PaulMaxAvalosAguilar/NN54/ABISoftware/Encoder-SDT/AndroidR/android-build/build/intermediates/manifest_merge_blame_file/release/manifest-merger-blame-release-report.txt

1<?xml version="1.0" encoding="utf-8"?>
2<manifest xmlns:android="http://schemas.android.com/apk/res/android"
3    package="org.qtproject.example"
4    android:installLocation="auto"
5    android:versionCode="1"
6    android:versionName="1.0" >
7
8    <uses-sdk
8-->D:\pauld\Programming\NN54\ABISoftware\Encoder-SDT\AndroidR\android-build\AndroidManifest.xml:3:5-73
9        android:minSdkVersion="21"
9-->D:\pauld\Programming\NN54\ABISoftware\Encoder-SDT\AndroidR\android-build\AndroidManifest.xml:3:15-41
10        android:targetSdkVersion="28" />
10-->D:\pauld\Programming\NN54\ABISoftware\Encoder-SDT\AndroidR\android-build\AndroidManifest.xml:3:42-71
11
12    <!--
13         The following comment will be replaced upon deployment with default permissions based on the dependencies of the application.
14         Remove the comment if you do not require these default permissions.
15    -->
16    <uses-permission android:name="android.permission.INTERNET" />
16-->D:\pauld\Programming\NN54\ABISoftware\Encoder-SDT\AndroidR\android-build\AndroidManifest.xml:7:5-67
16-->D:\pauld\Programming\NN54\ABISoftware\Encoder-SDT\AndroidR\android-build\AndroidManifest.xml:7:22-64
17    <uses-permission android:name="android.permission.WRITE_EXTERNAL_STORAGE" />
17-->D:\pauld\Programming\NN54\ABISoftware\Encoder-SDT\AndroidR\android-build\AndroidManifest.xml:8:5-81
17-->D:\pauld\Programming\NN54\ABISoftware\Encoder-SDT\AndroidR\android-build\AndroidManifest.xml:8:22-78
18    <uses-permission android:name="android.permission.ACCESS_NETWORK_STATE" />
18-->D:\pauld\Programming\NN54\ABISoftware\Encoder-SDT\AndroidR\android-build\AndroidManifest.xml:9:5-79
18-->D:\pauld\Programming\NN54\ABISoftware\Encoder-SDT\AndroidR\android-build\AndroidManifest.xml:9:22-76
19    <uses-permission android:name="android.permission.BLUETOOTH" />
19-->D:\pauld\Programming\NN54\ABISoftware\Encoder-SDT\AndroidR\android-build\AndroidManifest.xml:10:5-68
19-->D:\pauld\Programming\NN54\ABISoftware\Encoder-SDT\AndroidR\android-build\AndroidManifest.xml:10:22-65
20    <uses-permission android:name="android.permission.BLUETOOTH_ADMIN" />
20-->D:\pauld\Programming\NN54\ABISoftware\Encoder-SDT\AndroidR\android-build\AndroidManifest.xml:11:5-74
20-->D:\pauld\Programming\NN54\ABISoftware\Encoder-SDT\AndroidR\android-build\AndroidManifest.xml:11:22-71
21    <uses-permission android:name="android.permission.ACCESS_COARSE_LOCATION" />
21-->D:\pauld\Programming\NN54\ABISoftware\Encoder-SDT\AndroidR\android-build\AndroidManifest.xml:12:5-81
21-->D:\pauld\Programming\NN54\ABISoftware\Encoder-SDT\AndroidR\android-build\AndroidManifest.xml:12:22-78
22    <uses-permission android:name="android.permission.CAMERA" />
22-->D:\pauld\Programming\NN54\ABISoftware\Encoder-SDT\AndroidR\android-build\AndroidManifest.xml:13:5-65
22-->D:\pauld\Programming\NN54\ABISoftware\Encoder-SDT\AndroidR\android-build\AndroidManifest.xml:13:22-62
23    <uses-permission android:name="android.permission.RECORD_AUDIO" />
23-->D:\pauld\Programming\NN54\ABISoftware\Encoder-SDT\AndroidR\android-build\AndroidManifest.xml:14:5-71
23-->D:\pauld\Programming\NN54\ABISoftware\Encoder-SDT\AndroidR\android-build\AndroidManifest.xml:14:22-68
24
25    <!--
26         The following comment will be replaced upon deployment with default features based on the dependencies of the application.
27         Remove the comment if you do not require these default features.
28    -->
29    <uses-feature
29-->D:\pauld\Programming\NN54\ABISoftware\Encoder-SDT\AndroidR\android-build\AndroidManifest.xml:18:5-85
30        android:name="android.hardware.camera"
30-->D:\pauld\Programming\NN54\ABISoftware\Encoder-SDT\AndroidR\android-build\AndroidManifest.xml:18:19-57
31        android:required="false" />
31-->D:\pauld\Programming\NN54\ABISoftware\Encoder-SDT\AndroidR\android-build\AndroidManifest.xml:18:58-82
32    <uses-feature
32-->D:\pauld\Programming\NN54\ABISoftware\Encoder-SDT\AndroidR\android-build\AndroidManifest.xml:19:5-95
33        android:name="android.hardware.camera.autofocus"
33-->D:\pauld\Programming\NN54\ABISoftware\Encoder-SDT\AndroidR\android-build\AndroidManifest.xml:19:19-67
34        android:required="false" />
34-->D:\pauld\Programming\NN54\ABISoftware\Encoder-SDT\AndroidR\android-build\AndroidManifest.xml:19:68-92
35    <uses-feature
35-->D:\pauld\Programming\NN54\ABISoftware\Encoder-SDT\AndroidR\android-build\AndroidManifest.xml:20:5-89
36        android:name="android.hardware.microphone"
36-->D:\pauld\Programming\NN54\ABISoftware\Encoder-SDT\AndroidR\android-build\AndroidManifest.xml:20:19-61
37        android:required="false" />
37-->D:\pauld\Programming\NN54\ABISoftware\Encoder-SDT\AndroidR\android-build\AndroidManifest.xml:20:62-86
38
39    <supports-screens
39-->D:\pauld\Programming\NN54\ABISoftware\Encoder-SDT\AndroidR\android-build\AndroidManifest.xml:22:5-135
40        android:anyDensity="true"
40-->D:\pauld\Programming\NN54\ABISoftware\Encoder-SDT\AndroidR\android-build\AndroidManifest.xml:22:80-105
41        android:largeScreens="true"
41-->D:\pauld\Programming\NN54\ABISoftware\Encoder-SDT\AndroidR\android-build\AndroidManifest.xml:22:23-50
42        android:normalScreens="true"
42-->D:\pauld\Programming\NN54\ABISoftware\Encoder-SDT\AndroidR\android-build\AndroidManifest.xml:22:51-79
43        android:smallScreens="true" />
43-->D:\pauld\Programming\NN54\ABISoftware\Encoder-SDT\AndroidR\android-build\AndroidManifest.xml:22:106-133
44
45    <application
45-->D:\pauld\Programming\NN54\ABISoftware\Encoder-SDT\AndroidR\android-build\AndroidManifest.xml:24:5-94:19
46        android:name="org.qtproject.qt5.android.bindings.QtApplication"
46-->D:\pauld\Programming\NN54\ABISoftware\Encoder-SDT\AndroidR\android-build\AndroidManifest.xml:24:53-116
47        android:extractNativeLibs="true"
47-->D:\pauld\Programming\NN54\ABISoftware\Encoder-SDT\AndroidR\android-build\AndroidManifest.xml:24:145-177
48        android:hardwareAccelerated="true"
48-->D:\pauld\Programming\NN54\ABISoftware\Encoder-SDT\AndroidR\android-build\AndroidManifest.xml:24:18-52
49        android:icon="@drawable/icon"
49-->D:\pauld\Programming\NN54\ABISoftware\Encoder-SDT\AndroidR\android-build\AndroidManifest.xml:24:178-207
50        android:label="Encoder-SDT" >
50-->D:\pauld\Programming\NN54\ABISoftware\Encoder-SDT\AndroidR\android-build\AndroidManifest.xml:24:117-144
51        <activity
51-->D:\pauld\Programming\NN54\ABISoftware\Encoder-SDT\AndroidR\android-build\AndroidManifest.xml:25:9-90:16
52            android:name="org.qtproject.qt5.android.bindings.QtActivity"
52-->D:\pauld\Programming\NN54\ABISoftware\Encoder-SDT\AndroidR\android-build\AndroidManifest.xml:25:189-249
53            android:configChanges="orientation|uiMode|screenLayout|screenSize|smallestScreenSize|layoutDirection|locale|fontScale|keyboard|keyboardHidden|navigation|mcc|mnc|density"
53-->D:\pauld\Programming\NN54\ABISoftware\Encoder-SDT\AndroidR\android-build\AndroidManifest.xml:25:19-188
54            android:label="Encoder-SDT"
54-->D:\pauld\Programming\NN54\ABISoftware\Encoder-SDT\AndroidR\android-build\AndroidManifest.xml:25:250-277
55            android:launchMode="singleTop"
55-->D:\pauld\Programming\NN54\ABISoftware\Encoder-SDT\AndroidR\android-build\AndroidManifest.xml:25:322-352
56            android:screenOrientation="sensorLandscape" >
56-->D:\pauld\Programming\NN54\ABISoftware\Encoder-SDT\AndroidR\android-build\AndroidManifest.xml:25:278-321
57            <intent-filter>
57-->D:\pauld\Programming\NN54\ABISoftware\Encoder-SDT\AndroidR\android-build\AndroidManifest.xml:26:13-29:29
58                <action android:name="android.intent.action.MAIN" />
58-->D:\pauld\Programming\NN54\ABISoftware\Encoder-SDT\AndroidR\android-build\AndroidManifest.xml:27:17-68
58-->D:\pauld\Programming\NN54\ABISoftware\Encoder-SDT\AndroidR\android-build\AndroidManifest.xml:27:25-66
59
60                <category android:name="android.intent.category.LAUNCHER" />
60-->D:\pauld\Programming\NN54\ABISoftware\Encoder-SDT\AndroidR\android-build\AndroidManifest.xml:28:17-76
60-->D:\pauld\Programming\NN54\ABISoftware\Encoder-SDT\AndroidR\android-build\AndroidManifest.xml:28:27-74
61            </intent-filter>
62
63            <!-- Application arguments -->
64            <!-- meta-data android:name="android.app.arguments" android:value="arg1 arg2 arg3"/ -->
65            <!-- Application arguments -->
66
67            <meta-data
67-->D:\pauld\Programming\NN54\ABISoftware\Encoder-SDT\AndroidR\android-build\AndroidManifest.xml:35:13-89
68                android:name="android.app.lib_name"
68-->D:\pauld\Programming\NN54\ABISoftware\Encoder-SDT\AndroidR\android-build\AndroidManifest.xml:35:24-59
69                android:value="Encoder-SDT" />
69-->D:\pauld\Programming\NN54\ABISoftware\Encoder-SDT\AndroidR\android-build\AndroidManifest.xml:35:60-87
70            <meta-data
70-->D:\pauld\Programming\NN54\ABISoftware\Encoder-SDT\AndroidR\android-build\AndroidManifest.xml:36:13-112
71                android:name="android.app.qt_sources_resource_id"
71-->D:\pauld\Programming\NN54\ABISoftware\Encoder-SDT\AndroidR\android-build\AndroidManifest.xml:36:24-73
72                android:resource="@array/qt_sources" />
72-->D:\pauld\Programming\NN54\ABISoftware\Encoder-SDT\AndroidR\android-build\AndroidManifest.xml:36:74-110
73            <meta-data
73-->D:\pauld\Programming\NN54\ABISoftware\Encoder-SDT\AndroidR\android-build\AndroidManifest.xml:37:13-87
74                android:name="android.app.repository"
74-->D:\pauld\Programming\NN54\ABISoftware\Encoder-SDT\AndroidR\android-build\AndroidManifest.xml:37:24-61
75                android:value="default" />
75-->D:\pauld\Programming\NN54\ABISoftware\Encoder-SDT\AndroidR\android-build\AndroidManifest.xml:37:62-85
76            <meta-data
76-->D:\pauld\Programming\NN54\ABISoftware\Encoder-SDT\AndroidR\android-build\AndroidManifest.xml:38:13-106
77                android:name="android.app.qt_libs_resource_id"
77-->D:\pauld\Programming\NN54\ABISoftware\Encoder-SDT\AndroidR\android-build\AndroidManifest.xml:38:24-70
78                android:resource="@array/qt_libs" />
78-->D:\pauld\Programming\NN54\ABISoftware\Encoder-SDT\AndroidR\android-build\AndroidManifest.xml:38:71-104
79            <meta-data
79-->D:\pauld\Programming\NN54\ABISoftware\Encoder-SDT\AndroidR\android-build\AndroidManifest.xml:39:13-116
80                android:name="android.app.bundled_libs_resource_id"
80-->D:\pauld\Programming\NN54\ABISoftware\Encoder-SDT\AndroidR\android-build\AndroidManifest.xml:39:24-75
81                android:resource="@array/bundled_libs" />
81-->D:\pauld\Programming\NN54\ABISoftware\Encoder-SDT\AndroidR\android-build\AndroidManifest.xml:39:76-114
82            <!-- Deploy Qt libs as part of package -->
83            <meta-data
83-->D:\pauld\Programming\NN54\ABISoftware\Encoder-SDT\AndroidR\android-build\AndroidManifest.xml:41:13-91
84                android:name="android.app.bundle_local_qt_libs"
84-->D:\pauld\Programming\NN54\ABISoftware\Encoder-SDT\AndroidR\android-build\AndroidManifest.xml:41:24-71
85                android:value="1" />
85-->D:\pauld\Programming\NN54\ABISoftware\Encoder-SDT\AndroidR\android-build\AndroidManifest.xml:41:72-89
86
87            <!-- Run with local libs -->
88            <meta-data
88-->D:\pauld\Programming\NN54\ABISoftware\Encoder-SDT\AndroidR\android-build\AndroidManifest.xml:44:13-88
89                android:name="android.app.use_local_qt_libs"
89-->D:\pauld\Programming\NN54\ABISoftware\Encoder-SDT\AndroidR\android-build\AndroidManifest.xml:44:24-68
90                android:value="1" />
90-->D:\pauld\Programming\NN54\ABISoftware\Encoder-SDT\AndroidR\android-build\AndroidManifest.xml:44:69-86
91            <meta-data
91-->D:\pauld\Programming\NN54\ABISoftware\Encoder-SDT\AndroidR\android-build\AndroidManifest.xml:45:13-100
92                android:name="android.app.libs_prefix"
92-->D:\pauld\Programming\NN54\ABISoftware\Encoder-SDT\AndroidR\android-build\AndroidManifest.xml:45:24-62
93                android:value="/data/local/tmp/qt/" />
93-->D:\pauld\Programming\NN54\ABISoftware\Encoder-SDT\AndroidR\android-build\AndroidManifest.xml:45:63-98
94            <meta-data
94-->D:\pauld\Programming\NN54\ABISoftware\Encoder-SDT\AndroidR\android-build\AndroidManifest.xml:46:13-122
95                android:name="android.app.load_local_libs_resource_id"
95-->D:\pauld\Programming\NN54\ABISoftware\Encoder-SDT\AndroidR\android-build\AndroidManifest.xml:46:24-78
96                android:resource="@array/load_local_libs" />
96-->D:\pauld\Programming\NN54\ABISoftware\Encoder-SDT\AndroidR\android-build\AndroidManifest.xml:46:79-120
97            <meta-data
97-->D:\pauld\Programming\NN54\ABISoftware\Encoder-SDT\AndroidR\android-build\AndroidManifest.xml:47:13-221
98                android:name="android.app.load_local_jars"
98-->D:\pauld\Programming\NN54\ABISoftware\Encoder-SDT\AndroidR\android-build\AndroidManifest.xml:47:24-66
99                android:value="jar/QtAndroid.jar:jar/QtAndroidExtras.jar:jar/QtAndroidBearer.jar:jar/QtAndroidBluetooth.jar:jar/QtMultimedia.jar:jar/QtTextToSpeech.jar" />
99-->D:\pauld\Programming\NN54\ABISoftware\Encoder-SDT\AndroidR\android-build\AndroidManifest.xml:47:67-219
100            <meta-data
100-->D:\pauld\Programming\NN54\ABISoftware\Encoder-SDT\AndroidR\android-build\AndroidManifest.xml:48:13-208
101                android:name="android.app.static_init_classes"
101-->D:\pauld\Programming\NN54\ABISoftware\Encoder-SDT\AndroidR\android-build\AndroidManifest.xml:48:24-70
102                android:value="org.qtproject.qt5.android.bluetooth.QtBluetoothBroadcastReceiver:org.qtproject.qt5.android.multimedia.QtMultimediaUtils" />
102-->D:\pauld\Programming\NN54\ABISoftware\Encoder-SDT\AndroidR\android-build\AndroidManifest.xml:48:71-206
103            <!-- Used to specify custom system library path to run with local system libs -->
104            <!-- <meta-data android:name="android.app.system_libs_prefix" android:value="/system/lib/"/> -->
105            <!-- Messages maps -->
106            <meta-data
106-->D:\pauld\Programming\NN54\ABISoftware\Encoder-SDT\AndroidR\android-build\AndroidManifest.xml:52:13-122
107                android:name="android.app.ministro_not_found_msg"
107-->D:\pauld\Programming\NN54\ABISoftware\Encoder-SDT\AndroidR\android-build\AndroidManifest.xml:52:71-120
108                android:value="@string/ministro_not_found_msg" />
108-->D:\pauld\Programming\NN54\ABISoftware\Encoder-SDT\AndroidR\android-build\AndroidManifest.xml:52:24-70
109            <meta-data
109-->D:\pauld\Programming\NN54\ABISoftware\Encoder-SDT\AndroidR\android-build\AndroidManifest.xml:53:13-116
110                android:name="android.app.ministro_needed_msg"
110-->D:\pauld\Programming\NN54\ABISoftware\Encoder-SDT\AndroidR\android-build\AndroidManifest.xml:53:68-114
111                android:value="@string/ministro_needed_msg" />
111-->D:\pauld\Programming\NN54\ABISoftware\Encoder-SDT\AndroidR\android-build\AndroidManifest.xml:53:24-67
112            <meta-data
112-->D:\pauld\Programming\NN54\ABISoftware\Encoder-SDT\AndroidR\android-build\AndroidManifest.xml:54:13-108
113                android:name="android.app.fatal_error_msg"
113-->D:\pauld\Programming\NN54\ABISoftware\Encoder-SDT\AndroidR\android-build\AndroidManifest.xml:54:64-106
114                android:value="@string/fatal_error_msg" />
114-->D:\pauld\Programming\NN54\ABISoftware\Encoder-SDT\AndroidR\android-build\AndroidManifest.xml:54:24-63
115            <meta-data
115-->D:\pauld\Programming\NN54\ABISoftware\Encoder-SDT\AndroidR\android-build\AndroidManifest.xml:55:13-132
116                android:name="android.app.unsupported_android_version"
116-->D:\pauld\Programming\NN54\ABISoftware\Encoder-SDT\AndroidR\android-build\AndroidManifest.xml:55:76-130
117                android:value="@string/unsupported_android_version" />
117-->D:\pauld\Programming\NN54\ABISoftware\Encoder-SDT\AndroidR\android-build\AndroidManifest.xml:55:24-75
118            <!-- Messages maps -->
119
120
121            <!-- Splash screen -->
122            <!--
123                 Orientation-specific (portrait/landscape) data is checked first. If not available for current orientation,
124                 then android.app.splash_screen_drawable. For best results, use together with splash_screen_sticky and
125                 use hideSplashScreen() with a fade-out animation from Qt Android Extras to hide the splash screen when you
126                 are done populating your window with content.
127            -->
128            <!-- meta-data android:name="android.app.splash_screen_drawable_portrait" android:resource="@drawable/logo_portrait" / -->
129            <!-- meta-data android:name="android.app.splash_screen_drawable_landscape" android:resource="@drawable/logo_landscape" / -->
130            <!-- meta-data android:name="android.app.splash_screen_drawable" android:resource="@drawable/logo"/ -->
131            <!-- meta-data android:name="android.app.splash_screen_sticky" android:value="true"/ -->
132            <!-- Splash screen -->
133
134
135            <!-- Background running -->
136            <!--
137                 Warning: changing this value to true may cause unexpected crashes if the
138                          application still try to draw after
139                          "applicationStateChanged(Qt::ApplicationSuspended)"
140                          signal is sent!
141            -->
142            <meta-data
142-->D:\pauld\Programming\NN54\ABISoftware\Encoder-SDT\AndroidR\android-build\AndroidManifest.xml:74:13-93
143                android:name="android.app.background_running"
143-->D:\pauld\Programming\NN54\ABISoftware\Encoder-SDT\AndroidR\android-build\AndroidManifest.xml:74:24-69
144                android:value="false" />
144-->D:\pauld\Programming\NN54\ABISoftware\Encoder-SDT\AndroidR\android-build\AndroidManifest.xml:74:70-91
145            <!-- Background running -->
146
147
148            <!-- auto screen scale factor -->
149            <meta-data
149-->D:\pauld\Programming\NN54\ABISoftware\Encoder-SDT\AndroidR\android-build\AndroidManifest.xml:78:13-99
150                android:name="android.app.auto_screen_scale_factor"
150-->D:\pauld\Programming\NN54\ABISoftware\Encoder-SDT\AndroidR\android-build\AndroidManifest.xml:78:24-75
151                android:value="false" />
151-->D:\pauld\Programming\NN54\ABISoftware\Encoder-SDT\AndroidR\android-build\AndroidManifest.xml:78:76-97
152            <!-- auto screen scale factor -->
153
154
155            <!-- extract android style -->
156            <!--
157                 available android:values :
158                * default - In most cases this will be the same as "full", but it can also be something else if needed, e.g., for compatibility reasons
159                * full - useful QWidget & Quick Controls 1 apps
160                * minimal - useful for Quick Controls 2 apps, it is much faster than "full"
161                * none - useful for apps that don't use any of the above Qt modules
162            -->
163            <meta-data
163-->D:\pauld\Programming\NN54\ABISoftware\Encoder-SDT\AndroidR\android-build\AndroidManifest.xml:88:13-98
164                android:name="android.app.extract_android_style"
164-->D:\pauld\Programming\NN54\ABISoftware\Encoder-SDT\AndroidR\android-build\AndroidManifest.xml:88:24-72
165                android:value="default" />
165-->D:\pauld\Programming\NN54\ABISoftware\Encoder-SDT\AndroidR\android-build\AndroidManifest.xml:88:73-96
166            <!-- extract android style -->
167        </activity>
168
169        <!-- For adding service(s) please check: https://wiki.qt.io/AndroidServices -->
170
171    </application>
172
173</manifest>
