PaulMaxAvalosAguilar/NN54/Mechatronics/Hardware/Electrical/LoadSharingCalculations.ods

DiodeMaxLeakageCurrent | 5E-05
PMOSMaxVgths | 1
BattMax Voltage | 4.5
BattMin Voltage | 2.4
Resistor | 10000
DiodeResistance | 90000
R2 | 0.45
MaxAllowedVoltage | 1.4
