PaulMaxAvalosAguilar/NN54/Logo.pdf

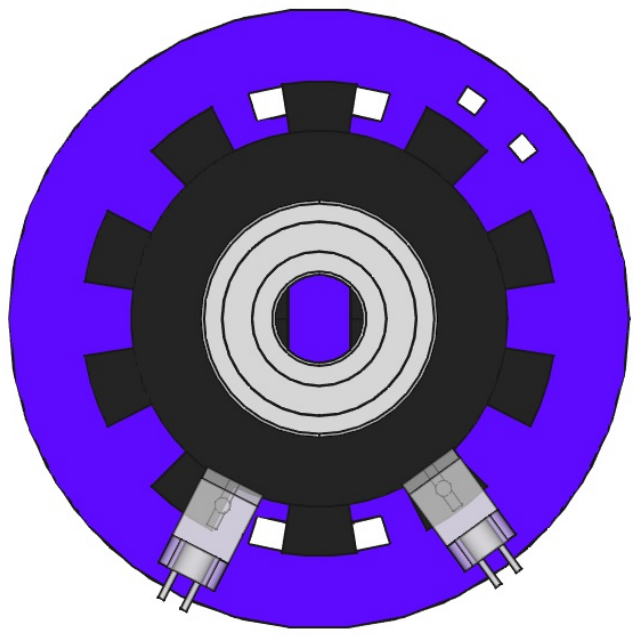
[picture p3: page 1]
