PaulMaxAvalosAguilar/NN54/Corporative/Accelera.png

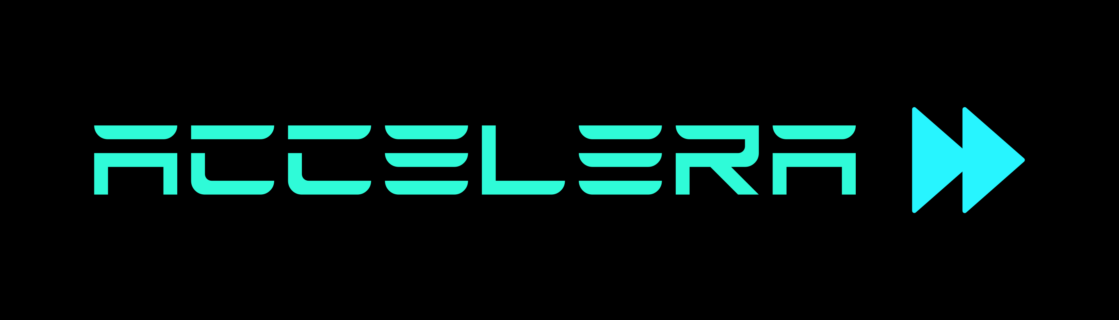
Corporative/Accelera.png
