PaulMaxAvalosAguilar/NN54/Corporative/BoxLabels.png

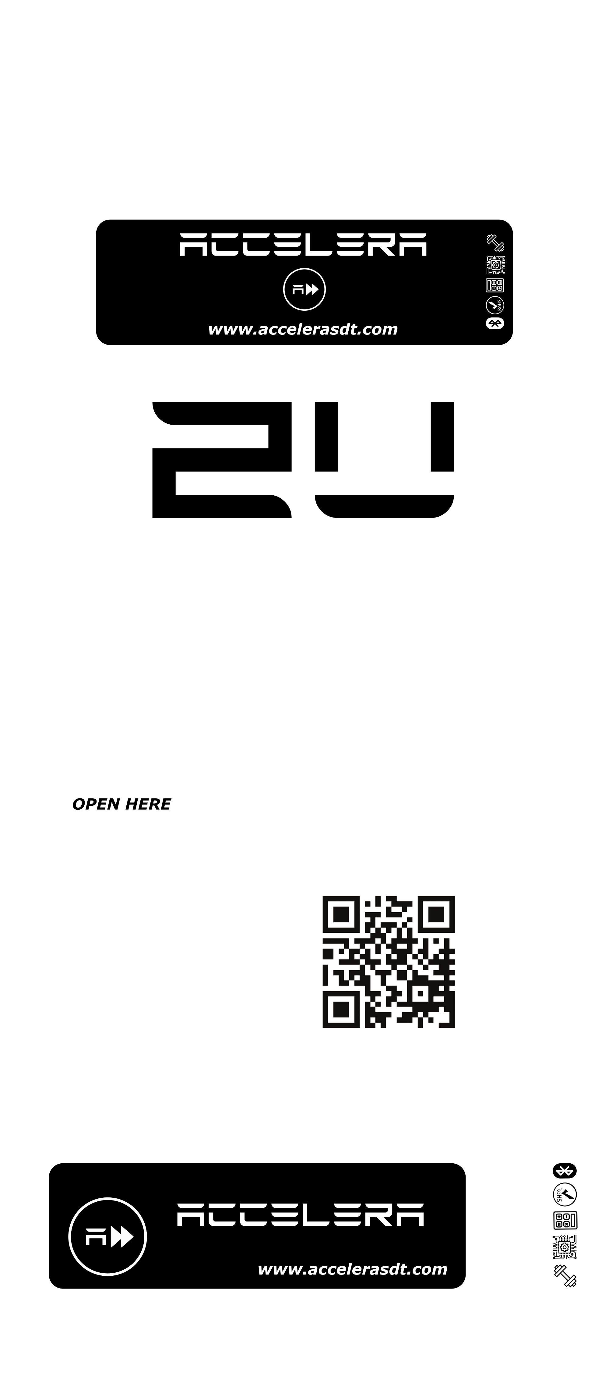
Corporative/BoxLabels.png
