PaulMaxAvalosAguilar/NN54/Corporative/NPULTRA.png

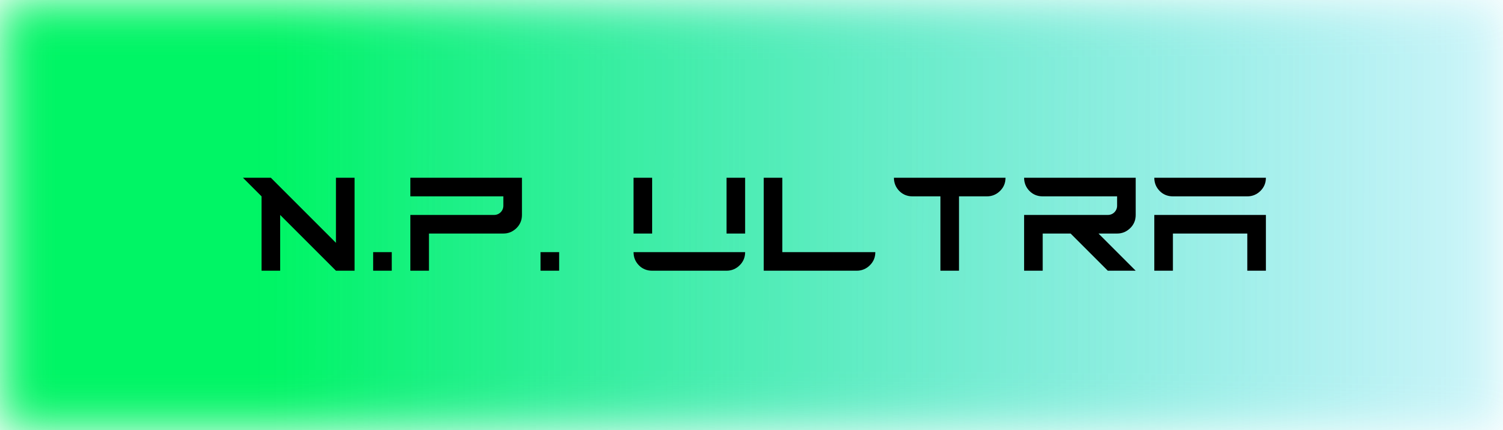
Corporative/NPULTRA.png
