PaulMaxAvalosAguilar/NN54/Mechatronics/Hardware/Electrical/CBOM/EncoderBoard2.xlsx

Item | Qty | Reference(s) | Value | Footprint
1 | 2 | C1, C2 | 12pF | Encoder:C_0603_1608Metric_Pad1.05x0.95mm_HandSolder
2 | 2 | C3, C17 | 4.7uF | Encoder:C_0603_1608Metric_Pad1.05x0.95mm_HandSolder
3 | 7 | C4, C5, C8, C9, C15, C27, C27 | 100nF | Encoder:C_0603_1608Metric_Pad1.05x0.95mm_HandSolder
4 | 6 | C6, C10, C12, C13, C16, C18 | 1uF | Encoder:C_0603_1608Metric_Pad1.05x0.95mm_HandSolder
5 | 1 | C7 | 10nF | Encoder:C_0603_1608Metric_Pad1.05x0.95mm_HandSolder
6 | 2 | C11, C14 | 10uF | Encoder:C_0603_1608Metric_Pad1.05x0.95mm_HandSolder
7 | 8 | C19, C20, C21, C22, C23, C24, C25, C26 | 3.2uF | Encoder:C_0603_1608Metric_Pad1.05x0.95mm_HandSolder
8 | 1 | J3 | Barrel_Jack_Switch | Encoder:BarrelJack_Horizontal
9 | 1 | J1 | Conn_01x08_Male | Encoder:PinHeader_1x08_P2.54mm_Vertical
10 | 1 | J2 | Conn_01x07_Male | Encoder:PinHeader_1x07_P2.54mm_Vertical
11 | 1 | J4 | GNDPWR | Encoder:PinHeader_1x01_P2.54mm_Vertical
12 | 1 | J5 | Conn_01x02_Male | Encoder:PinHeader_1x02_P2.54mm_Vertical
13 | 1 | J6 | Conn_01x04_Male | Encoder:PinHeader_2x02_P2.54mm_Vertical
14 | 2 | U2,U3 | ITR8102_Conn | Encoder:PinHeader_2x02_P2.54mm_Vertical
15 | 1 | S1 | EG1218_Conn | Encoder:PinHeader_1x04_P2.54mm_Vertical
16 | 2 | R1, R2 | 560 | Encoder:R_0603_1608Metric_Pad1.05x0.95mm_HandSolder
17 | 2 | R3, R4 | 1.2K | Encoder:R_0603_1608Metric_Pad1.05x0.95mm_HandSolder
18 | 1 | R6 | 1.5K | Encoder:R_0603_1608Metric_Pad1.05x0.95mm_HandSolder | 1/16 5%
19 | 5 | R5, R9, R10, R19, R20 | 10K | Encoder:R_0603_1608Metric_Pad1.05x0.95mm_HandSolder
20 | 1 | R7 | 1K | Encoder:R_0603_1608Metric_Pad1.05x0.95mm_HandSolder
21 | 9 | R8, R11, R12, R13, R14, R15, R16, R17, R18 | 100 | Encoder:R_0603_1608Metric_Pad1.05x0.95mm_HandSolder | ¼
22 | 1 | Y1 | 8Mhz | Encoder:Crystal_HC49-U_Vertical
23 | 1 | IC1 | TP4056 | Encoder:Sop(8)
24 | 1 | IC2 | DW01+G | Encoder:Sot-23(6)
25 | 1 | Q1 | Dmosfet (FS8205) | Encoder:Sot-23(6)
26 | 1 | D1 | D (1N4007G ) | Encoder:D_SMA
27 | 2 | Q2, Q3 | Q_PMOS_GSD ( DMP1045U-7) | Encoder:SOT-23
28 | 1 | U1 | STM32G431CBT6 | Encoder:LQFP-48_7x7mm_P0.5mm
29 | 1 | U4 | RN4871 | Encoder:Bluetooth_Module_RN4871
30 | 1 | U5 | 82402305 | Encoder:Sot-23(6)
31 | 1 | U6 | LTC3240 | Encoder:DFN-6_DC
32 | 1 | S1 | EG1218
33 | 2 | U7, U7 | TLE5009 | Encoder:SO-8_3.9x4.9mm_P1.27mm
34 | 1 |  | SSD1306
35 | 2 | U8,U8 | ITR8102
