PaulMaxAvalosAguilar/NN54/Mechatronics/Hardware/Electrical/CBOM/EncoderBoard3.xlsx

Item | Qty | Board1 | Board2 | Board3 | Board4 | External | Reference(s) | Value | Footprint | Quantity
1 | 2 | 2 |  |  |  |  | C1, C3 | 12pF | 0603_1608Metric | 94
2 | 9 | 7 |  |  | 2 |  | C2, C4, C5, C9, C10, C11, C16, C22, C23 | 100nF | 0603_1608Metric | 77
3 | 3 | 3 |  |  |  |  | C6, C12, C13 | 4.7uF | 0603_1608Metric | 14
4 | 1 | 1 |  |  |  |  | C7 | 10nF | 0603_1608Metric | 49
5 | 4 | 3 |  | 1 |  |  | C8, C14, C15,C21 | 1uF | 0603_1608Metric | 30
6 | 2 | 1 |  | 1 |  |  | C17, C20 | 10uF | 0603_1608Metric | 42
7 | 2 |  |  | 2 |  |  | C18, C19 |  | 0403_1005Metric
8 | 2 | 2 |  |  |  |  | R1, R3 | 1.2K | 0603_1608Metric | 96
9 | 2 | 2 |  |  |  |  | R2, R4 | 560 | 0603_1608Metric | 97
10 | 6 | 6 |  |  |  |  | R5, R7, R8, R9, R12, R16 | 10K | 0603_1608Metric | 80
11 | 2 | 2 |  |  |  |  | R6, R14 | 1K | 0603_1608Metric | 96
12 | 2 | 2 |  |  |  |  | R10, R11 | 5.1k | 0603_1608Metric
13 | 1 | 1 |  |  |  |  | R13 | 100 | 0603_1608Metric | 37
14 | 1 | 1 |  |  |  |  | R15 | 1.5K | 0603_1608Metric | 97
15 | 1 |  |  | 1 |  |  | R17 | 0 | 0403_1005Metric
16 | 1 | 1 |  |  |  |  | J8 | 1x02_Male | JST_EH_B2B-EH-A_1x02_P2.50mm_Vertical
17 | 1 | 1 |  |  |  |  | J7 | 1x03_Male | JST_EH_B2B-EH-A_1x02_P2.50mm_Vertical
18 | 2 | 2 |  |  |  |  | J3, J4 | 01x04_Male | JST_EH_B4B-EH-A_1x04_P2.50mm_Vertical
19 | 1 | 1 |  |  |  |  | J6 | 01x06_Male | JST_EH_B6B-EH-A_1x06_P2.50mm_Vertical
20 | 1 | 1 |  |  |  |  | J1 | 01x08_Male | JST_EH_B8B-EH-A_1x08_P2.50mm_Vertical
21 | 2 | 2 |  |  |  |  | J2, J5 | 01x03_Male | PinHeader_1x03_P2.54mm_Vertical | 91
22 | 23 | 23 |  |  |  |  | SEH-001T-P0.6 | SHE-001T-P0.6 | JST_EH
23 | 1 | 1 |  |  |  |  | D1 | 1N4007G | SMA | 50
24 | 2 | 2 |  |  |  |  | Q1, Q2 | DMP1045U-7 | SOT-23_PMOS_GSD | 4
25 | 2 |  | 2 |  |  |  | Q3,Q4 | ITR8102 | Sloted switch | 8
26 | 2 | 2 |  |  |  |  | U1, U2 | STM32G431KBT6 | LQFP-32_7x7mm_P0.8mm | 4
27 | 1 | 1 |  |  |  |  | U3 | LTC3240 | DFN-6_DC | 2
28 | 1 | 1 |  |  |  |  | U4 | 82402305 | Sot-23(6) | 2
29 | 1 | 1 |  |  |  |  | U5 | DW01 | Sot-23(6) | 19+46(+G)
30 | 1 | 1 |  |  |  |  | U6 | FS8205 | Sot-23(6) | 11
31 | 1 | 1 |  |  |  |  | U7 | TP4056 | Sop(8) | 49
32 | 1 |  |  | 1 |  |  | U8 | RN4871u | RN4871u
33 | 1 |  |  |  | 1 |  | U9 | LSM6DSRXTR | LSM6DSRXTR | 2
34 | 1 | 1 |  |  |  |  | Y1 | 8Mhz | Crystal_HC49-U_Vertical | 7
35 | 1 | 1 |  |  |  |  | P1 | TYPE-C-31-M-12 | HRO_TYPE-C-31-M-12
36 | 1 |  |  |  |  | 1 | S1 | EG1218 | SPDT | 8
37 | 1 |  |  |  |  | 1 | DS1 | SSD1306 | SSD1306 | 1
 |  |  |  |  |  | 3 | 3 | Spacers | 20mm
 | 89 | 76 | 2 | 6 | 3 | 5
31 | 1 | Y1 | 8Mhz | Device:Crystal | Encoder:Crystal_HC49-U_Vertical
8 | 1 | J1 | Conn_01x08_Male | Connector:Conn_01x08_Male | Encoder:JST_EH_B8B-EH-A_1x08_P2.50mm_Vertical
9 | 2 | J2, J5 | Conn_01x03_Male | Connector:Conn_01x03_Male | Encoder:PinHeader_1x03_P2.54mm_Vertical
10 | 2 | J3, J4 | Conn_01x04_Male | Connector:Conn_01x04_Male | Encoder:JST_EH_B4B-EH-A_1x04_P2.50mm_Vertical
11 | 1 | J6 | Conn_01x06_Male | Connector:Conn_01x06_Male | Encoder:JST_EH_B6B-EH-A_1x06_P2.50mm_Vertical
12 | 1 | J7 | Conn_01x03_Male | Encoder:Conn_01x03_Male | Connector_JST:JST_EH_B3B-EH-A_1x03_P2.50mm_Vertical
13 | 1 | J8 | Conn_01x02_Male | Connector:Conn_01x02_Male | Encoder:JST_EH_B2B-EH-A_1x02_P2.50mm_Vertical
14 | 1 | P1 | TYPE-C-31-M-12 | EncoderBoard3-rescue:TYPE-C-31-M-12-Encoder | Encoder:HRO_TYPE-C-31-M-12
 | 88
