PaulMaxAvalosAguilar/NN54/Mechatronics/Hardware/Electrical/BEncoderBoard/EncoderBoard_v1.0.xlsm

Component | Part | References | Value | Footprint | Quantity Per PCB
1 | C | C1 C2 C3 C5 C9 C10 C16 | 100nF | C_0603_1608Metric_Pad1.05x0.95mm_HandSolder | 7
2 | C | C6 C13 | 10uF | C_0603_1608Metric_Pad1.05x0.95mm_HandSolder | 2
3 | C | C7 C8 | 12pF | C_0603_1608Metric_Pad1.05x0.95mm_HandSolder | 2
4 | C | C4 C11 C14 C17 C18 | 1uF | C_0603_1608Metric_Pad1.05x0.95mm_HandSolder | 5
5 | C | C12 C15 | 4.7uF | C_0603_1608Metric_Pad1.05x0.95mm_HandSolder | 2
6 | D | D1 | D | D_SMA | 1
7 | DW01+G | IC3 | DW01+G | Sot-23(6) | 1
9 | TP4056 | IC2 | TP4056 | Sop(8) | 1
10 | FS8205 | Q1 | FS8205 | Sot-23(6) | 1
11 | Barrel_Jack_Switch | J4 | Barrel_Jack_Switch | BarrelJack_Horizontal | 1
12 | Conn_01x07_Male | J1 | Conn_01x07_Male | PinSocket_1x07_P2.54mm_Vertical | 1
13 | SSD1306OLED | U5 | SSD1306OLED | PinSocket_1x04_P2.54mm_Vertical | 1
8 | RN4020-V_RM120 | IC1 | RN4020-V_RM120 | Bluetooth_Module_RN4020 | 1
14 | Q_PMOS_GSD | Q2 Q3 | Q_PMOS_GSD | SOT-23 | 2
15 | R | R3 R4 R8 | 1.2K | R_0603_1608Metric_Pad1.05x0.95mm_HandSolder | 3
16 | R | R11 | 100 | R_0603_1608Metric_Pad1.05x0.95mm_HandSolder | 1 | ¼
17 | R | R5 R6 R7 R13 R14 | 10K | R_0603_1608Metric_Pad1.05x0.95mm_HandSolder | 5
18 | R | R9 | 1K | R_0603_1608Metric_Pad1.05x0.95mm_HandSolder | 1
19 | R | R1 R2 | 220 | R_0603_1608Metric_Pad1.05x0.95mm_HandSolder | 2
20 | EG1218 | S1 | EG1218 | Switch_Slide_11.6x4mm_EG1218 | 1
21 | 82402305 | U4 | 82402305 | Sot-23(6) | 1
22 | ITR1802 | U2 | ITR1802 | OptointerrupterConnector | 2
23 | LTC2430 | U6 | LTC3240 | DFN-6_DC | 1
24 | STM32F103C8T6 | U1 | STM32F103C8T6 | QFP50P900X900X160-48N | 1
25 | Crystal | Y1 | 8Mhz | Crystal_HC49-U_Vertical | 1
