PaulMaxAvalosAguilar/NN54/Mechatronics/MaterialDocumentation/BatteryPart/DC BarrelJack/XKB-DC-005B-2-5A-2-0_C319132.pdf

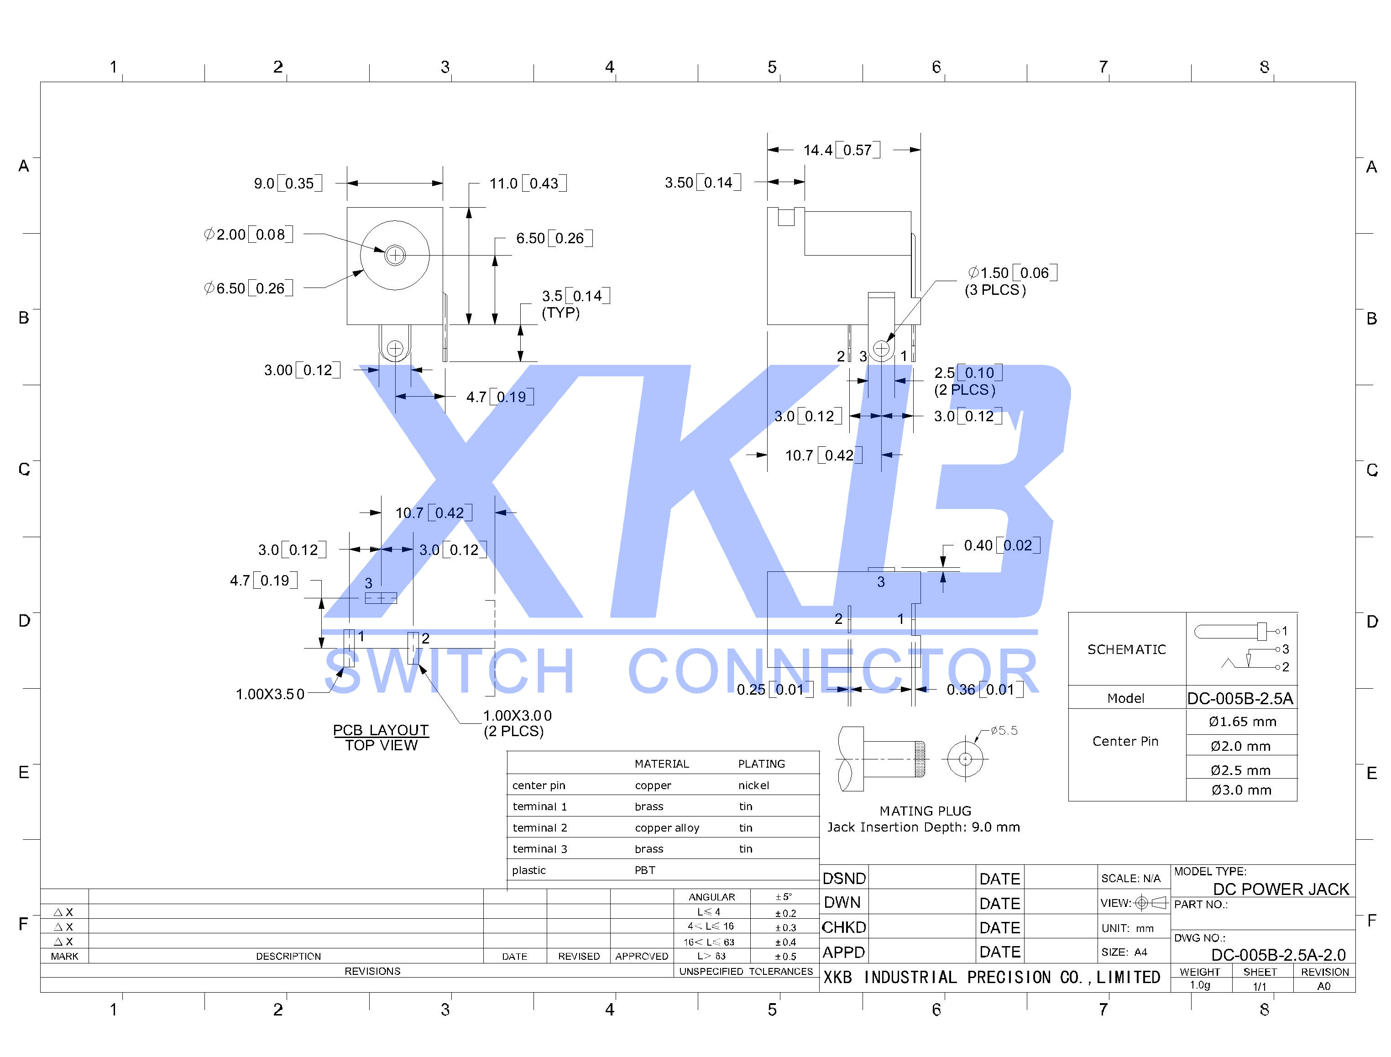
[picture p11: page 1]
