PaulMaxAvalosAguilar/NN54/Mechatronics/MaterialDocumentation/EncoderPart/OLEDScreen/29192059675_a23f346f87_o.jpg

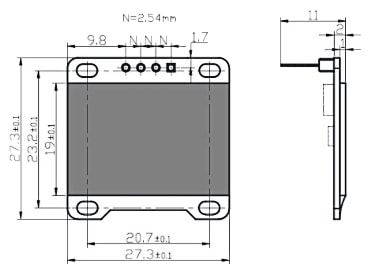
Mechatronics/MaterialDocumentation/EncoderPart/OLEDScreen/29192059675_a23f346f87_o.jpg
