PaulMaxAvalosAguilar/NN54/Mechatronics/MaterialDocumentation/EncoderPart/OLEDScreen/índice.png

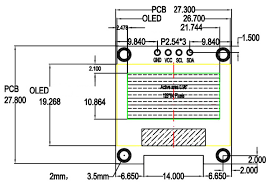
Mechatronics/MaterialDocumentation/EncoderPart/OLEDScreen/índice.png
