PaulMaxAvalosAguilar/NN54/Mechatronics/Hardware/Electrical/BEncoderBoard3(2)/BEncoderBoard3(2)(A).step

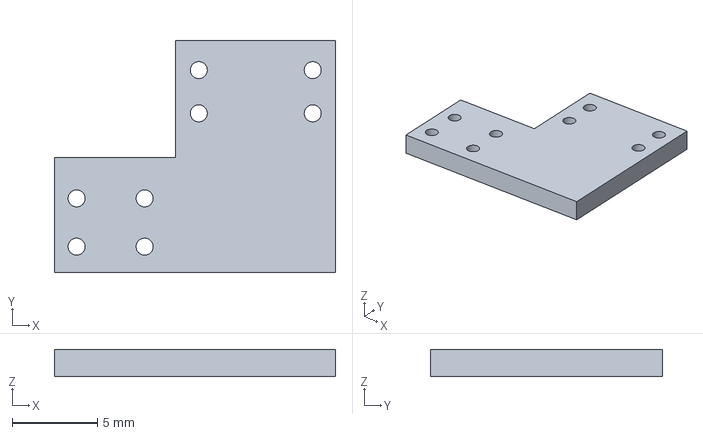
[picture p14: CAD file, 2022-12-06]
Mechatronics/Hardware/Electrical/BEncoderBoard3(2)/BEncoderBoard3(2)(A).step
16.5 x 13.7 x 1.60 mm
