PaulMaxAvalosAguilar/NN54/Mechatronics/Hardware/Electrical/BEncoderBoard3(4)/BEncoderBoard3(4).step

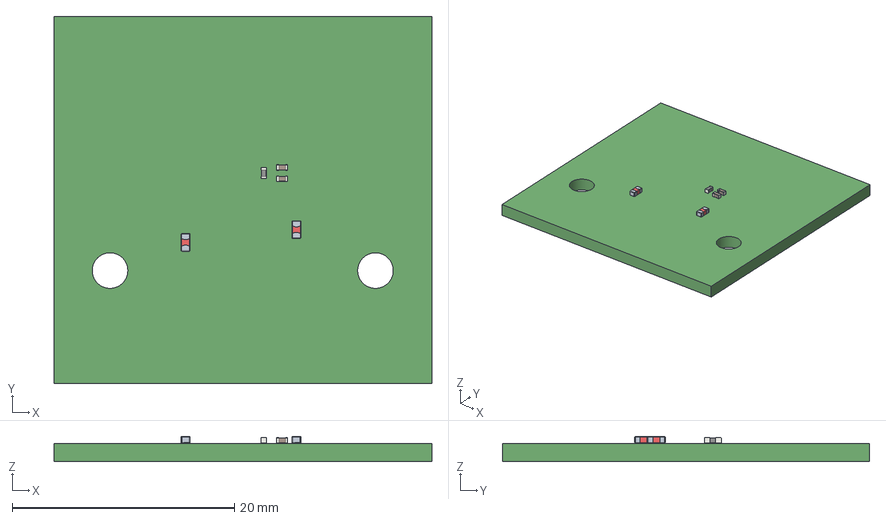
[picture p15: CAD file, 2022-12-06]
Mechatronics/Hardware/Electrical/BEncoderBoard3(4)/BEncoderBoard3(4).step
34.0 x 33.0 x 2.25 mm
