PaulMaxAvalosAguilar/NN54/Mechatronics/Hardware/Electrical/BEncoderBoard3(4.2)/BEncoderBoard3(4.2).step

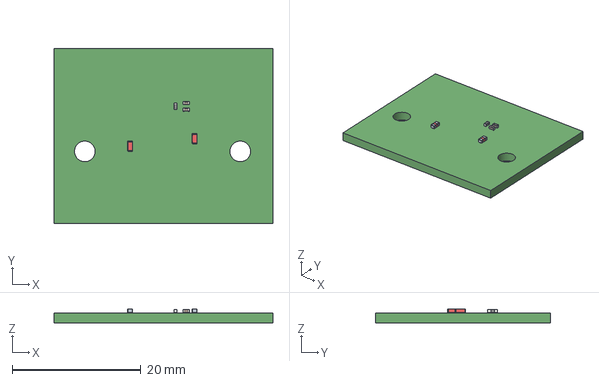
[picture p16: CAD file, 2021-05-05]
Mechatronics/Hardware/Electrical/BEncoderBoard3(4.2)/BEncoderBoard3(4.2).step
34.0 x 27.2 x 2.25 mm
