PaulMaxAvalosAguilar/NN54/Mechatronics/Hardware/Electrical/BMagSensBoard/BMagSensBoard.stl

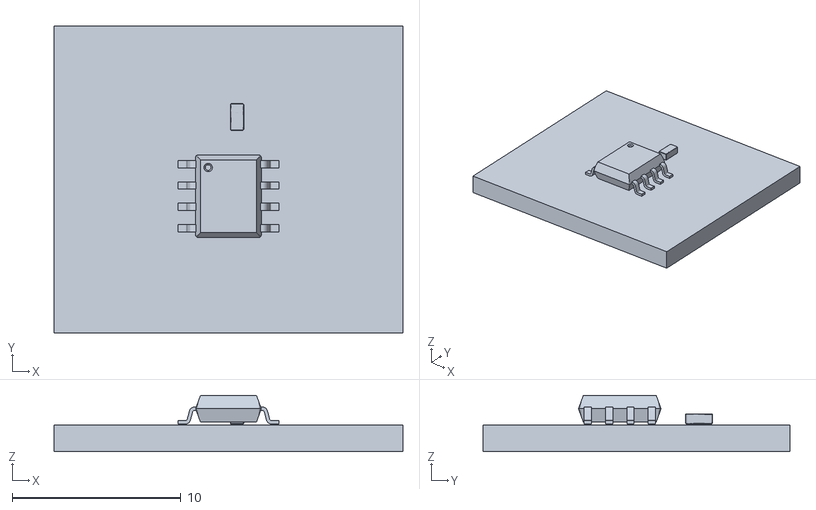
[picture p17: CAD file, 2020-08-12]
Mechatronics/Hardware/Electrical/BMagSensBoard/BMagSensBoard.stl
20.7 x 18.2 x 3.35
