PaulMaxAvalosAguilar/NN54/Mechatronics/Hardware/Electrical/FootPrints/3DModels/BarrelJack/DC Power Jack 5.5mm x 2.1mm.STEP

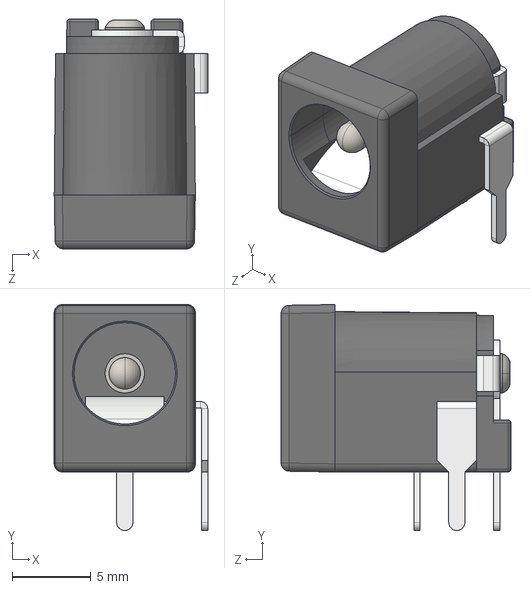
[picture p18: CAD file, 2019-08-10]
Mechatronics/Hardware/Electrical/FootPrints/3DModels/BarrelJack/DC Power Jack 5.5mm x 2.1mm.STEP
9.77 x 14.4 x 14.6 mm
