PaulMaxAvalosAguilar/NN54/Mechatronics/Hardware/Electrical/FootPrints/3DModels/Bluetooth/RN4871.step

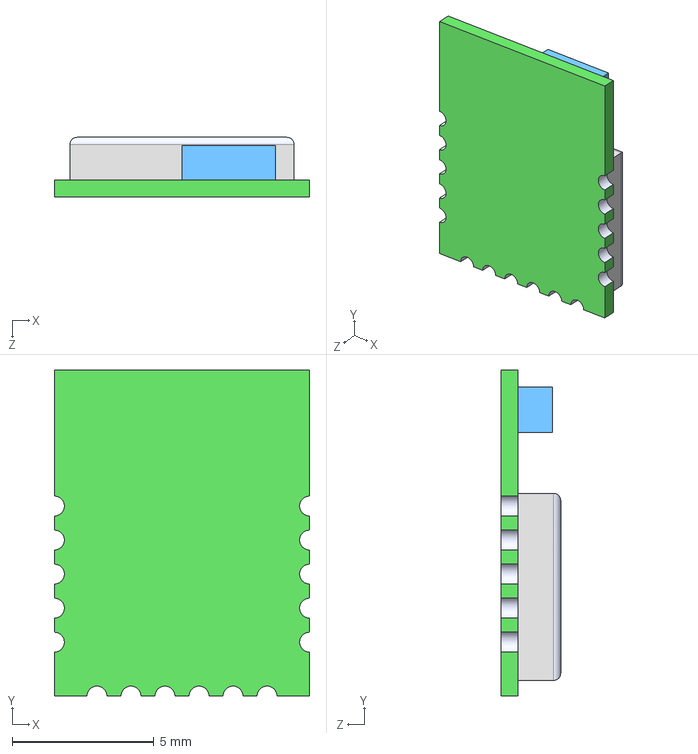
[picture p19: CAD file, 2020-05-24]
Mechatronics/Hardware/Electrical/FootPrints/3DModels/Bluetooth/RN4871.step
9.00 x 11.5 x 2.10 mm
