PaulMaxAvalosAguilar/NN54/Mechatronics/Hardware/Electrical/FootPrints/3DModels/CapacitorsSMD/C_0402_1005Metric.step

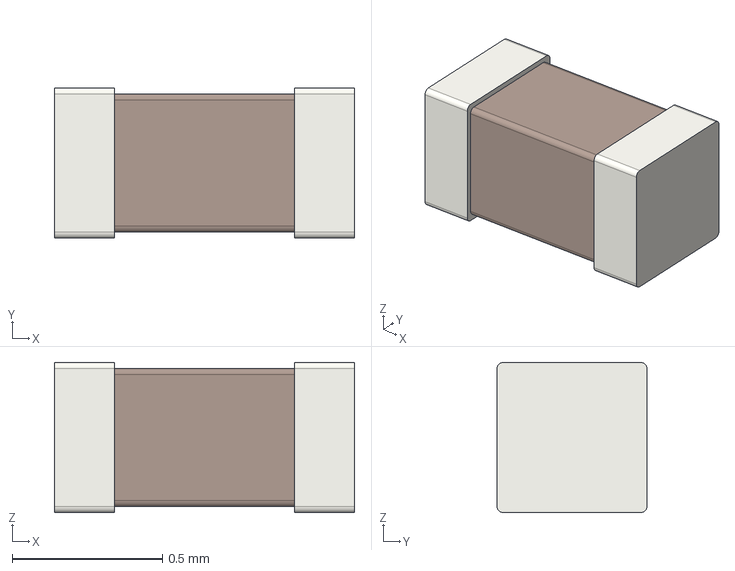
[picture p20: CAD file, 2021-05-05]
Mechatronics/Hardware/Electrical/FootPrints/3DModels/CapacitorsSMD/C_0402_1005Metric.step
1.00 x 0.5 x 0.5 mm
