PaulMaxAvalosAguilar/NN54/Mechatronics/Hardware/Electrical/FootPrints/3DModels/DO201AD/User Library-DO-201AD.STEP

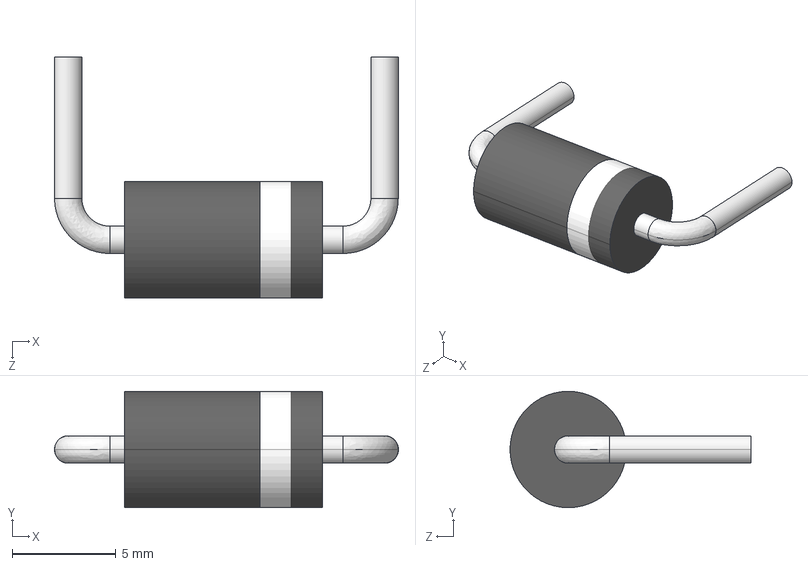
[picture p21: CAD file, 2019-04-19]
Mechatronics/Hardware/Electrical/FootPrints/3DModels/DO201AD/User Library-DO-201AD.STEP
16.6 x 5.60 x 11.6 mm
User Library-DO-201AD_Cylinder
User Library-DO-201AD_Cylinder001
User Library-DO-201AD_Cylinder002
User Library-DO-201AD_Cylinder003
User Library-DO-201AD_Torus
User Library-DO-201AD_Cylinder004
User Library-DO-201AD_Torus001
User Library-DO-201AD_Cylinder005
User Library-DO-201AD_Cylinder006
