PaulMaxAvalosAguilar/NN54/Mechatronics/Hardware/Electrical/FootPrints/3DModels/HC49-S Crystal/User Library-HC49S.STEP

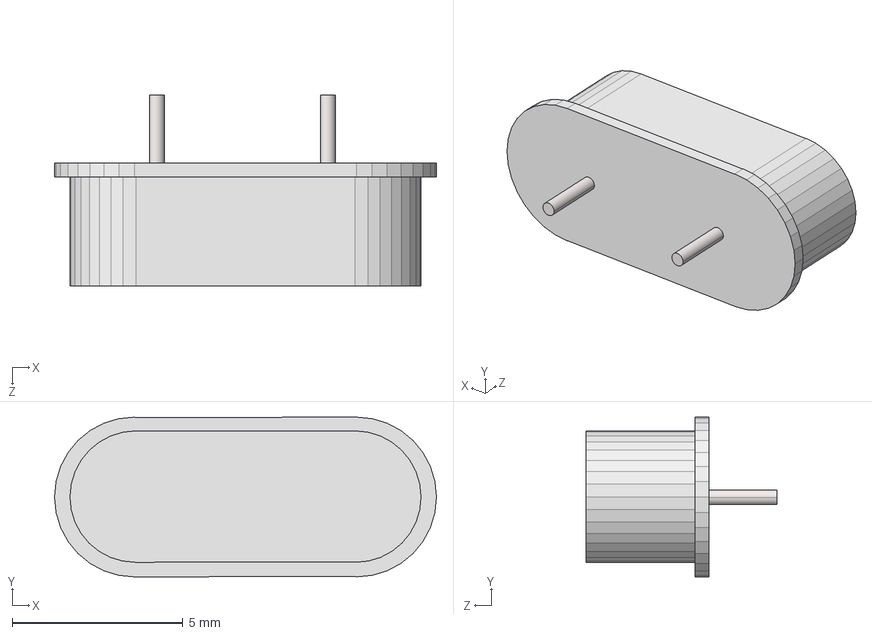
[picture p22: CAD file, 2019-04-19]
Mechatronics/Hardware/Electrical/FootPrints/3DModels/HC49-S Crystal/User Library-HC49S.STEP
11.2 x 4.67 x 5.60 mm
User Library-HC49S_Extruded3
User Library-HC49S_Cylinder1 x 2
User Library-HC49S_Extruded2
