PaulMaxAvalosAguilar/NN54/Mechatronics/Hardware/Electrical/FootPrints/3DModels/JST/JST_EH_B6B-EH-A_1x06_P2.50mm_Vertical.step

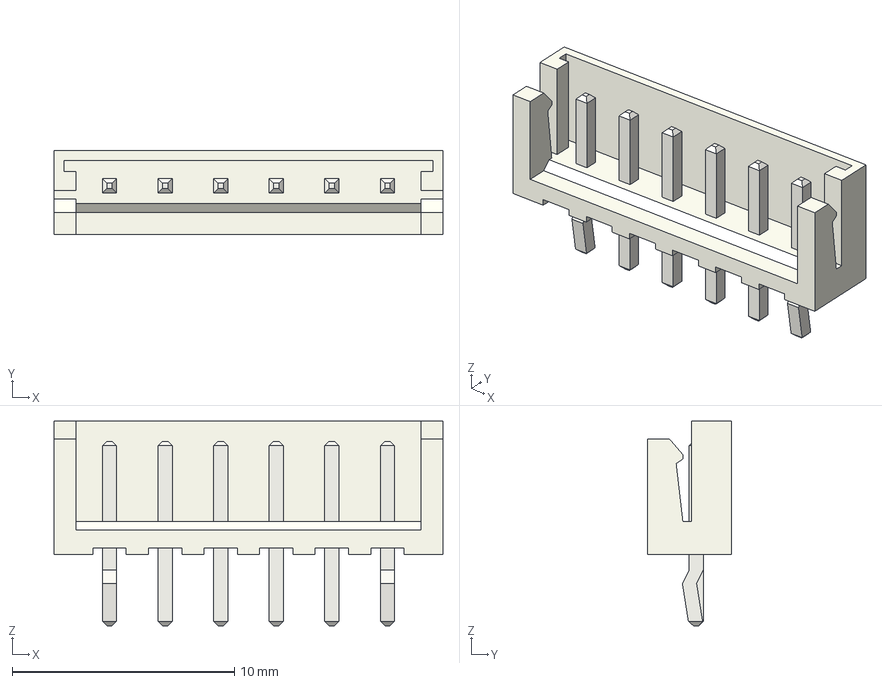
[picture p23: CAD file, 2021-05-05]
Mechatronics/Hardware/Electrical/FootPrints/3DModels/JST/JST_EH_B6B-EH-A_1x06_P2.50mm_Vertical.step
17.5 x 3.80 x 9.20 mm
