PaulMaxAvalosAguilar/NN54/Mechatronics/Hardware/Electrical/FootPrints/3DModels/LGA/LSM6DSRX.step

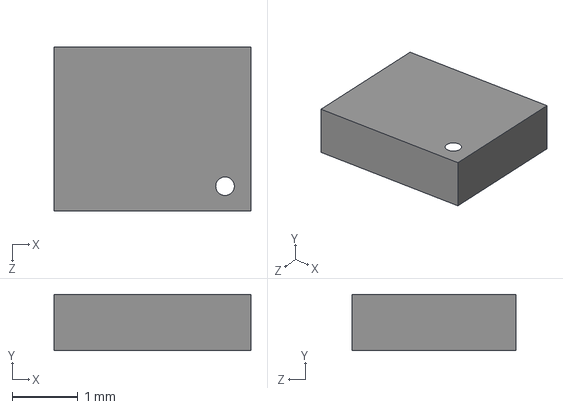
[picture p24: CAD file, 2021-01-27]
Mechatronics/Hardware/Electrical/FootPrints/3DModels/LGA/LSM6DSRX.step
3.00 x 0.86 x 2.50 mm
