PaulMaxAvalosAguilar/NN54/Mechatronics/Hardware/Electrical/FootPrints/3DModels/LiPo Battery/PANASONIC_NCR-18650B.STEP

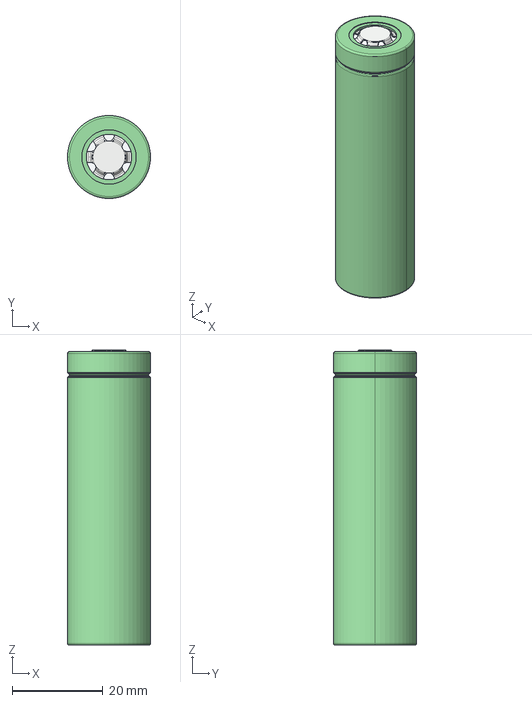
[picture p25: CAD file, 2019-04-19]
Mechatronics/Hardware/Electrical/FootPrints/3DModels/LiPo Battery/PANASONIC_NCR-18650B.STEP
18.3 x 18.3 x 65.0 mm
