PaulMaxAvalosAguilar/NN54/Mechatronics/Hardware/Electrical/FootPrints/3DModels/LiPo BatteryHolder/KEYELCO_1042.STEP

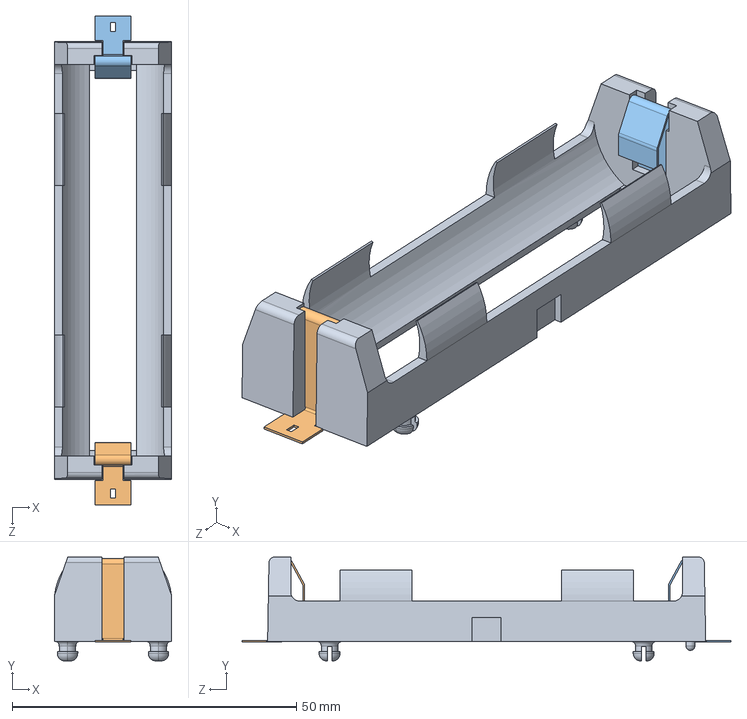
[picture p26: CAD file, 2019-04-19]
Mechatronics/Hardware/Electrical/FootPrints/3DModels/LiPo BatteryHolder/KEYELCO_1042.STEP
20.7 x 18.3 x 86.0 mm
