PaulMaxAvalosAguilar/NN54/Mechatronics/Hardware/Electrical/FootPrints/3DModels/LTC3240/User Library-DFN-6-1.STEP

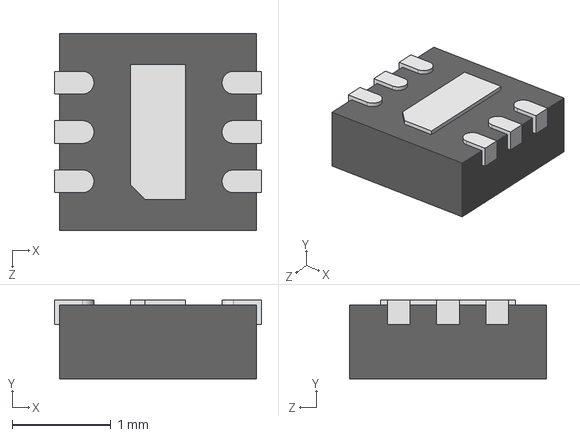
[picture p27: CAD file, 2019-08-10]
Mechatronics/Hardware/Electrical/FootPrints/3DModels/LTC3240/User Library-DFN-6-1.STEP
2.10 x 0.8 x 2.00 mm
