PaulMaxAvalosAguilar/NN54/Mechatronics/Hardware/Electrical/FootPrints/3DModels/OptoInterrupters/opbh21a10.stp

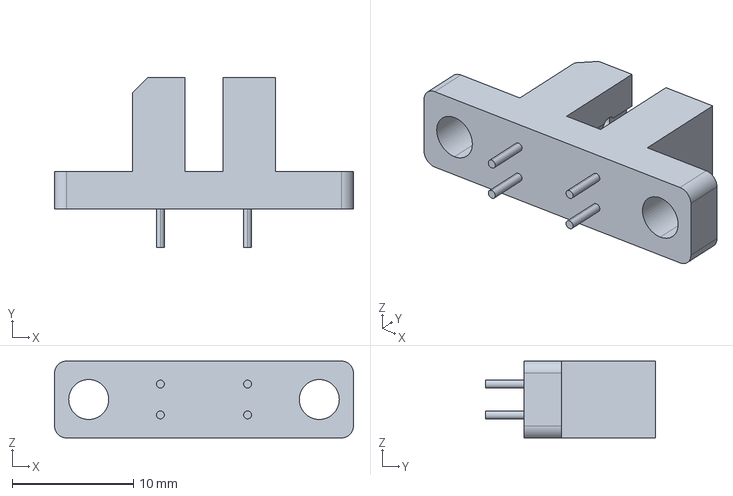
[picture p28: CAD file, 2019-04-19]
Mechatronics/Hardware/Electrical/FootPrints/3DModels/OptoInterrupters/opbh21a10.stp
24.7 x 14.0 x 6.35 mm
