PaulMaxAvalosAguilar/NN54/Mechatronics/Hardware/Electrical/FootPrints/3DModels/PinHeaders/PinHeader_1x03_P2.54mm_Vertical.step

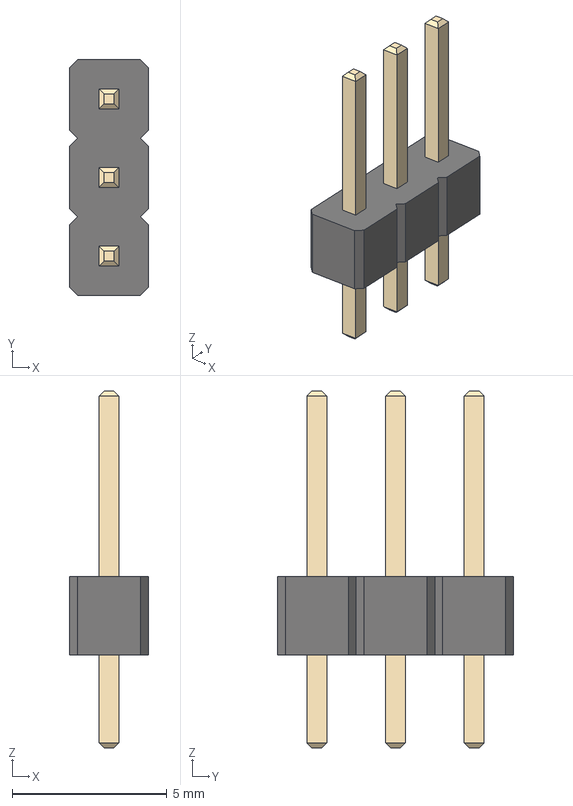
[picture p29: CAD file, 2020-07-22]
Mechatronics/Hardware/Electrical/FootPrints/3DModels/PinHeaders/PinHeader_1x03_P2.54mm_Vertical.step
2.54 x 7.62 x 11.5 mm
