PaulMaxAvalosAguilar/NN54/Mechatronics/Hardware/Electrical/FootPrints/3DModels/ResistanceSMD/User Library-D0603.step

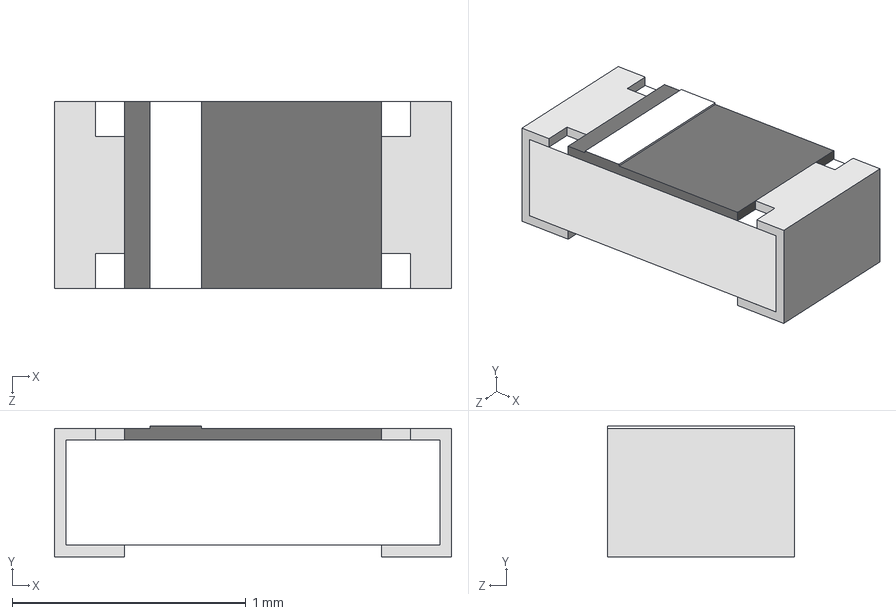
[picture p30: CAD file, 2019-08-10]
Mechatronics/Hardware/Electrical/FootPrints/3DModels/ResistanceSMD/User Library-D0603.step
1.70 x 0.56 x 0.8 mm
