PaulMaxAvalosAguilar/NN54/Mechatronics/Hardware/Electrical/FootPrints/3DModels/SlideSwitch/User Library-EG1218.STEP

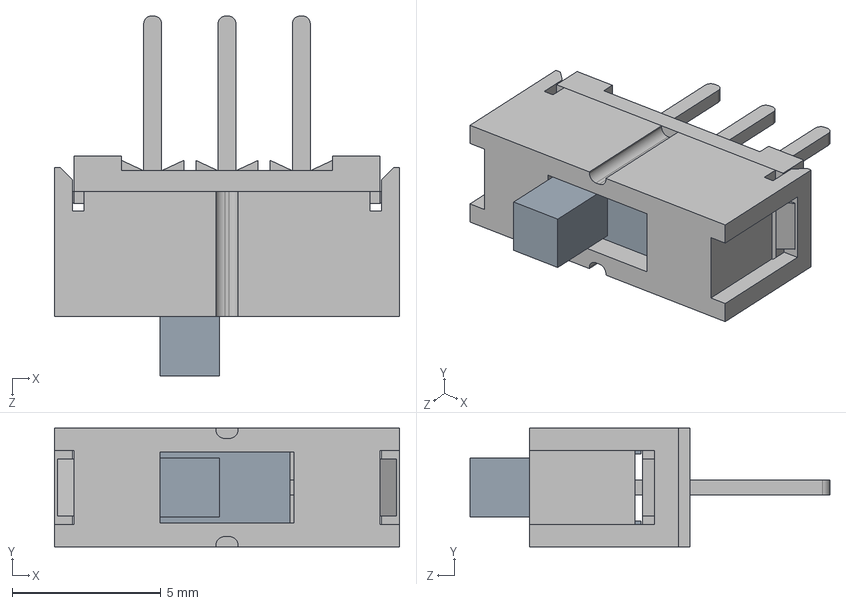
[picture p31: CAD file, 2019-04-19]
Mechatronics/Hardware/Electrical/FootPrints/3DModels/SlideSwitch/User Library-EG1218.STEP
11.6 x 4.00 x 12.1 mm
User Library-EG1218_EG1218 Housing
User Library-EG1218_EG1218 Actuator
User Library-EG1218_EG1218A Terminals
