PaulMaxAvalosAguilar/NN54/Mechatronics/Hardware/Electrical/FootPrints/3DModels/SMA/Diode SMA.stp

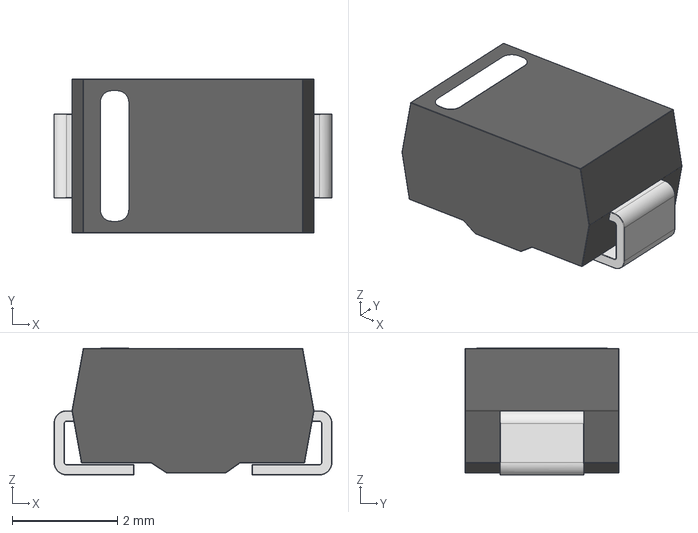
[picture p32: CAD file, 2019-08-10]
Mechatronics/Hardware/Electrical/FootPrints/3DModels/SMA/Diode SMA.stp
5.28 x 2.92 x 2.41 mm
