PaulMaxAvalosAguilar/NN54/Mechatronics/Hardware/Electrical/FootPrints/3DModels/So8/User Library-so8-3.step

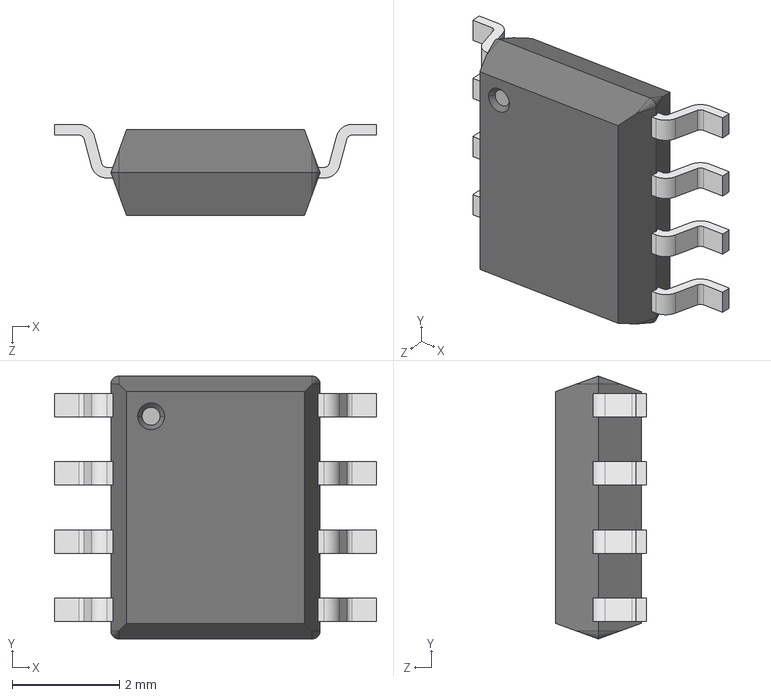
[picture p33: CAD file, 2020-07-14]
Mechatronics/Hardware/Electrical/FootPrints/3DModels/So8/User Library-so8-3.step
6.00 x 4.90 x 1.70 mm
