PaulMaxAvalosAguilar/NN54/Mechatronics/Hardware/Electrical/FootPrints/3DModels/SOD323/SOD-323.STEP

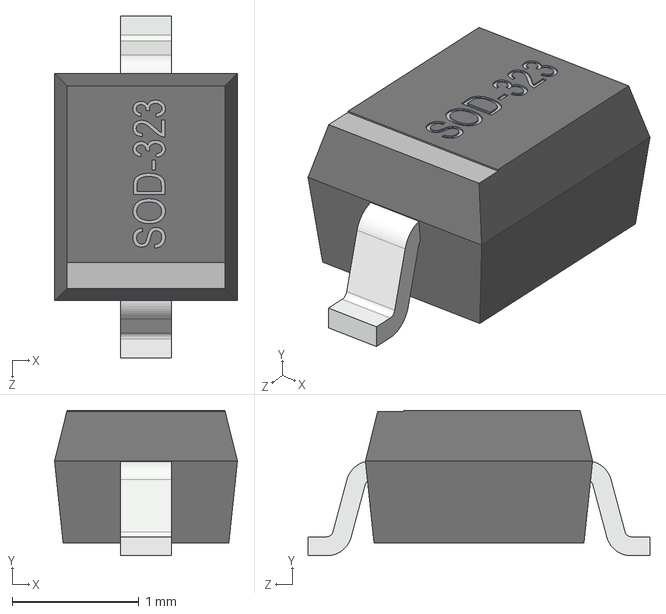
[picture p34: CAD file, 2019-08-23]
Mechatronics/Hardware/Electrical/FootPrints/3DModels/SOD323/SOD-323.STEP
1.45 x 1.15 x 2.70 mm
