PaulMaxAvalosAguilar/NN54/Mechatronics/Hardware/Electrical/FootPrints/3DModels/Sop8/SOP-8.STEP

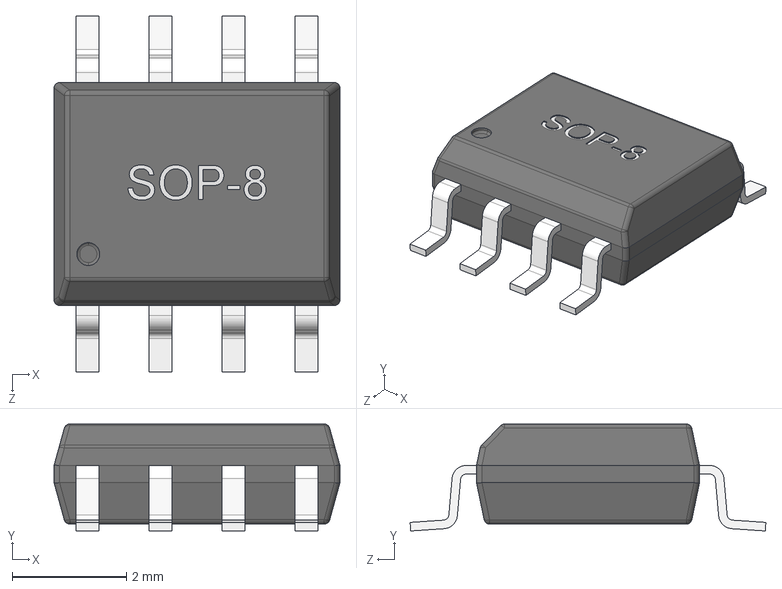
[picture p35: CAD file, 2019-08-10]
Mechatronics/Hardware/Electrical/FootPrints/3DModels/Sop8/SOP-8.STEP
5.00 x 1.87 x 6.22 mm
