PaulMaxAvalosAguilar/NN54/Mechatronics/Hardware/Electrical/FootPrints/3DModels/Sot23(6)/SOT23-6.stp

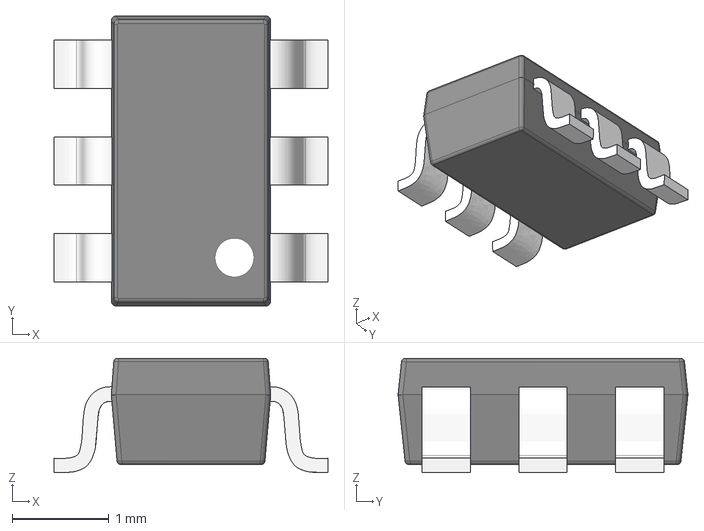
[picture p37: CAD file, 2019-08-10]
Mechatronics/Hardware/Electrical/FootPrints/3DModels/Sot23(6)/SOT23-6.stp
2.84 x 3.00 x 1.18 mm
