PaulMaxAvalosAguilar/NN54/Mechatronics/Hardware/Electrical/FootPrints/3DModels/SSD1306Screen/128x64Oled.step

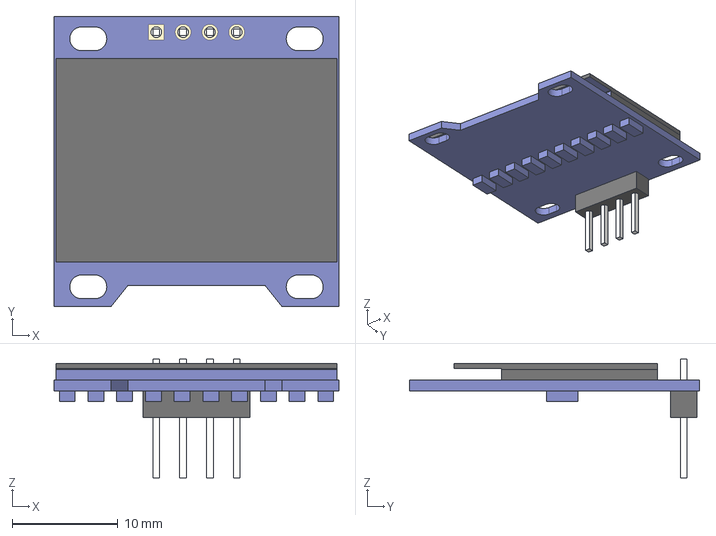
[picture p38: CAD file, 2019-04-19]
Mechatronics/Hardware/Electrical/FootPrints/3DModels/SSD1306Screen/128x64Oled.step
27.0 x 27.5 x 11.2 mm
Screen
