PaulMaxAvalosAguilar/NN54/Mechatronics/Hardware/Electrical/FootPrints/3DModels/STM32/LQFP-48_7x7mm_P0.5mm.step

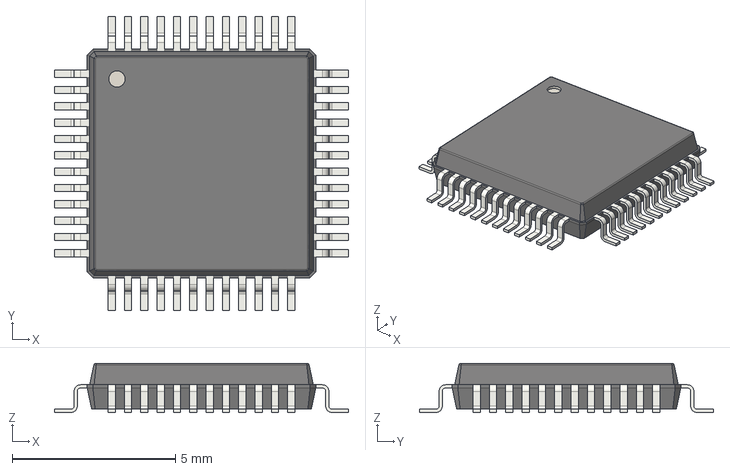
[picture p39: CAD file, 2020-07-02]
Mechatronics/Hardware/Electrical/FootPrints/3DModels/STM32/LQFP-48_7x7mm_P0.5mm.step
9.00 x 9.00 x 1.50 mm
