PaulMaxAvalosAguilar/NN54/Mechatronics/Hardware/Electrical/FootPrints/3DModels/USB/TYPE-C-31-M-12.step

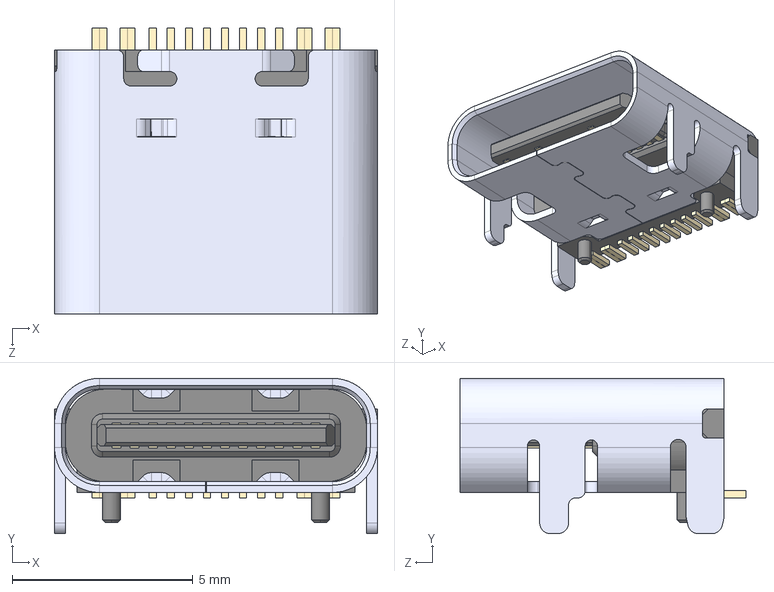
[picture p40: CAD file, 2021-01-27]
Mechatronics/Hardware/Electrical/FootPrints/3DModels/USB/TYPE-C-31-M-12.step
8.94 x 4.30 x 7.90 mm
