PaulMaxAvalosAguilar/NN54/Mechatronics/Hardware/Mechanical/FreeCadFiles/EncoderNew.FCStd

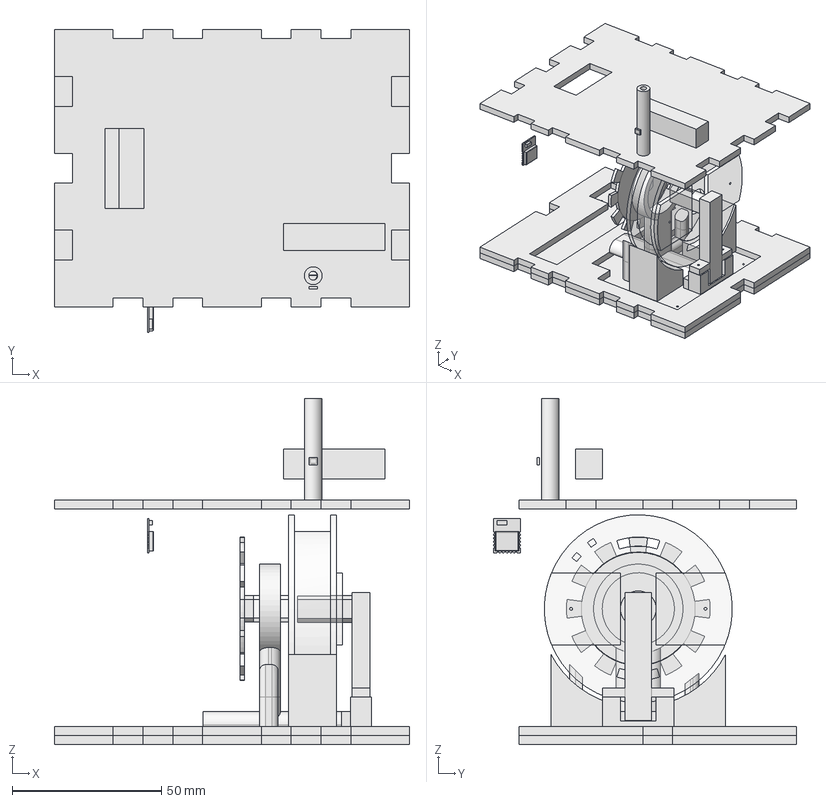
[picture p41: CAD file, 2021-01-27]
Mechatronics/Hardware/Mechanical/FreeCadFiles/EncoderNew.FCStd
119.0 x 101.5 x 116.0 mm
Dientesextr
BaseCentral
SoporteAncla
SoporteBaleroB
FlechaCajaResorte
Tapa
Centro
Shaped Base
BareBase
Header
LSM6DS3TR
User Library-Module_Microchip_RN4871
