PaulMaxAvalosAguilar/NN54/Mechatronics/Hardware/Mechanical/FreeCadFiles/EncoderNewSTLS/2D Sensor XBearing.stl

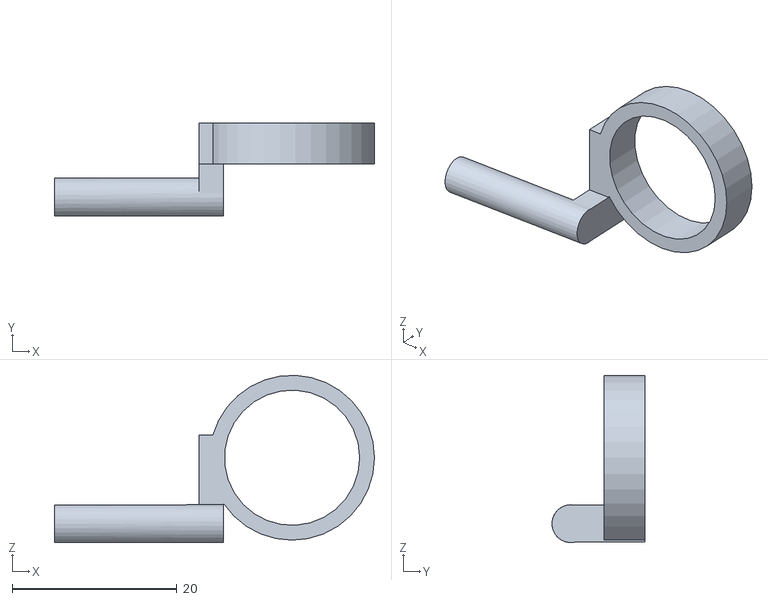
[picture p42: CAD file, 2020-04-15]
Mechatronics/Hardware/Mechanical/FreeCadFiles/EncoderNewSTLS/2D Sensor XBearing.stl
38.8 x 11.3 x 20.3
