PaulMaxAvalosAguilar/NN54/Mechatronics/Hardware/Mechanical/FreeCadFiles/EncoderStls/Tapamovilextr.stl

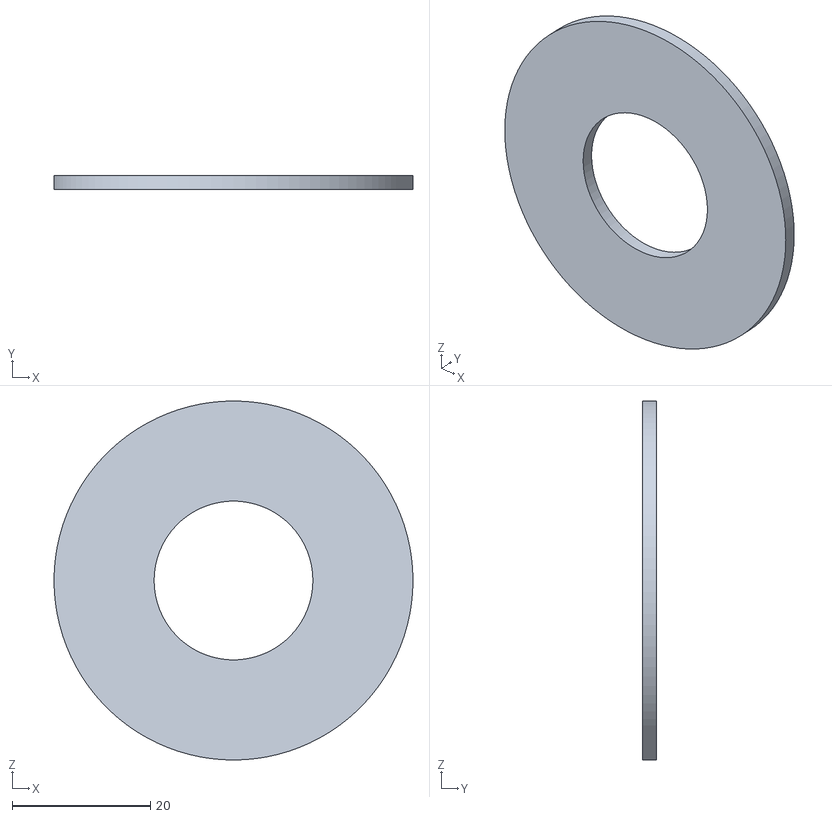
[picture p43: CAD file, 2019-05-31]
Mechatronics/Hardware/Mechanical/FreeCadFiles/EncoderStls/Tapamovilextr.stl
52.0 x 2.00 x 52.0
