PaulMaxAvalosAguilar/NN54/Mechatronics/Hardware/Mechanical/FreeCadFiles/Imported Stls/Hex Spacer FF M3 L20mm.stp

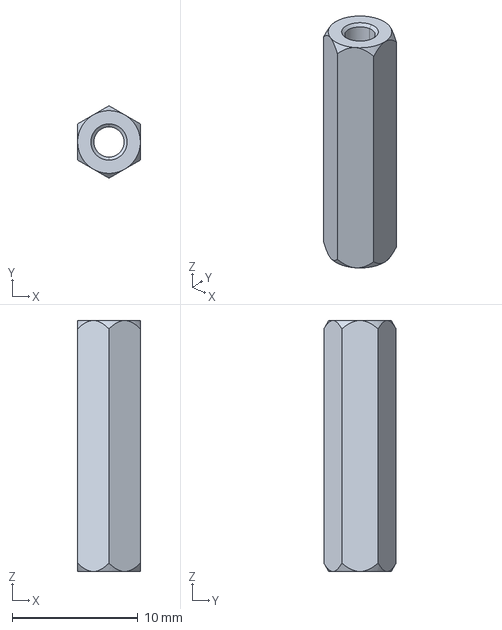
[picture p44: CAD file, 2022-01-18]
Mechatronics/Hardware/Mechanical/FreeCadFiles/Imported Stls/Hex Spacer FF M3 L20mm.stp
5.00 x 5.77 x 20.0 mm
