PaulMaxAvalosAguilar/NN54/Mechatronics/Hardware/Electrical/FootPrints/3DModels/Bluetooth/RN4020.step

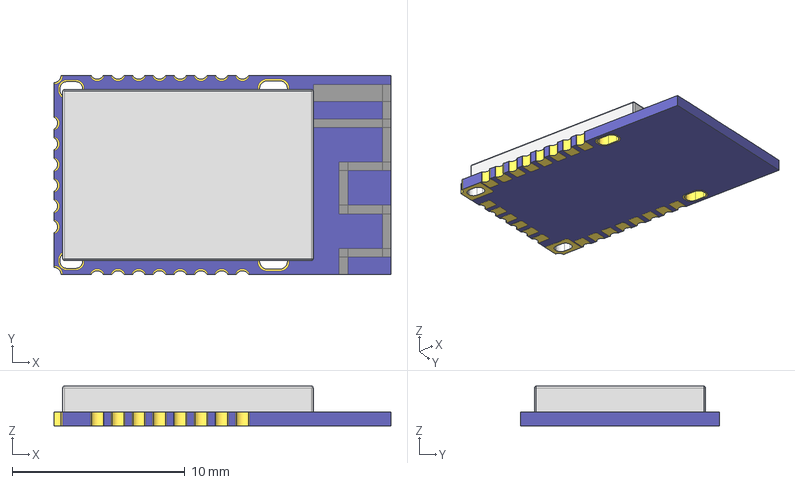
[picture p45: CAD file, 2019-04-19]
Mechatronics/Hardware/Electrical/FootPrints/3DModels/Bluetooth/RN4020.step
19.5 x 11.5 x 2.31 mm
