PaulMaxAvalosAguilar/NN54/Mechatronics/Hardware/Electrical/FootPrints/3DModels/CapacitorsSMD/Ceramic CAP0603.stp

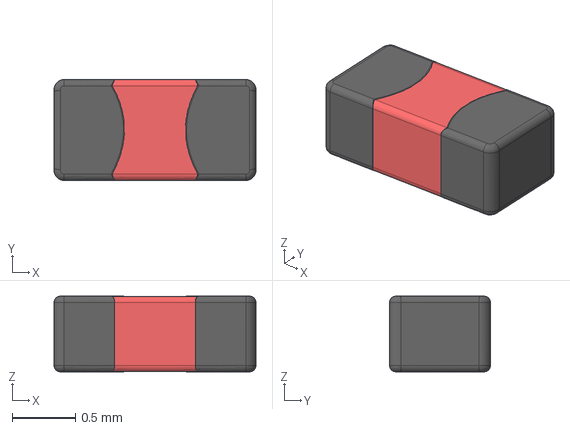
[picture p46: CAD file, 2019-08-10]
Mechatronics/Hardware/Electrical/FootPrints/3DModels/CapacitorsSMD/Ceramic CAP0603.stp
1.60 x 0.8 x 0.6 mm
