PaulMaxAvalosAguilar/NN54/Mechatronics/Hardware/Electrical/FootPrints/3DModels/JST/JST_EH_B4B-EH-A_1x04_P2.50mm_Vertical.step

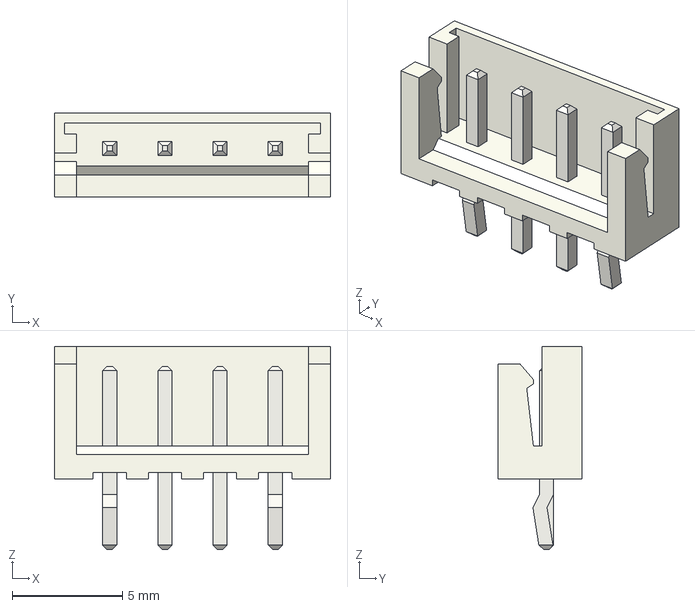
[picture p47: CAD file, 2021-05-05]
Mechatronics/Hardware/Electrical/FootPrints/3DModels/JST/JST_EH_B4B-EH-A_1x04_P2.50mm_Vertical.step
12.5 x 3.80 x 9.20 mm
