PaulMaxAvalosAguilar/NN54/Mechatronics/Hardware/Electrical/FootPrints/3DModels/PinHeaders/PinHeader_1x07_P2.54mm_Vertical.step

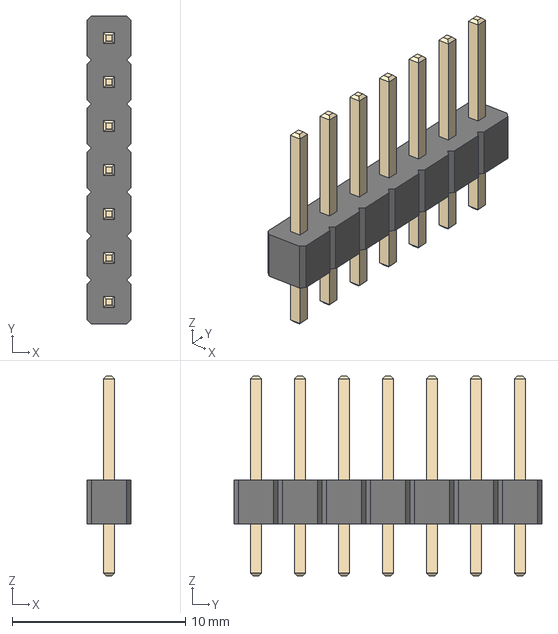
[picture p48: CAD file, 2020-07-11]
Mechatronics/Hardware/Electrical/FootPrints/3DModels/PinHeaders/PinHeader_1x07_P2.54mm_Vertical.step
2.54 x 17.8 x 11.5 mm
