PaulMaxAvalosAguilar/NN54/Mechatronics/Hardware/Mechanical/FreeCadFiles/EncoderNewSTLS/Theter.stl

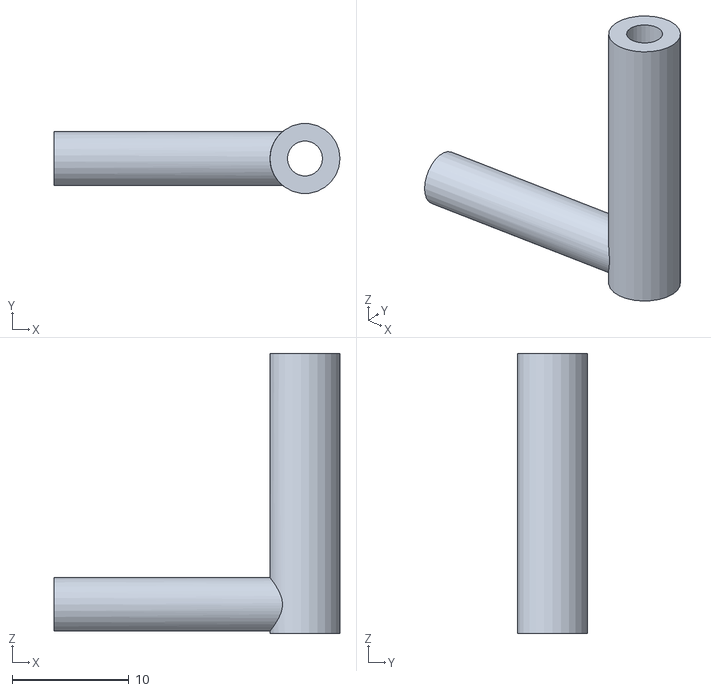
[picture p49: CAD file, 2020-04-07]
Mechatronics/Hardware/Mechanical/FreeCadFiles/EncoderNewSTLS/Theter.stl
24.5 x 5.96 x 24.0
