PaulMaxAvalosAguilar/NN54/Mechatronics/Hardware/Mechanical/FreeCadFiles/EncoderStls/BaseSopbalHuecosoptracc.stl

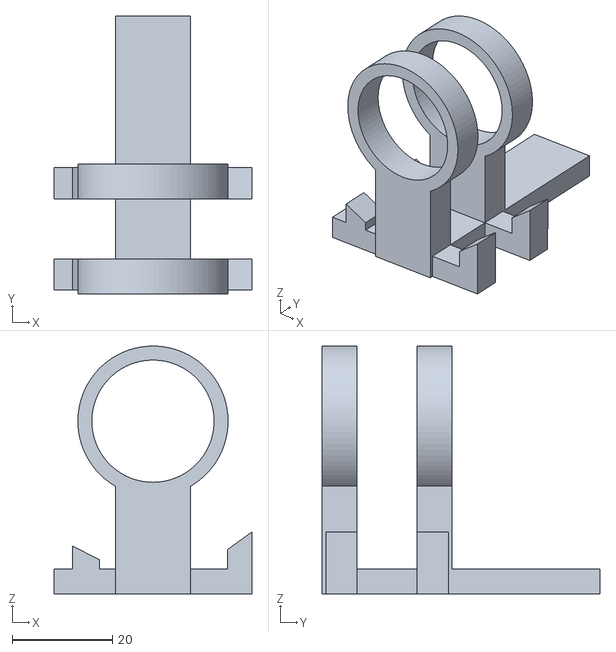
[picture p50: CAD file, 2019-05-31]
Mechatronics/Hardware/Mechanical/FreeCadFiles/EncoderStls/BaseSopbalHuecosoptracc.stl
39.5 x 55.5 x 49.5
