PaulMaxAvalosAguilar/NN54/Mechatronics/Hardware/Mechanical/FreeCadFiles/Imported Stls/SKF 625.STEP

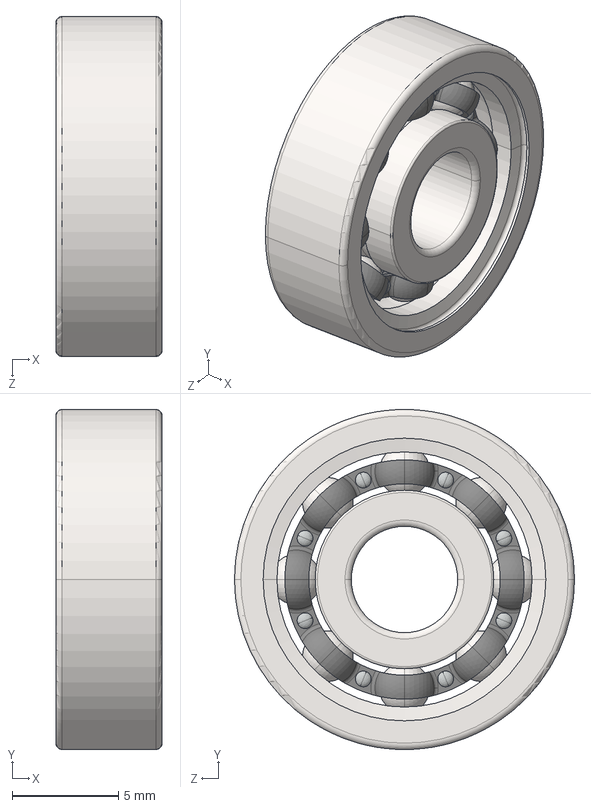
[picture p51: CAD file, 2020-04-15]
Mechatronics/Hardware/Mechanical/FreeCadFiles/Imported Stls/SKF 625.STEP
5.00 x 16.0 x 16.0 mm
SKF 625 Inner Race^SKF 625
SKF 625 Outer Race^SKF 625
SKF 625 Ball^SKF 625 x 8
SKF 625 Cage^SKF 625
