PaulMaxAvalosAguilar/NN54/Mechatronics/Hardware/Electrical/BEncoderBoard3(2)/BEncoderBoard3(2).step

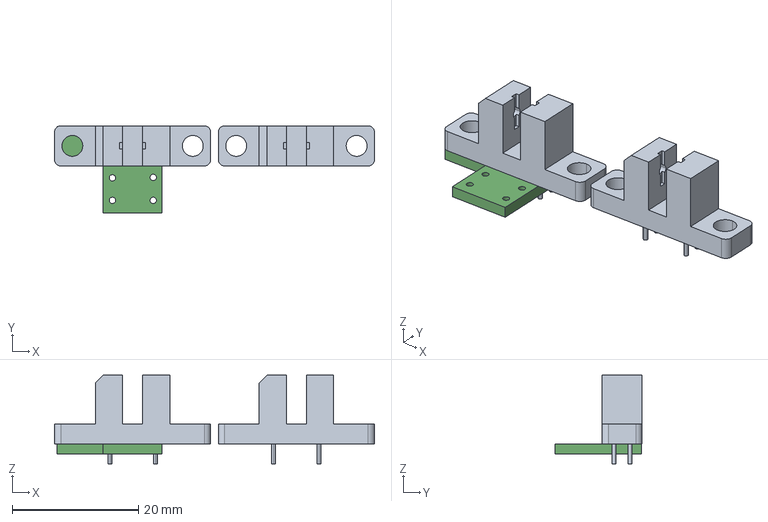
[picture p52: CAD file, 2019-04-19]
Mechatronics/Hardware/Electrical/BEncoderBoard3(2)/BEncoderBoard3(2).step
50.6 x 13.8 x 14.0 mm
