PaulMaxAvalosAguilar/NN54/Mechatronics/Hardware/Electrical/FootPrints/3DModels/JST/JST_EH_B2B-EH-A_1x02_P2.50mm_Vertical.step

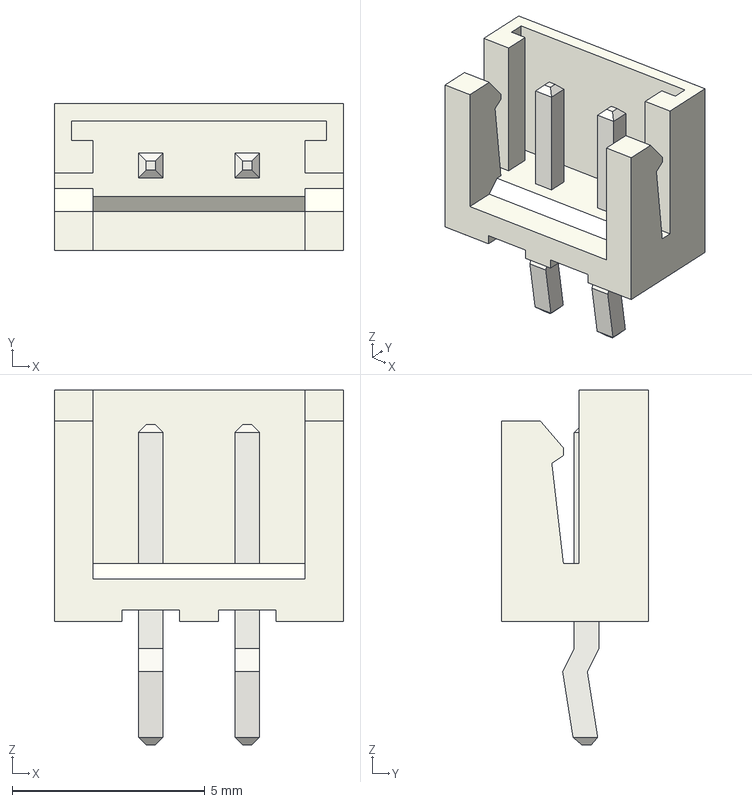
[picture p53: CAD file, 2021-05-05]
Mechatronics/Hardware/Electrical/FootPrints/3DModels/JST/JST_EH_B2B-EH-A_1x02_P2.50mm_Vertical.step
7.50 x 3.80 x 9.20 mm
