PaulMaxAvalosAguilar/NN54/Mechatronics/Hardware/Mechanical/FreeCadFiles/EncoderNewSTLS/2D Sensor YBearing.stl

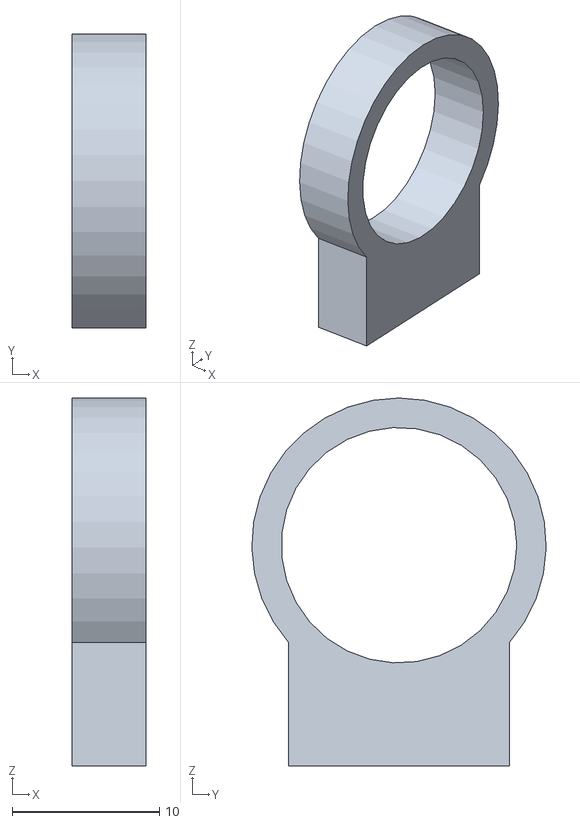
[picture p55: CAD file, 2020-04-07]
Mechatronics/Hardware/Mechanical/FreeCadFiles/EncoderNewSTLS/2D Sensor YBearing.stl
5.00 x 20.0 x 25.0
