PaulMaxAvalosAguilar/NN54/Mechatronics/Hardware/Mechanical/FreeCadFiles/EncoderStls/PiezaFlechaCuerpoResorteHueco.stl

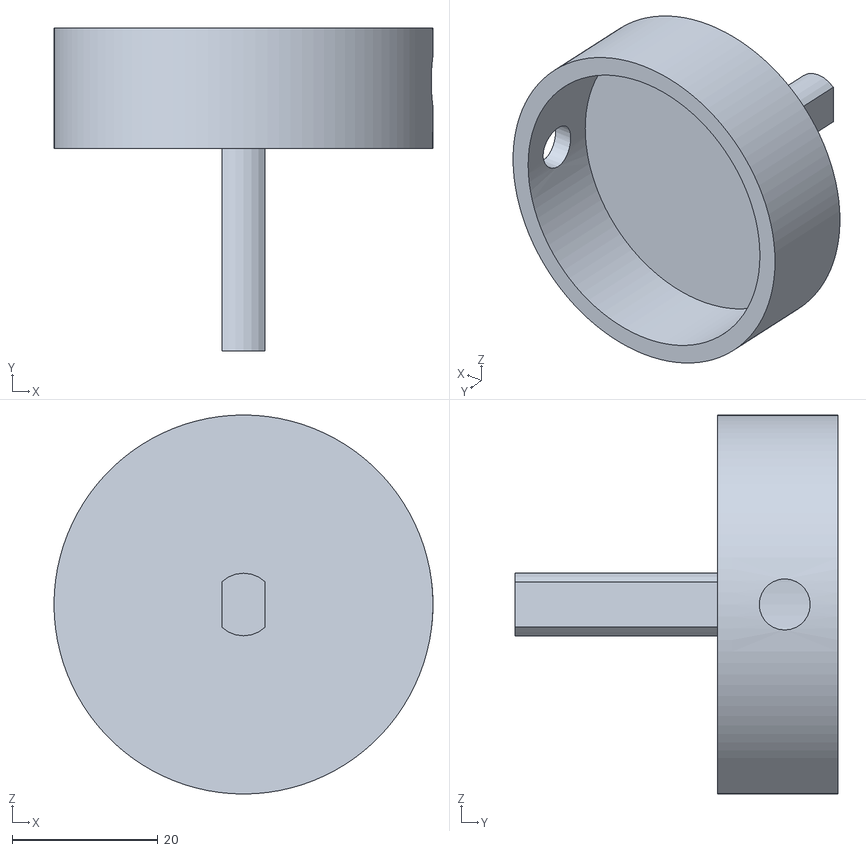
[picture p56: CAD file, 2019-05-31]
Mechatronics/Hardware/Mechanical/FreeCadFiles/EncoderStls/PiezaFlechaCuerpoResorteHueco.stl
52.0 x 44.3 x 52.0
