PaulMaxAvalosAguilar/NN54/Mechatronics/Hardware/Electrical/FootPrints/3DModels/JST/JST_EH_B8B-EH-A_1x08_P2.50mm_Vertical.step

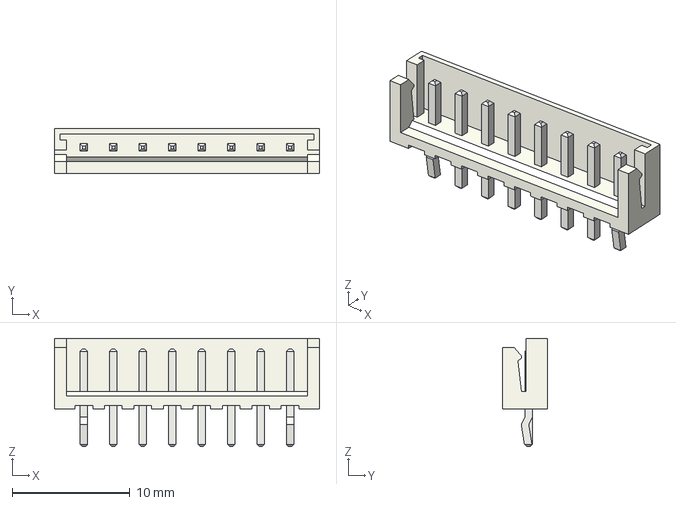
[picture p57: CAD file, 2021-05-05]
Mechatronics/Hardware/Electrical/FootPrints/3DModels/JST/JST_EH_B8B-EH-A_1x08_P2.50mm_Vertical.step
22.5 x 3.80 x 9.20 mm
