PaulMaxAvalosAguilar/NN54/Mechatronics/Hardware/Electrical/FootPrints/3DModels/PinHeaders/PinHeader_1x06_P2.54mm_Vertical.step

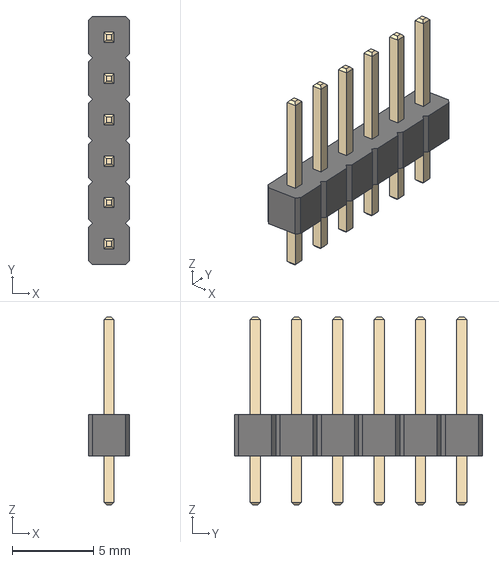
[picture p58: CAD file, 2020-07-02]
Mechatronics/Hardware/Electrical/FootPrints/3DModels/PinHeaders/PinHeader_1x06_P2.54mm_Vertical.step
2.54 x 15.2 x 11.5 mm
