PaulMaxAvalosAguilar/NN54/Mechatronics/Hardware/Mechanical/FreeCadFiles/EncoderNewSTLS/2D Sensor Theter.stl

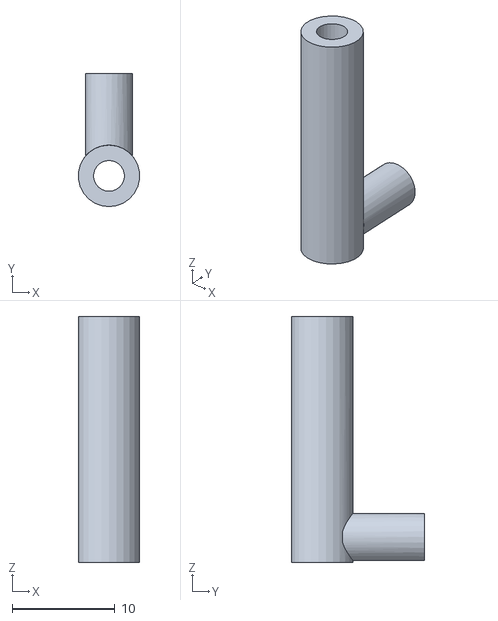
[picture p59: CAD file, 2020-04-07]
Mechatronics/Hardware/Mechanical/FreeCadFiles/EncoderNewSTLS/2D Sensor Theter.stl
5.96 x 13.0 x 24.0
