PaulMaxAvalosAguilar/NN54/Mechatronics/Hardware/Mechanical/FreeCadFiles/EncoderStls/SoporteTraccionHuecoAncla .stl

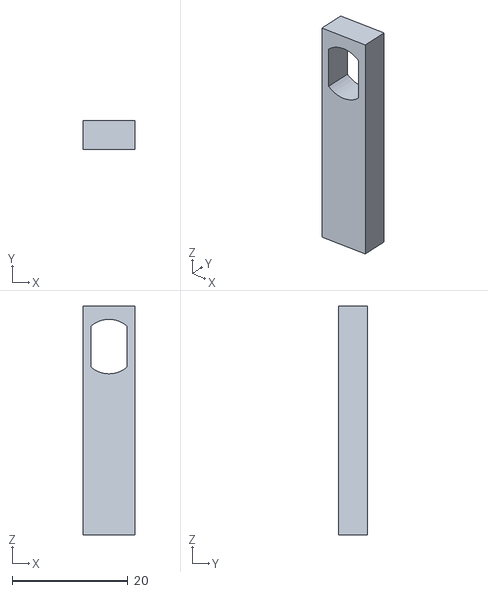
[picture p60: CAD file, 2019-05-31]
Mechatronics/Hardware/Mechanical/FreeCadFiles/EncoderStls/SoporteTraccionHuecoAncla .stl
9.00 x 5.00 x 39.5
