PaulMaxAvalosAguilar/NN54/Mechatronics/Hardware/Mechanical/FreeCadFiles/Imported Stls/609-ZZ-TheTimkenCompany-05-24-2018.stp

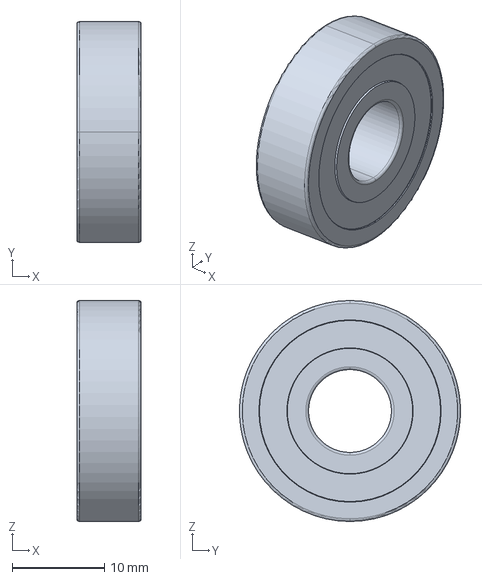
[picture p61: CAD file, 2019-04-19]
Mechatronics/Hardware/Mechanical/FreeCadFiles/Imported Stls/609-ZZ-TheTimkenCompany-05-24-2018.stp
7.00 x 24.0 x 24.0 mm
