PaulMaxAvalosAguilar/NN54/Mechatronics/Hardware/Electrical/FootPrints/3DModels/PinHeaders/PinHeader_1x02_P2.54mm_Vertical.step

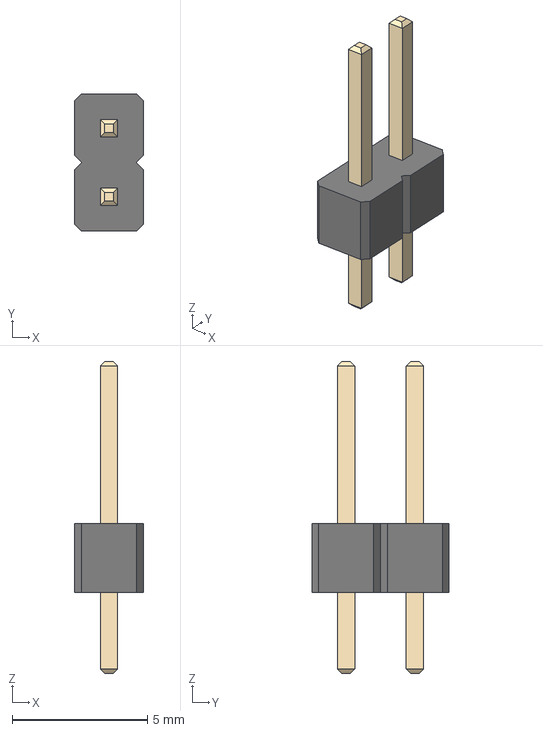
[picture p62: CAD file, 2020-07-02]
Mechatronics/Hardware/Electrical/FootPrints/3DModels/PinHeaders/PinHeader_1x02_P2.54mm_Vertical.step
2.54 x 5.08 x 11.5 mm
