PaulMaxAvalosAguilar/NN54/Mechatronics/Hardware/Mechanical/FreeCadFiles/EncoderStls/DiscoComplSujFleExtr.stl

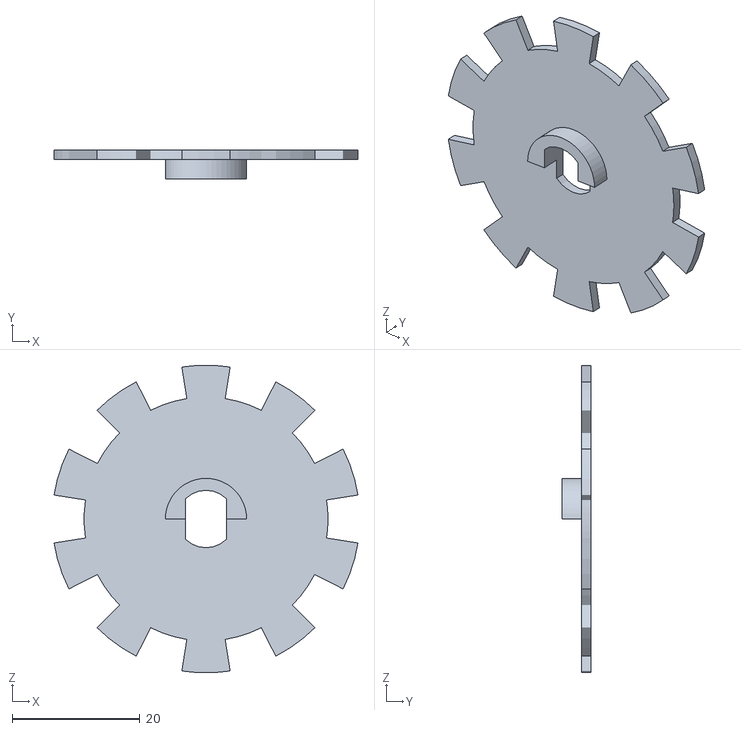
[picture p63: CAD file, 2019-05-31]
Mechatronics/Hardware/Mechanical/FreeCadFiles/EncoderStls/DiscoComplSujFleExtr.stl
47.6 x 4.50 x 48.1
