PaulMaxAvalosAguilar/NN54/Mechatronics/Hardware/Electrical/FootPrints/3DModels/PinHeaders/PinHeader_1x08_P2.54mm_Vertical.step

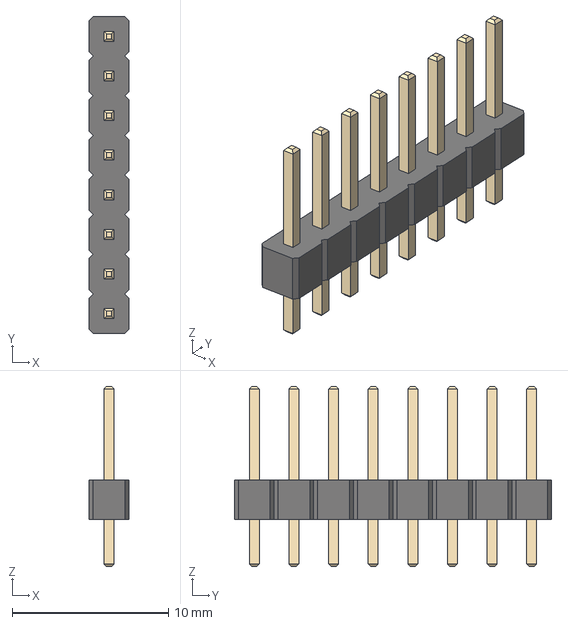
[picture p64: CAD file, 2020-07-02]
Mechatronics/Hardware/Electrical/FootPrints/3DModels/PinHeaders/PinHeader_1x08_P2.54mm_Vertical.step
2.54 x 20.3 x 11.5 mm
