PaulMaxAvalosAguilar/NN54/Mechatronics/Hardware/Mechanical/FreeCadFiles/EncoderNewSTLS/BolaSujección.stl

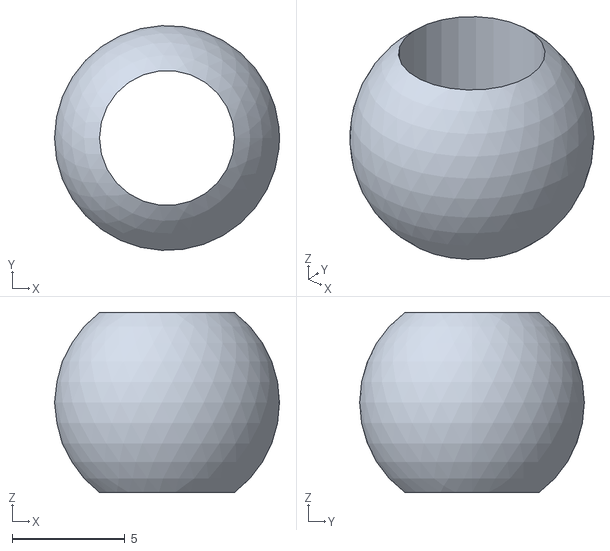
[picture p65: CAD file, 2020-03-02]
Mechatronics/Hardware/Mechanical/FreeCadFiles/EncoderNewSTLS/BolaSujección.stl
10.0 x 9.99 x 8.00
