PaulMaxAvalosAguilar/NN54/Mechatronics/Hardware/Mechanical/FreeCadFiles/EncoderStls/AnclaParteABTopeextr.stl

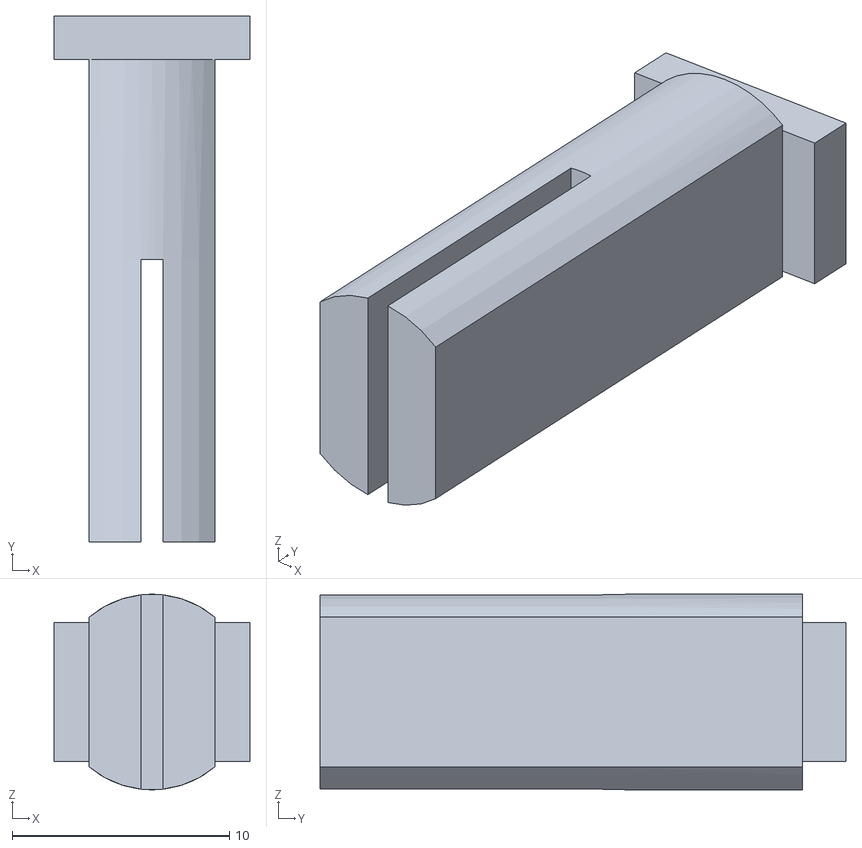
[picture p66: CAD file, 2019-05-31]
Mechatronics/Hardware/Mechanical/FreeCadFiles/EncoderStls/AnclaParteABTopeextr.stl
9.00 x 24.2 x 9.00
