PaulMaxAvalosAguilar/NN54/Mechatronics/Hardware/Electrical/FootPrints/3DModels/PinHeaders/Pin Header 1x4 TH Pitch 2.54mm.stp

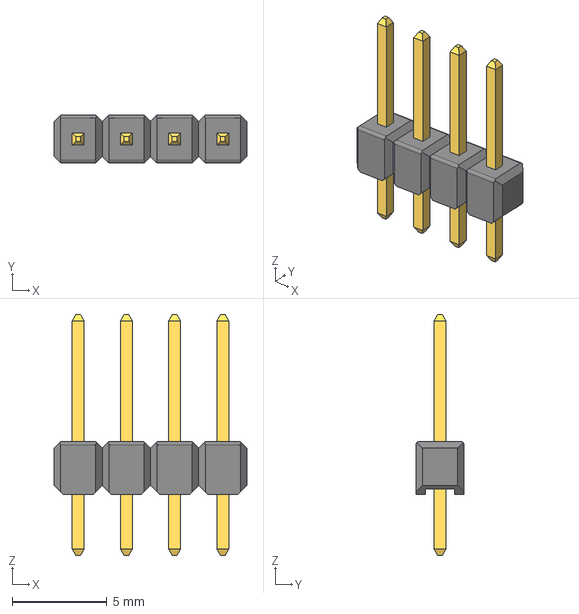
[picture p67: CAD file, 2019-08-10]
Mechatronics/Hardware/Electrical/FootPrints/3DModels/PinHeaders/Pin Header 1x4 TH Pitch 2.54mm.stp
10.2 x 2.54 x 12.7 mm
