PaulMaxAvalosAguilar/NN54/Mechatronics/Hardware/Mechanical/FreeCadFiles/EncoderNewSTLS/Base.stl

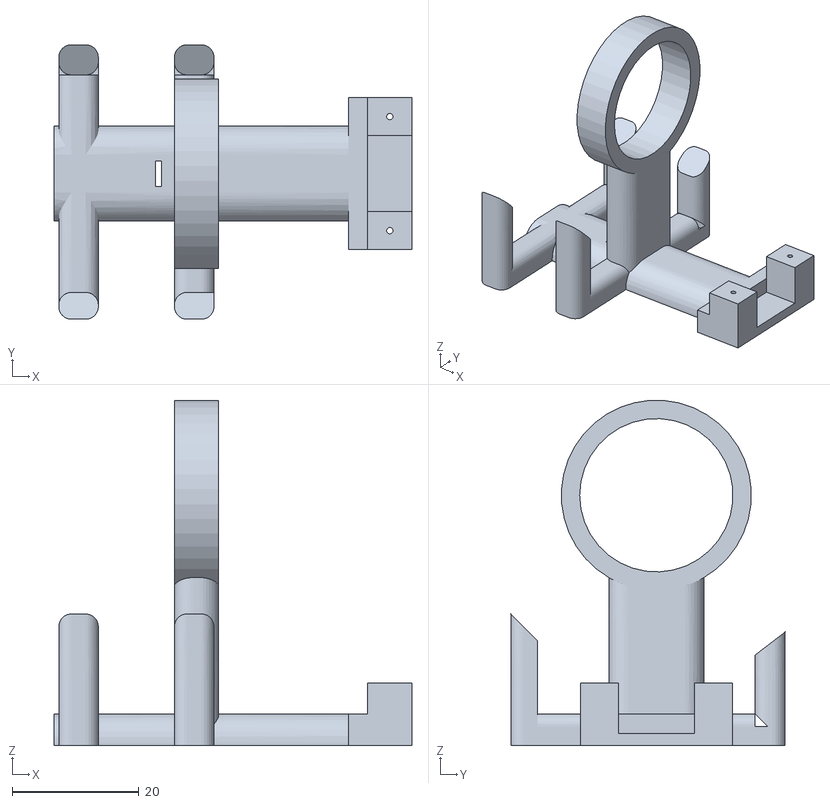
[picture p68: CAD file, 2020-03-02]
Mechatronics/Hardware/Mechanical/FreeCadFiles/EncoderNewSTLS/Base.stl
56.5 x 43.3 x 54.5
