PaulMaxAvalosAguilar/NN54/Mechatronics/Hardware/Mechanical/FreeCadFiles/EncoderNewSTLS/DiscoDentado.stl

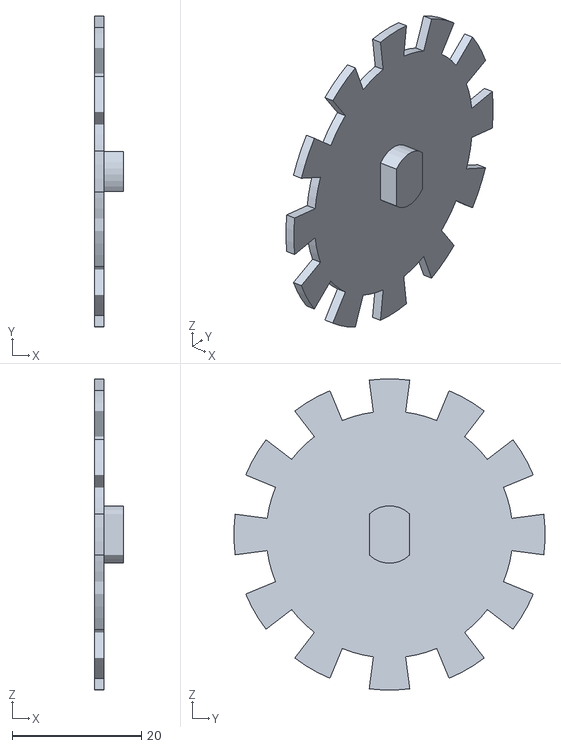
[picture p69: CAD file, 2020-03-02]
Mechatronics/Hardware/Mechanical/FreeCadFiles/EncoderNewSTLS/DiscoDentado.stl
4.50 x 48.1 x 48.1
