PaulMaxAvalosAguilar/NN54/Mechatronics/Hardware/Mechanical/FreeCadFiles/EncoderNewSTLS/FlechaCajaResorte.stl

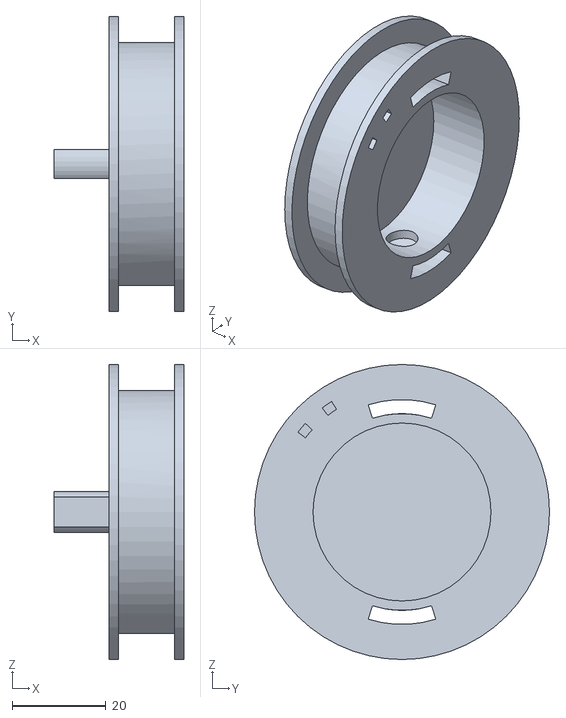
[picture p70: CAD file, 2020-01-13]
Mechatronics/Hardware/Mechanical/FreeCadFiles/EncoderNewSTLS/FlechaCajaResorte.stl
27.8 x 63.0 x 63.0
