PaulMaxAvalosAguilar/NN54/Mechatronics/Hardware/Mechanical/FreeCadFiles/EncoderNewSTLS/SistemaSeguridad.stl

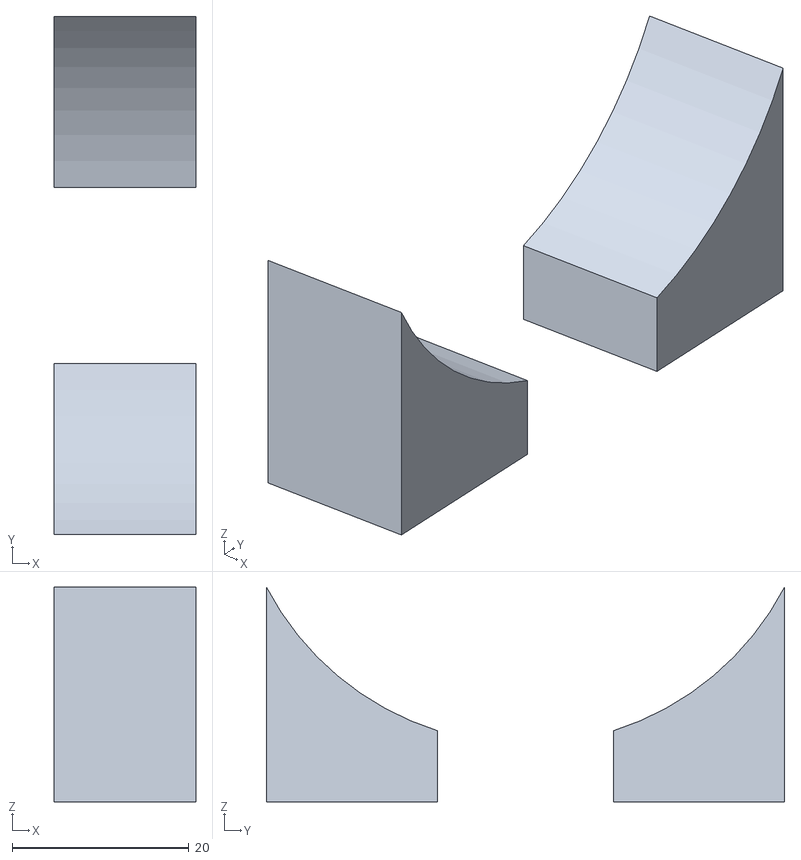
[picture p71: CAD file, 2020-01-13]
Mechatronics/Hardware/Mechanical/FreeCadFiles/EncoderNewSTLS/SistemaSeguridad.stl
16.0 x 58.5 x 24.3
