PaulMaxAvalosAguilar/NN54/Mechatronics/Hardware/Mechanical/FreeCadFiles/EncoderNewSTLS/Ancla.stl

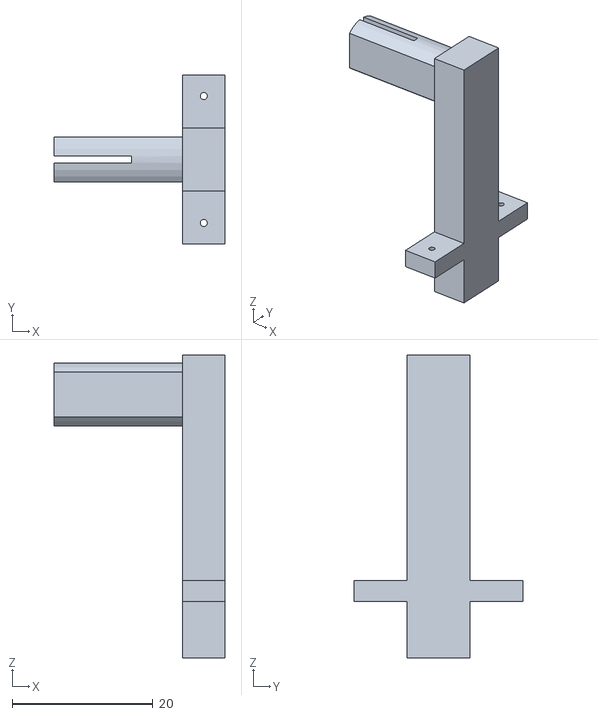
[picture p72: CAD file, 2020-01-13]
Mechatronics/Hardware/Mechanical/FreeCadFiles/EncoderNewSTLS/Ancla.stl
24.2 x 24.0 x 43.0
