PaulMaxAvalosAguilar/NN54/Mechatronics/Hardware/Mechanical/FreeCadFiles/EncoderNewSTLS/Tapa.stl

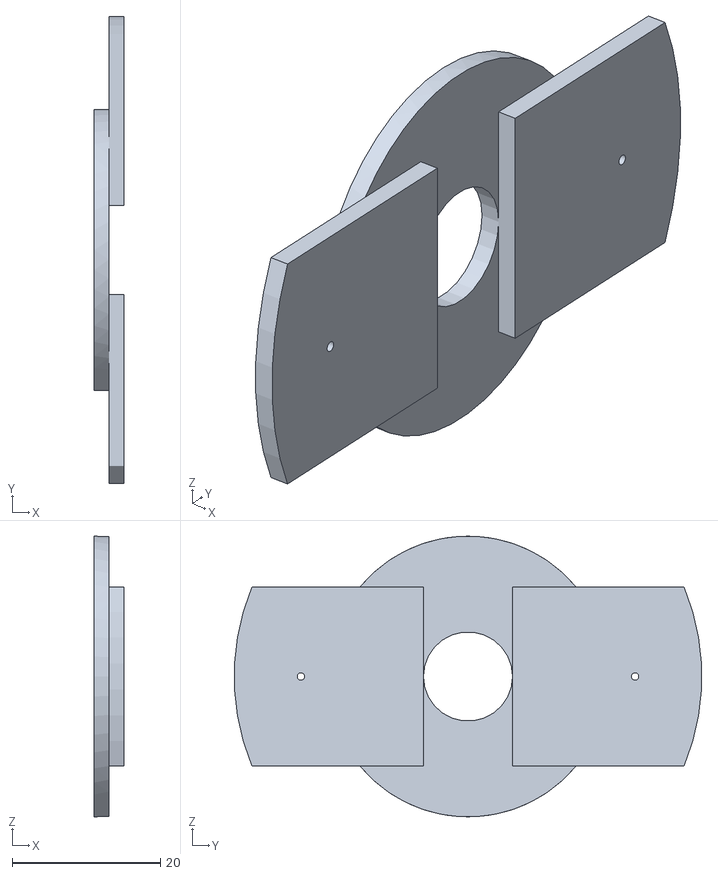
[picture p73: CAD file, 2020-01-13]
Mechatronics/Hardware/Mechanical/FreeCadFiles/EncoderNewSTLS/Tapa.stl
4.00 x 62.9 x 37.8
