PaulMaxAvalosAguilar/NN54/(list of files, cad)

Other CAD files:
Mechatronics/Hardware/Electrical/FootPrints/3DModels/Inductor/L_0402_1005Metric.step
Mechatronics/Hardware/Mechanical/FreeCadFiles/CaseSquaredDWG/SoporteBateria.dwg
Mechatronics/Hardware/Electrical/BEncoderBoard3(2)/BEncoderBoard3(2)(B).step
Mechatronics/Hardware/Mechanical/FreeCadFiles/CaseSquaredDWG/LateralWall(2).dwg
Mechatronics/Hardware/Mechanical/FreeCadFiles/CaseSquaredDWG/LateralWall(4).dwg
Mechatronics/Hardware/Mechanical/FreeCadFiles/CaseSquaredDWG/BareBase.dwg
Mechatronics/Hardware/Mechanical/FreeCadFiles/CaseSquaredDWG/EncoderSupport.dwg
Mechatronics/Hardware/Mechanical/FreeCadFiles/EncoderNewSTLS/YBearing.stl
Mechatronics/Hardware/Mechanical/FreeCadFiles/CaseSquaredDWG/BoardBase(Middle).dwg
Mechatronics/Hardware/Mechanical/FreeCadFiles/CaseSquaredDWG/BoardBase(Top).dwg
Mechatronics/Hardware/Mechanical/FreeCadFiles/CaseSquaredDWG/LateralWall(3).dwg
Mechatronics/Hardware/Mechanical/FreeCadFiles/CaseSquaredDWG/BoardBase(Bottom).dwg
Mechatronics/Hardware/Mechanical/FreeCadFiles/CaseSquaredDWG/RearWall.dwg
Mechatronics/Hardware/Mechanical/FreeCadFiles/CaseSquaredDWG/Soporte Oled B.dwg
Mechatronics/Hardware/Mechanical/FreeCadFiles/CaseSquaredDWG/FrontWall.dwg
Mechatronics/Hardware/Mechanical/FreeCadFiles/CaseSquaredDWG/ShapedBase.dwg
Mechatronics/Hardware/Mechanical/FreeCadFiles/CaseSquaredDWG/Soporte Oled A.dwg
Mechatronics/Hardware/Mechanical/FreeCadFiles/CaseSquaredDWG/LateralWall(1).dwg
Mechatronics/Hardware/Mechanical/FreeCadFiles/CaseSquaredDWG/Header.dwg
