PaulMaxAvalosAguilar/NN54/Encoder Characteristics.xlsx

Sheet: Encoder Error
 | Number of measurments | 1 |  | Clock | Presc | Pulses/sec | Time/Pulse
 |  |  |  | 50000000 | 5 | 10000000 | 1e-07
 | PulseDistane | 0.0034
Real Velocity | Time/pulse | Time | Estimated Vel | Error
6 | 0.0005666666667 | 0.0005666 | 6.000705965 | 0.01176609013
5.99 | 0.0005676126878 | 0.0005676 | 5.990133897 | 0.002235344084
5.98 | 0.0005685618729 | 0.0005685 | 5.980650836 | 0.01088353733
5.97 | 0.0005695142379 | 0.0005695 | 5.970149254 | 0.002500062502
5.96 | 0.0005704697987 | 0.0005704 | 5.960729313 | 0.01223679133
5.95 | 0.0005714285714 | 0.0005714 | 5.950297515 | 0.005000250012
5.94 | 0.0005723905724 | 0.0005723 | 5.940940066 | 0.01582603365
5.93 | 0.0005733558179 | 0.0005733 | 5.930577359 | 0.009736241969
5.92 | 0.0005743243243 | 0.0005743 | 5.92025074 | 0.004235473502
5.91 | 0.0005752961083 | 0.0005752 | 5.910987483 | 0.01670867368
5.9 | 0.0005762711864 | 0.0005762 | 5.900728914 | 0.01235446732
5.89 | 0.0005772495756 | 0.0005772 | 5.890505891 | 0.008588972935
5.88 | 0.0005782312925 | 0.0005782 | 5.880318229 | 0.005412057594
5.87 | 0.0005792163543 | 0.0005792 | 5.870165746 | 0.002823609137
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
