PaulMaxAvalosAguilar/NN54/Mechatronics/Hardware/Electrical/BEncoderBoard3(4)/BEncoderBoard3(4).kicad_pcb

## KiCad design Mechatronics/Hardware/Electrical/BEncoderBoard3(4)/BEncoderBoard3(4).kicad_pcb (2021-05-05)

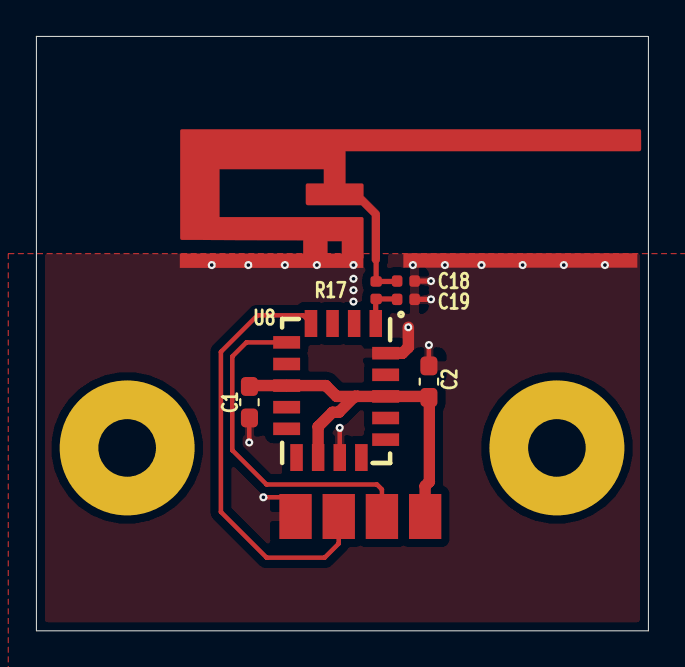
[picture p102: board BEncoderBoard3(4).kicad_pcb from above]

Board: 4 copper layers, 34.0 x 33.0 mm, 9 parts (0 on the bottom side), 6 nets.

Parts:
AE1: LOGO; Antenna
C1: 1uF; C_0603_1608Metric_Pad1.05x0.95mm_HandSolder
C2: 10uF; C_0603_1608Metric_Pad1.05x0.95mm_HandSolder
C18, C19: C_Rf; C_0402_1005Metric
J1: Conn_01x04_Male; SolderWirePad_1x04_SMD_5x10mm_copy
R17: L_Rf; L_0402_1005Metric
U8: RN4871U
e: MountingHole_3.2mm_M3_Pad

Connections:
+3V3: C1.1, C2.1, J1.4, U8.7, U8.11, U8.16
GND: AE1.2, C1.2, C2.2, C18.2, C19.2, J1.1, U8.12, U8.18
unnamed: C18.1, R17.2
unnamed: C19.1, R17.1, U8.1
unnamed: J1.2, U8.4
unnamed: J1.3, U8.5
