PaulMaxAvalosAguilar/NN54/Mechatronics/Hardware/Electrical/BEncoderBoard3(3)/BEncoderBoard3(3).kicad_pcb

## KiCad design Mechatronics/Hardware/Electrical/BEncoderBoard3(3)/BEncoderBoard3(3).kicad_pcb (2022-12-06)

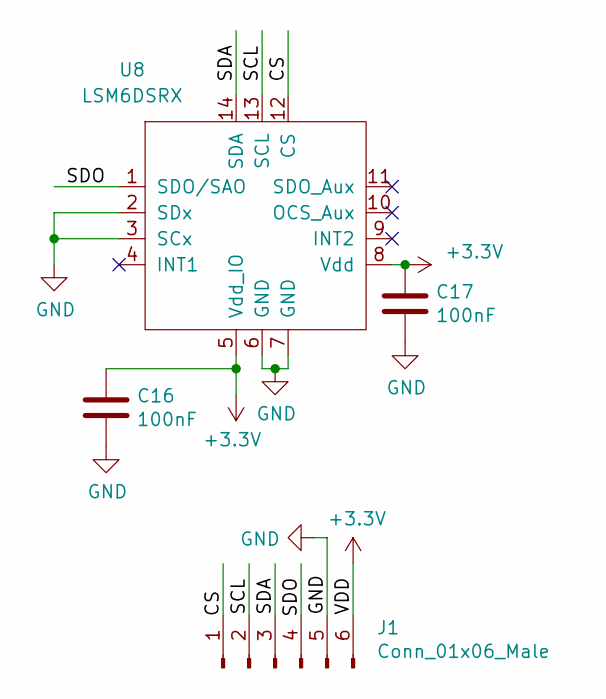
[picture p103: schematic BEncoderBoard3(3).sch, Encoder MCU]

Parts:
C16, C17: 100nF; C_0603_1608Metric_Pad1.05x0.95mm_HandSolder
J1: Conn_01x06_Male; SolderWirePad_1x06_SMD_5x10mm
U8: LSM6DSRX

Connections:
+3V3: C16.2, C17.2, J1.6, U8.5 (Vdd_IO), U8.8 (Vdd)
/CS: J1.1, U8.12 (CS)
/SCL: J1.2, U8.13 (SCL)
/SDA: J1.3, U8.14 (SDA)
/SDO: J1.4, U8.1 (SDO/SAO)
GND: C16.1, C17.1, J1.5, U8.2 (SDx), U8.3 (SCx), U8.6 (GND), U8.7 (GND)

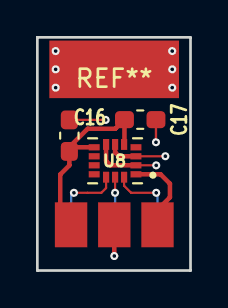
[picture p104: board BEncoderBoard3(3).kicad_pcb from above]

Board: 2 copper layers, 8.5 x 13.0 mm, 4 parts (0 on the bottom side), 6 nets.
