PaulMaxAvalosAguilar/NN54/Mechatronics/Hardware/Electrical/BEncoderBoard3(1.2)/EncoderBoard3(1.2).kicad_pcb

## KiCad design Mechatronics/Hardware/Electrical/BEncoderBoard3(1.2)/EncoderBoard3(1.2).kicad_pcb (2022-12-06)

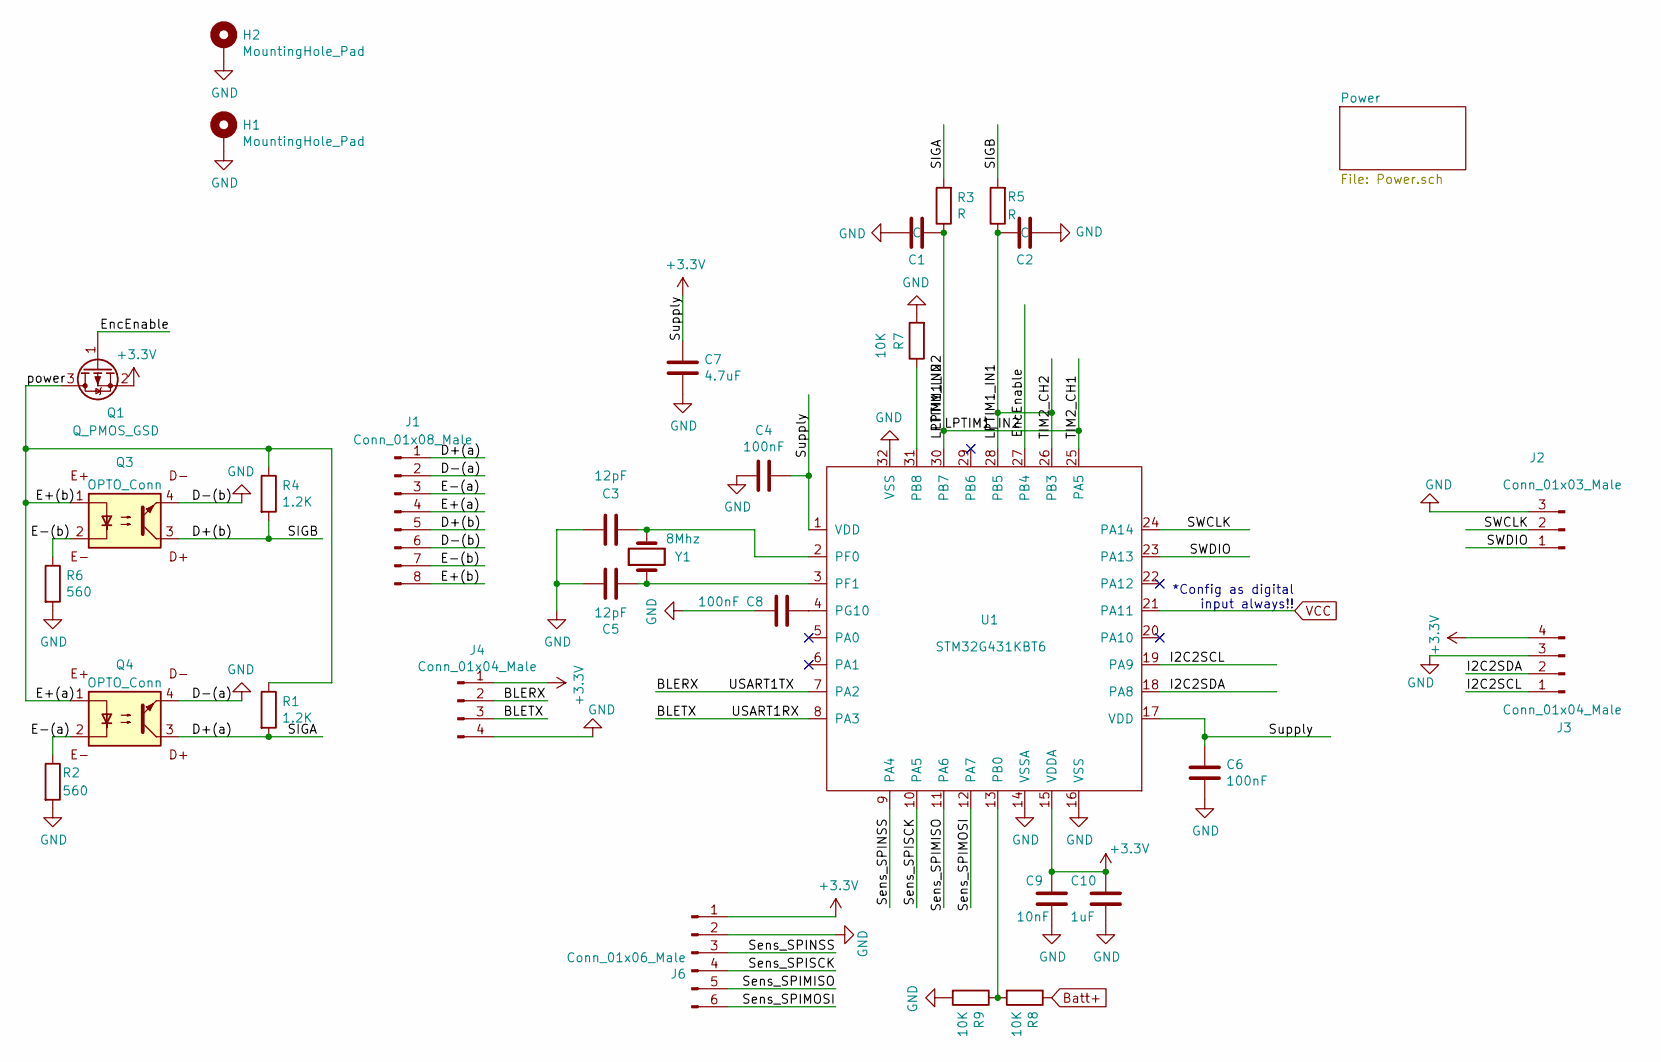
[picture p105: schematic EncoderBoard3(1.2).sch, Encoder MCU]

Parts:
C1, C2: C; C_0603_1608Metric_Pad1.05x0.95mm_HandSolder
C3, C5: 12pF; C_0603_1608Metric_Pad1.05x0.95mm_HandSolder
C4, C6, C8: 100nF; C_0603_1608Metric_Pad1.05x0.95mm_HandSolder
C7: 4.7uF; C_0603_1608Metric_Pad1.05x0.95mm_HandSolder
C9: 10nF; C_0603_1608Metric_Pad1.05x0.95mm_HandSolder
C10: 1uF; C_0603_1608Metric_Pad1.05x0.95mm_HandSolder
H1, H2: MountingHole_Pad; MountingHole_3.2mm_M3_Pad
J1: Conn_01x08_Male; JST_EH_B8B-EH-A_1x08_P2.50mm_Vertical
J2: Conn_01x03_Male; PinHeader_1x03_P2.54mm_Vertical
J3, J4: Conn_01x04_Male; JST_EH_B4B-EH-A_1x04_P2.50mm_Vertical
J6: Conn_01x06_Male; JST_EH_B6B-EH-A_1x06_P2.50mm_Vertical
Q1: Q_PMOS_GSD; SOT-23
Q3, Q4: OPTO_Conn
R1, R4: 1.2K; R_0603_1608Metric_Pad1.05x0.95mm_HandSolder
R2, R6: 560; R_0603_1608Metric_Pad1.05x0.95mm_HandSolder
R3, R5: R; R_0603_1608Metric_Pad1.05x0.95mm_HandSolder
R7, R8, R9: 10K; R_0603_1608Metric_Pad1.05x0.95mm_HandSolder
U1: STM32G431KBT6; LQFP-32_7x7mm_P0.8mm
Y1: 8Mhz; Crystal_HC49-U_Vertical

Connections:
+3V3: C4.1, C6.1, C7.1, C9.1, C10.1, J3.4, J4.1, J6.1, Q1.2 (S), U1.1 (VDD), U1.15 (VDDA), U1.17 (VDD); also elsewhere on the board
/BLERX: J4.2, U1.7 (PA2)
/BLETX: J4.3, U1.8 (PA3)
/D+(a): J1.1, Q4.3, R1.2, R3.2
/D+(b): J1.5, Q3.3, R4.2, R5.2
/E+(a): J1.4, J1.8, Q1.3 (D), Q3.1, Q4.1, R1.1, R4.1
/E-(a): J1.3, Q4.2, R2.1
/E-(b): J1.7, Q3.2, R6.1
/EncEnable: Q1.1 (G), U1.27 (PB4)
/I2C2SCL: J3.1, U1.19 (PA9)
/I2C2SDA: J3.2, U1.18 (PA8)
/LPTIM1_IN1: C2.2, R5.1, U1.26 (PB3), U1.28 (PB5)
/LPTIM1_IN2: C1.1, R3.1, U1.25 (PA5), U1.30 (PB7)
/SWCLK: J2.2, U1.24 (PA14)
/SWDIO: J2.1, U1.23 (PA13)
/Sens_SPIMISO: J6.5, U1.11 (PA6)
/Sens_SPIMOSI: J6.6, U1.12 (PA7)
/Sens_SPINSS: J6.3, U1.9 (PA4)
/Sens_SPISCK: J6.4, U1.10 (PA5)
Batt+: R8.1; also elsewhere on the board
GND: C1.2, C2.1, C3.1, C4.2, C5.1, C6.2, C7.2, C8.2, C9.2, C10.2, H1.1, H2.1, J1.2, J1.6, J2.3, J3.3, J4.4, J6.2, Q3.4, Q4.4, R2.2, R6.2, R7.2, R9.2, U1.14 (VSSA), U1.16 (VSS), U1.32 (VSS); also elsewhere on the board
unnamed: C3.2, U1.2 (PF0), Y1.2
unnamed: C5.2, U1.3 (PF1), Y1.1
unnamed: C8.1, U1.4 (PG10)
unnamed: R7.1, U1.31 (PB8)
unnamed: R8.2, R9.1, U1.13 (PB0)
VCC: U1.21 (PA11); also elsewhere on the board

Notes on the sheet:
*Config as digital input always!!

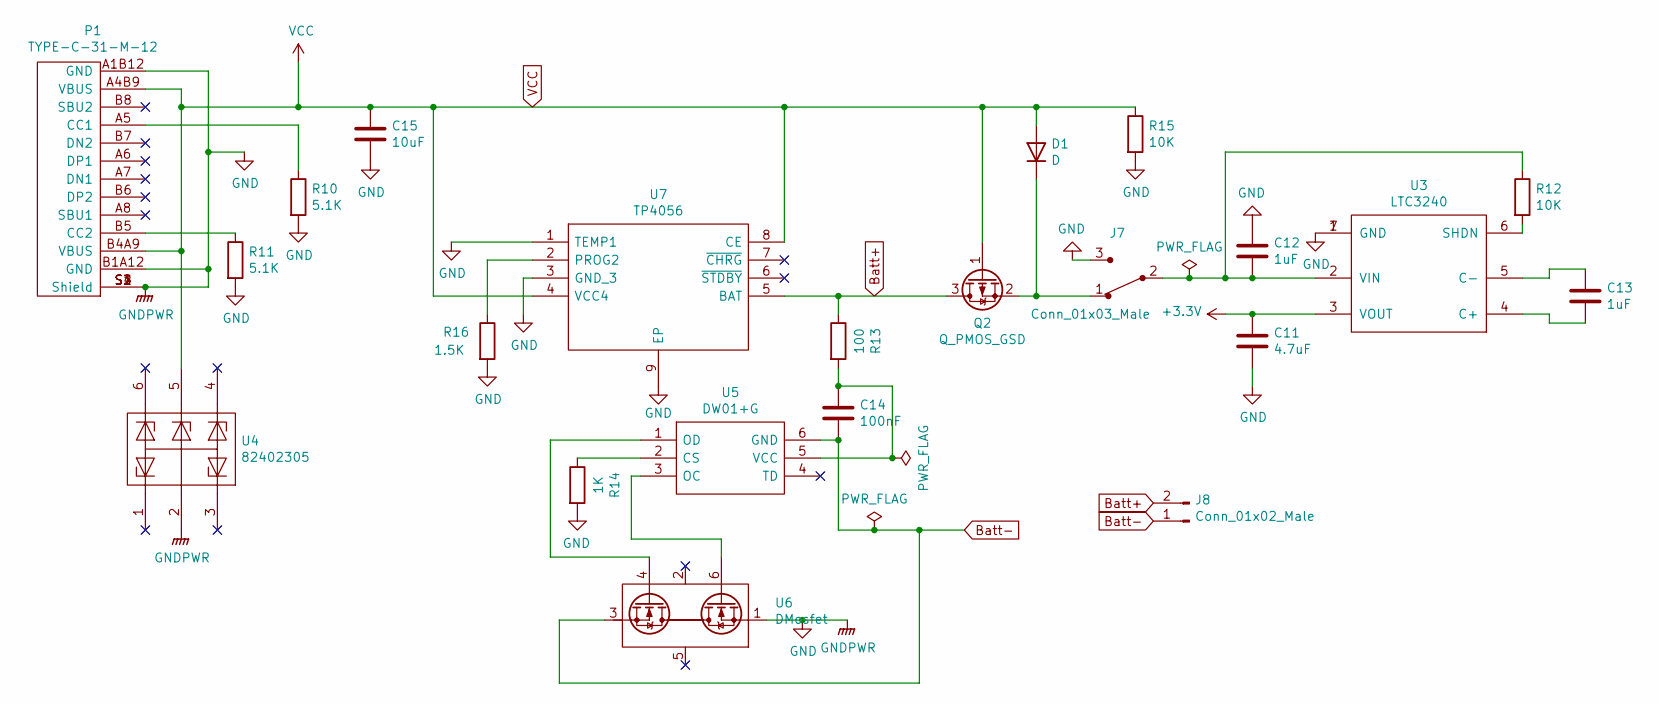
[picture p106: schematic Power.sch, Encoder Power System]

Parts:
C11: 4.7uF; C_0603_1608Metric_Pad1.05x0.95mm_HandSolder
C12, C13: 1uF; C_0603_1608Metric_Pad1.05x0.95mm_HandSolder
C14: 100nF; C_0603_1608Metric_Pad1.05x0.95mm_HandSolder
C15: 10uF; C_0603_1608Metric_Pad1.05x0.95mm_HandSolder
D1: D; D_SMA
J7: Conn_01x03_Male; JST_EH_B3B-EH-A_1x03_P2.50mm_Vertical; MPN EG1218; Digi-Key_PN EG1903-ND
J8: Conn_01x02_Male; JST_EH_B2B-EH-A_1x02_P2.50mm_Vertical
P1: TYPE-C-31-M-12; HRO_TYPE-C-31-M-12
Q2: Q_PMOS_GSD; SOT-23
R10, R11: 5.1K; R_0603_1608Metric_Pad1.05x0.95mm_HandSolder
R12, R15: 10K; R_0603_1608Metric_Pad1.05x0.95mm_HandSolder
R13: 100; R_0603_1608Metric_Pad1.05x0.95mm_HandSolder
R14: 1K; R_0603_1608Metric_Pad1.05x0.95mm_HandSolder
R16: 1.5K; R_0603_1608Metric_Pad1.05x0.95mm_HandSolder
U3: LTC3240; DFN-6_DC
U4: 82402305; Sot-23(6)
U5: DW01+G; Sot-23(6); Manufacturer_Part_Number DW01+G
U6: DMosfet; Sot-23(6)
U7: TP4056; Sop(8); Manufacturer_Part_Number TP4056

Connections:
+3V3: C11.1, U3.3 (VOUT); also elsewhere on the board
Batt+: J8.2, Q2.3 (D), R13.1, U7.5 (BAT); also elsewhere on the board
Batt-: C14.2, J8.1, U5.6 (GND), U6.3 (S)
GND: C11.2, C12.1, C15.2, J7.3, P1.A1B12 (GND), P1.B1A12 (GND), P1.S1 (Shield), P1.S2 (Shield), P1.S3 (Shield), P1.S4 (Shield), R10.2, R11.2, R14.2, R15.2, R16.2, U3.1 (GND), U3.7 (GND), U4.2, U6.1 (S), U7.1 (TEMP1), U7.3 (GND_3), U7.9 (EP); also elsewhere on the board
unnamed: C12.2, J7.2, R12.1, U3.2 (VIN)
unnamed: C13.1, U3.5 (C-)
unnamed: C13.2, U3.4 (C+)
unnamed: C14.1, R13.2, U5.5 (VCC)
unnamed: D1.1 (K), J7.1, Q2.2 (S)
unnamed: P1.A5 (CC1), R10.1
unnamed: P1.B5 (CC2), R11.1
unnamed: R12.2, U3.6 (SHDN)
unnamed: R14.1, U5.2 (CS)
unnamed: R16.1, U7.2 (PROG2)
unnamed: U5.1 (OD), U6.4 (G)
unnamed: U5.3 (OC), U6.6 (G)
VCC: C15.1, D1.2 (A), P1.A4B9 (VBUS), P1.B4A9 (VBUS), Q2.1 (G), R15.1, U4.5, U7.4 (VCC4), U7.8 (CE); also elsewhere on the board

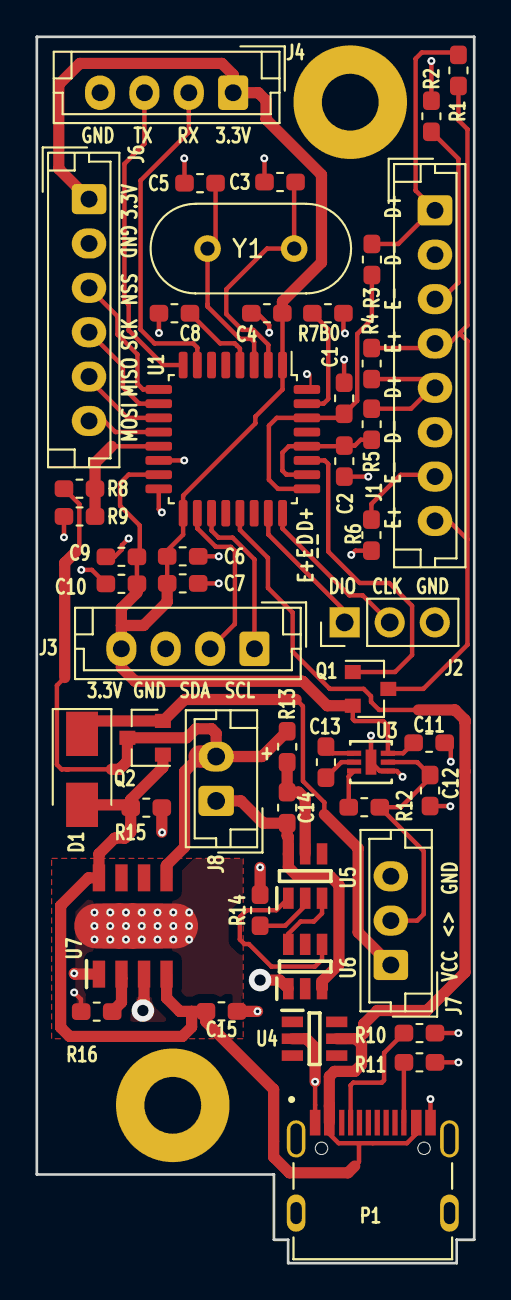
[picture p107: board EncoderBoard3(1.2).kicad_pcb from above]

Board: 2 copper layers, 24.6 x 69.1 mm, 51 parts (0 on the bottom side), 40 nets.
