PaulMaxAvalosAguilar/NN54/Mechatronics/Hardware/Electrical/BEncoderBoard3(RN4871)/BEncoderBoard3(RN4871).kicad_pcb

## KiCad design Mechatronics/Hardware/Electrical/BEncoderBoard3(RN4871)/BEncoderBoard3(RN4871).kicad_pcb (2021-05-05)

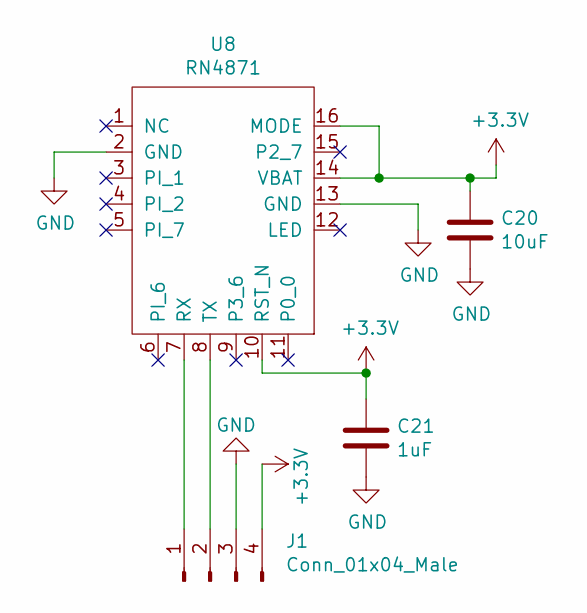
[picture p108: schematic BEncoderBoard3(RN4871).sch]

Parts:
C20: 10uF; C_0603_1608Metric_Pad1.05x0.95mm_HandSolder
C21: 1uF; C_0603_1608Metric_Pad1.05x0.95mm_HandSolder
J1: Conn_01x04_Male; SolderWirePad_1x04_SMD_5x10mm_copy
U8: RN4871; Bluetooth_Module_RN4871

Connections:
+3V3: C20.1, C21.1, J1.4, U8.10 (RST_N), U8.14 (VBAT), U8.16 (MODE)
GND: C20.2, C21.2, J1.3, U8.2 (GND), U8.13 (GND)
unnamed: J1.1, U8.7 (RX)
unnamed: J1.2, U8.8 (TX)

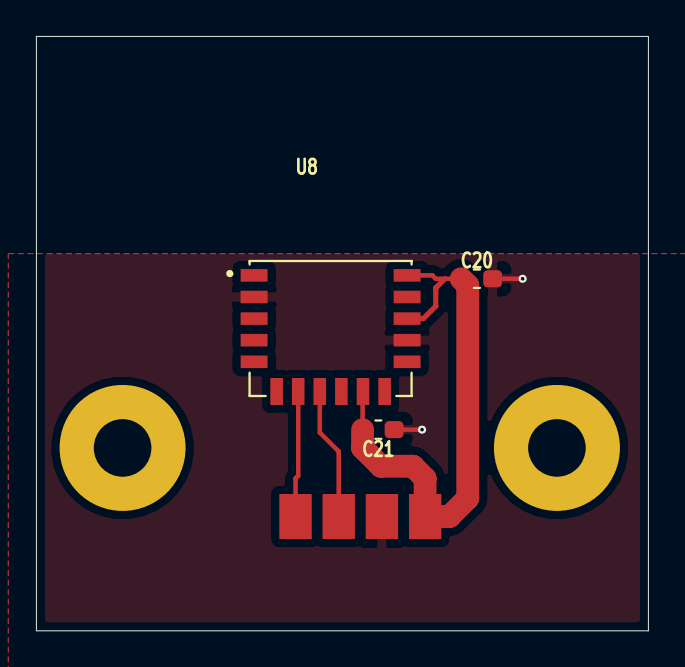
[picture p109: board BEncoderBoard3(RN4871).kicad_pcb from above]

Board: 4 copper layers, 34.0 x 33.0 mm, 4 parts (0 on the bottom side), 4 nets.
