PaulMaxAvalosAguilar/NN54/Mechatronics/Hardware/Electrical/BRN4871Board/RN4871Board.kicad_pcb

## KiCad design Mechatronics/Hardware/Electrical/BRN4871Board/RN4871Board.kicad_pcb (2020-05-24)

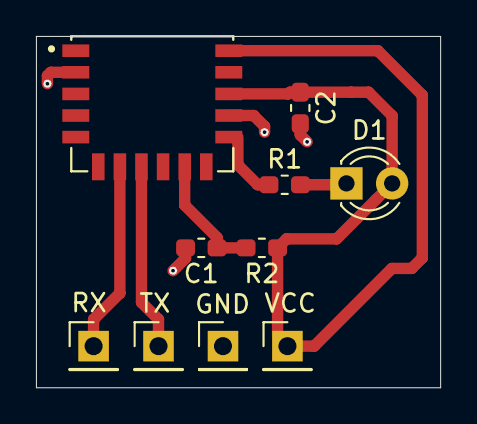
[picture p110: board RN4871Board.kicad_pcb from above]

Board: 2 copper layers, 22.5 x 19.5 mm, 10 parts (0 on the bottom side), 7 nets.

Parts:
C1: 1uF; C_0603_1608Metric_Pad1.05x0.95mm_HandSolder
C2: 10uF; C_0603_1608Metric_Pad1.05x0.95mm_HandSolder
D1: LED; LED_D3.0mm
J1, J2, J3, J4: Conn_01x01_Male; PinHeader_1x01_P2.54mm_Vertical
R1: 330; R_0603_1608Metric_Pad1.05x0.95mm_HandSolder
R2: 10K; R_0603_1608Metric_Pad1.05x0.95mm_HandSolder
U1: RN4871; Bluetooth_Module_RN4871

Connections:
+3V3: C2.1, D1.2, J4.1, R2.1, U1.14, U1.16
GND: C1.2, C2.2, J1.1, U1.2, U1.13
unnamed: C1.1, R2.2, U1.10
unnamed: D1.1, R1.2
unnamed: J2.1, U1.7
unnamed: J3.1, U1.8
unnamed: R1.1, U1.12
