PaulMaxAvalosAguilar/NN54/Mechatronics/Hardware/Electrical/BEncoderBoard3(1)/EncoderBoard3(1).kicad_pcb

## KiCad design Mechatronics/Hardware/Electrical/BEncoderBoard3(1)/EncoderBoard3(1).kicad_pcb (2021-05-05)

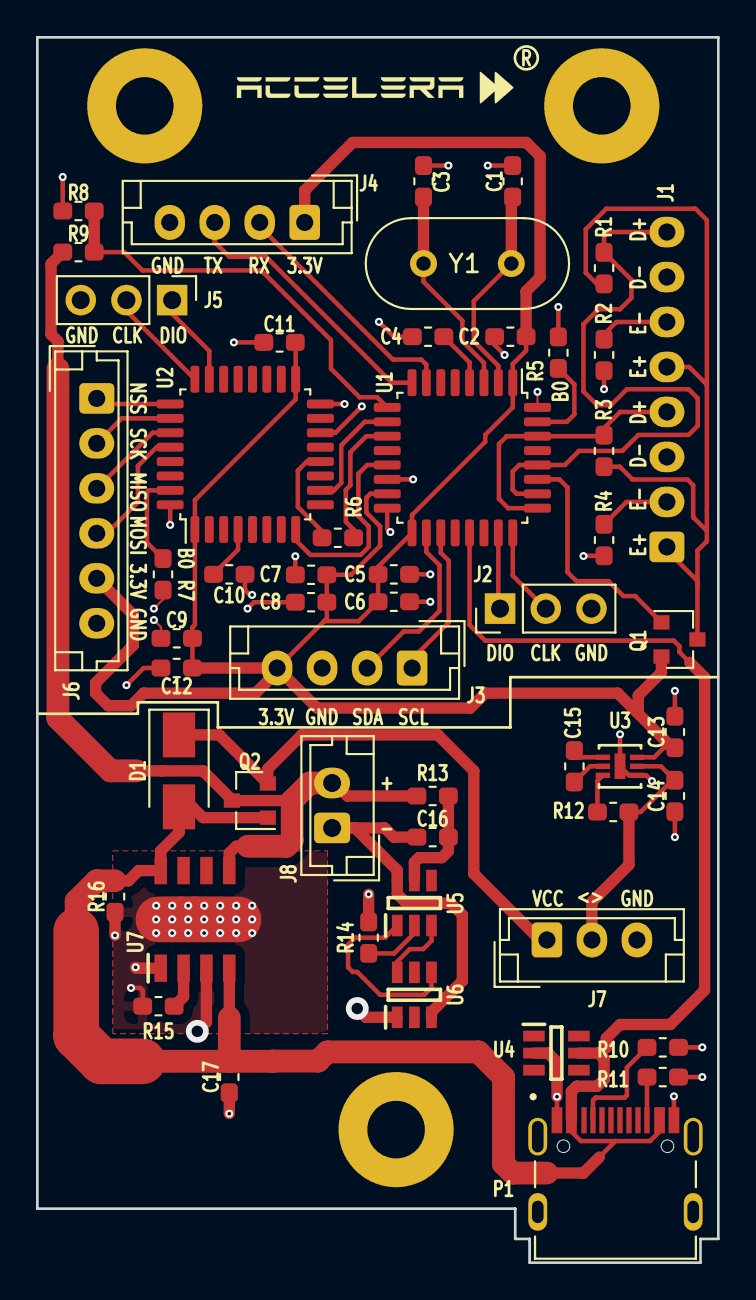
[picture p111: board EncoderBoard3(1).kicad_pcb from above]

Board: 2 copper layers, 37.8 x 68.1 mm, 53 parts (1 on the bottom side), 46 nets.

Parts:
C1, C3: 12pF; C_0603_1608Metric_Pad1.05x0.95mm_HandSolder
C2, C4, C5, C9, C10, C11, C16: 100nF; C_0603_1608Metric_Pad1.05x0.95mm_HandSolder
C6, C12, C13: 4.7uF; C_0603_1608Metric_Pad1.05x0.95mm_HandSolder
C7: 10nF; C_0603_1608Metric_Pad1.05x0.95mm_HandSolder
C8, C14, C15: 1uF; C_0603_1608Metric_Pad1.05x0.95mm_HandSolder
C17: 10uF; C_0603_1608Metric_Pad1.05x0.95mm_HandSolder
D1: D; D_SMA
J1: Conn_01x08_Male; JST_EH_B8B-EH-A_1x08_P2.50mm_Vertical
J2, J5: Conn_01x03_Male; PinHeader_1x03_P2.54mm_Vertical
J3, J4: Conn_01x04_Male; JST_EH_B4B-EH-A_1x04_P2.50mm_Vertical
J6: Conn_01x06_Male; JST_EH_B6B-EH-A_1x06_P2.50mm_Vertical
J7: Conn_01x03_Male; JST_EH_B3B-EH-A_1x03_P2.50mm_Vertical
J8: Conn_01x02_Male; JST_EH_B2B-EH-A_1x02_P2.50mm_Vertical
P1: TYPE-C-31-M-12; HRO_TYPE-C-31-M-12
Q1, Q2: Q_PMOS_GSD; SOT-23
R1, R3: 1.2K; R_0603_1608Metric_Pad1.05x0.95mm_HandSolder
R2, R4: 560; R_0603_1608Metric_Pad1.05x0.95mm_HandSolder
R5, R7, R8, R9, R12, R16: 10K; R_0603_1608Metric_Pad1.05x0.95mm_HandSolder
R6, R14: 1K; R_0603_1608Metric_Pad1.05x0.95mm_HandSolder
R10: 5.1k; R_0603_1608Metric_Pad1.05x0.95mm_HandSolder
R11: 5.1K; R_0603_1608Metric_Pad1.05x0.95mm_HandSolder
R13: 100; R_0603_1608Metric_Pad1.05x0.95mm_HandSolder
R15: 1.5K; R_0603_1608Metric_Pad1.05x0.95mm_HandSolder
U1, U2: STM32G431KBT6; LQFP-32_7x7mm_P0.8mm
U3: LTC3240; DFN-6_DC
U4: 82402305; Sot-23(6)
U5: DW01+G; Sot-23(6)
U6: DMosfet; Sot-23(6)
U7: TP4056; Sop(8)
Y1: 8Mhz; Crystal_HC49-U_Vertical

Connections:
+3V3: C2.1, C5.1, C6.1, C7.1, C8.1, C9.1, C11.1, C12.1, C13.1, J3.4, J4.1, J6.5, Q1.2, U1.1, U1.15, U1.17, U2.1, U2.17, U3.3
/BLERX: J4.2, U1.7
/BLETX: J4.3, U1.8
/D+(a): J1.8, R1.2, U1.26, U1.28
/D+(b): J1.4, R3.2, U1.25, U1.30
/Data: U1.13, U2.8
/E+(a): J1.1, J1.5, Q1.3, R1.1, R3.1
/E-(a): J1.6, R2.1
/E-(b): J1.2, R4.1
/EncEnable: Q1.1, U1.27
/I2C2SCL: J3.1, U1.19
/I2C2SDA: J3.2, U1.18
/SPI1MISO: R6.2, U1.11
/SPI1SCK: U1.10, U2.10
/SWCLK: J2.2, U1.24
/SWDIO: J2.1, U1.23
/Sens_SPI1MOSI: R6.1, U2.12
/Sens_SPI3MISO: J6.3, U2.27
/Sens_SPI3MOSI: J6.4, U2.28
/Sens_SPI3NSS: J6.1, U2.25
/Sens_SPI3SCK: J6.2, U2.26
/Sens_SWCLK: J5.2, U2.24
/Sens_SWDIO: J5.1, U2.23
Batt+: J8.2, Q2.3, R9.1, R13.1, U7.5
Batt-: C16.2, J8.1, U5.6, U6.3
GND: C1.1, C2.2, C3.1, C4.2, C5.2, C6.2, C7.2, C8.2, C9.2, C10.2, C11.2, C12.2, C13.2, C14.1, C17.2, J1.3, J1.7, J2.3, J3.3, J4.4, J5.3, J6.6, J7.3, P1.A1B12, P1.B1A12, P1.S1, P1.S2, P1.S3, P1.S4, R2.2, R4.2, R5.2, R7.2, R8.2, R10.2, R11.2, R14.2, R15.2, R16.2, U1.14, U1.16, U1.32, U2.14, U2.16, U2.32, U3.1, U3.7, U4.2, U6.1, U7.1, U7.3, U7.9
unnamed: C1.2, U1.2, Y1.2
unnamed: C3.2, U1.3, Y1.1
unnamed: C4.1, U1.4
unnamed: C10.1, U2.4
unnamed: C14.2, J7.2, R12.1, U3.2
unnamed: C15.1, U3.5
unnamed: C15.2, U3.4
unnamed: C16.1, R13.2, U5.5
unnamed: D1.1, J7.1, Q2.2
unnamed: P1.A5, R10.1
unnamed: P1.B5, R11.1
unnamed: R5.1, U1.31
unnamed: R7.1, U2.31
unnamed: R8.1, R9.2, U1.9
unnamed: R12.2, U3.6
unnamed: R14.1, U5.2
unnamed: R15.1, U7.2
unnamed: U5.1, U6.4
unnamed: U5.3, U6.6
VCC: C17.1, D1.2, P1.A4B9, P1.B4A9, Q2.1, R16.1, U1.21, U4.5, U7.4, U7.8
