PaulMaxAvalosAguilar/NN54/Mechatronics/Hardware/Electrical/BEncoderBoard3(2)/BEncoderBoard3(2).kicad_pcb

## KiCad design Mechatronics/Hardware/Electrical/BEncoderBoard3(2)/BEncoderBoard3(2).kicad_pcb (2021-05-05)

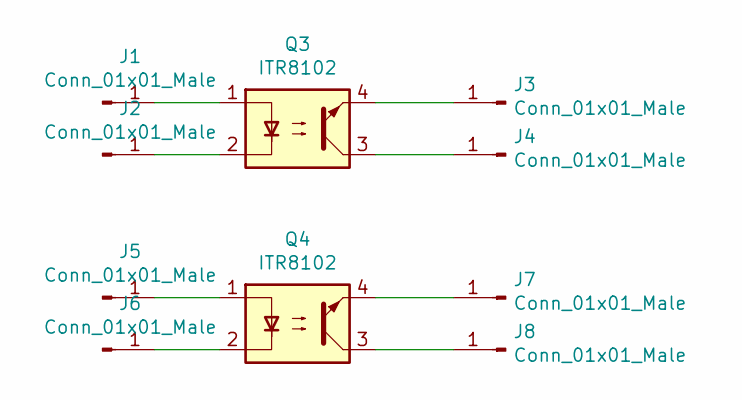
[picture p112: schematic BEncoderBoard3(2).sch]

Parts:
J1, J2, J3, J4, J5, J6, J7, J8: Conn_01x01_Male; PinHeader_1x01_P2.54mm_Vertical_NO3D
Q3, Q4: ITR8102; itr8102

Connections:
unnamed: J1.1, Q3.1
unnamed: J2.1, Q3.2
unnamed: J3.1, Q3.4
unnamed: J4.1, Q3.3
unnamed: J5.1, Q4.1
unnamed: J6.1, Q4.2
unnamed: J7.1, Q4.4
unnamed: J8.1, Q4.3

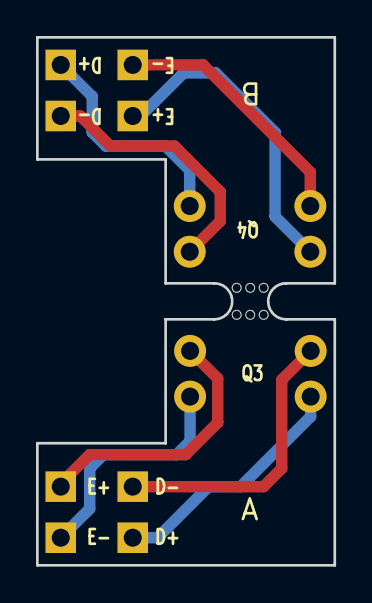
[picture p113: board BEncoderBoard3(2).kicad_pcb from above]

Board: 2 copper layers, 16.5 x 29.3 mm, 11 parts (0 on the bottom side), 8 nets.

Other parts of the board:
mouse-bite-2mm-slot: VAL**; mouse-bite-2mm-slot
