PaulMaxAvalosAguilar/NN54/Mechatronics/Hardware/Electrical/BEncoderBoard2/EncoderBoard2.kicad_pcb

## KiCad design Mechatronics/Hardware/Electrical/BEncoderBoard2/EncoderBoard2.kicad_pcb (2021-01-27)

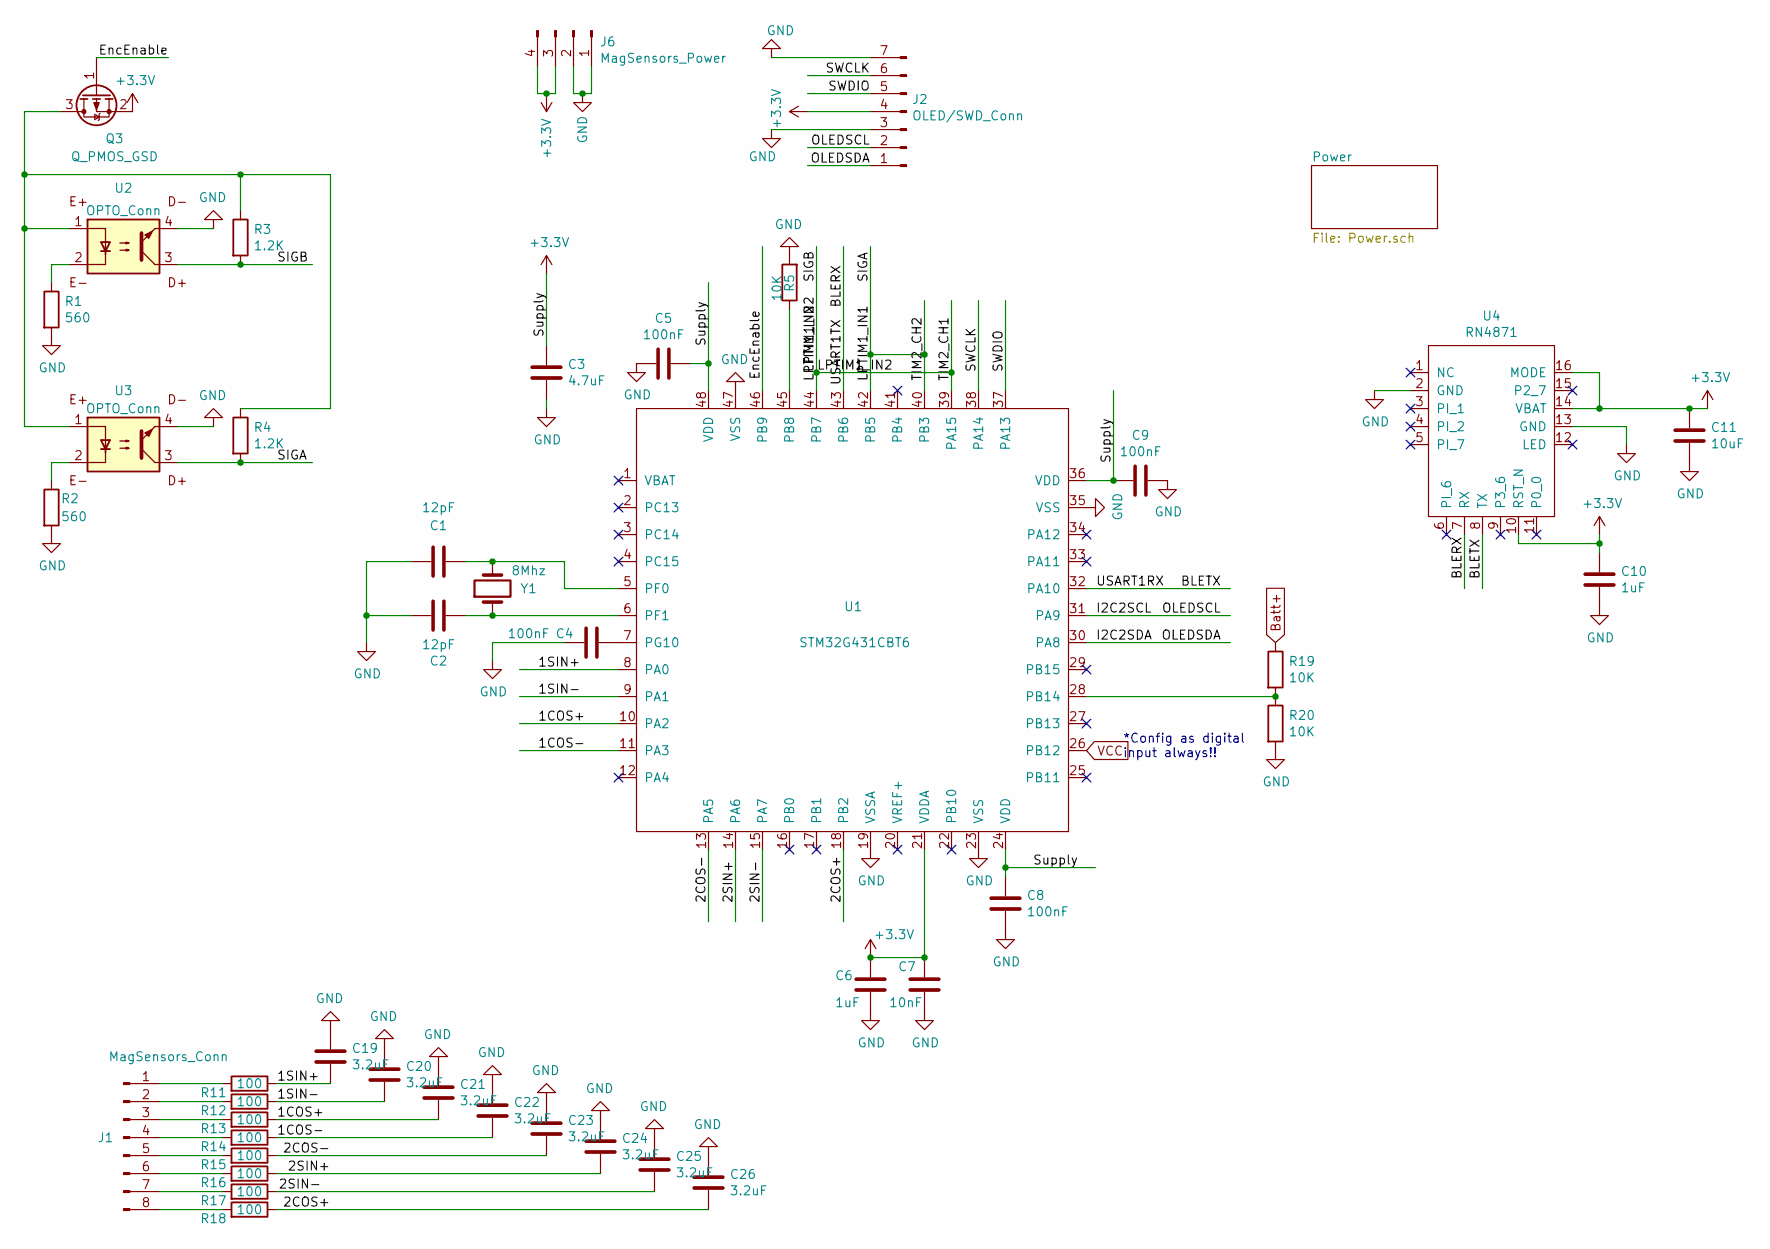
[picture p114: schematic EncoderBoard2.sch, Encoder MCU]

Parts:
C1, C2: 12pF; C_0603_1608Metric_Pad1.05x0.95mm_HandSolder
C3: 4.7uF; C_0603_1608Metric_Pad1.05x0.95mm_HandSolder
C4, C5, C8, C9: 100nF; C_0603_1608Metric_Pad1.05x0.95mm_HandSolder
C6, C10: 1uF; C_0603_1608Metric_Pad1.05x0.95mm_HandSolder
C7: 10nF; C_0603_1608Metric_Pad1.05x0.95mm_HandSolder
C11: 10uF; C_0603_1608Metric_Pad1.05x0.95mm_HandSolder
C19, C20, C21, C22, C23, C24, C25, C26: 3.2uF; C_0603_1608Metric_Pad1.05x0.95mm_HandSolder
J1: MagSensors_Conn; PinHeader_1x08_P2.54mm_Vertical
J2: OLED/SWD_Conn; PinHeader_1x07_P2.54mm_Vertical
J6: MagSensors_Power; PinHeader_2x02_P2.54mm_Vertical
Q3: Q_PMOS_GSD; SOT-23
R1, R2: 560; R_0603_1608Metric_Pad1.05x0.95mm_HandSolder
R3, R4: 1.2K; R_0603_1608Metric_Pad1.05x0.95mm_HandSolder
R5, R19, R20: 10K; R_0603_1608Metric_Pad1.05x0.95mm_HandSolder
R11, R12, R13, R14, R15, R16, R17, R18: 100; R_0603_1608Metric_Pad1.05x0.95mm_HandSolder
U1: STM32G431CBT6; LQFP-48_7x7mm_P0.5mm
U2, U3: OPTO_Conn; PinHeader_2x02_P2.54mm_Vertical
U4: RN4871; Bluetooth_Module_RN4871
Y1: 8Mhz; Crystal_HC49-U_Vertical

Connections:
+3V3: C3.1, C5.1, C6.1, C7.1, C8.1, C9.2, C10.1, C11.1, J2.4, J6.3, J6.4, Q3.2 (S), U1.21 (VDDA), U1.24 (VDD), U1.36 (VDD), U1.48 (VDD), U4.10 (RST_N), U4.14 (VBAT), U4.16 (MODE); also elsewhere on the board
/1COS+: C21.2, R13.1, U1.10 (PA2)
/1COS-: C22.2, R14.1, U1.11 (PA3)
/1SIN+: C19.2, R11.1, U1.8 (PA0)
/1SIN-: C20.2, R12.1, U1.9 (PA1)
/2COS+: C26.2, R18.1, U1.18 (PB2)
/2COS-: C23.2, R15.1, U1.13 (PA5)
/2SIN+: C24.2, R16.1, U1.14 (PA6)
/2SIN-: C25.2, R17.1, U1.15 (PA7)
/BLERX: U1.43 (PB6), U4.7 (RX)
/BLETX: U1.32 (PA10), U4.8 (TX)
/EncEnable: Q3.1 (G), U1.46 (PB9)
/I2C2SCL: J2.2, U1.31 (PA9)
/I2C2SDA: J2.1, U1.30 (PA8)
/LPTIM1_IN1: R4.2, U1.40 (PB3), U1.42 (PB5), U3.3
/LPTIM1_IN2: R3.2, U1.39 (PA15), U1.44 (PB7), U2.3
/SWCLK: J2.6, U1.38 (PA14)
/SWDIO: J2.5, U1.37 (PA13)
Batt+: R19.1; also elsewhere on the board
GND: C1.1, C2.1, C3.2, C4.2, C5.2, C6.2, C7.2, C8.2, C9.1, C10.2, C11.2, C19.1, C20.1, C21.1, C22.1, C23.1, C24.1, C25.1, C26.1, J2.3, J2.7, J6.1, J6.2, R1.2, R2.2, R5.2, R20.2, U1.19 (VSSA), U1.23 (VSS), U1.35 (VSS), U1.47 (VSS), U2.4, U3.4, U4.2 (GND), U4.13 (GND); also elsewhere on the board
unnamed: C1.2, U1.5 (PF0), Y1.2
unnamed: C2.2, U1.6 (PF1), Y1.1
unnamed: C4.1, U1.7 (PG10)
unnamed: J1.1, R11.2
unnamed: J1.2, R12.2
unnamed: J1.3, R13.2
unnamed: J1.4, R14.2
unnamed: J1.5, R15.2
unnamed: J1.6, R16.2
unnamed: J1.7, R17.2
unnamed: J1.8, R18.2
unnamed: Q3.3 (D), R3.1, R4.1, U2.1, U3.1
unnamed: R1.1, U2.2
unnamed: R2.1, U3.2
unnamed: R5.1, U1.45 (PB8)
unnamed: R19.2, R20.1, U1.28 (PB14)
VCC: U1.26 (PB12); also elsewhere on the board

Notes on the sheet:
*Config as digital input always!!

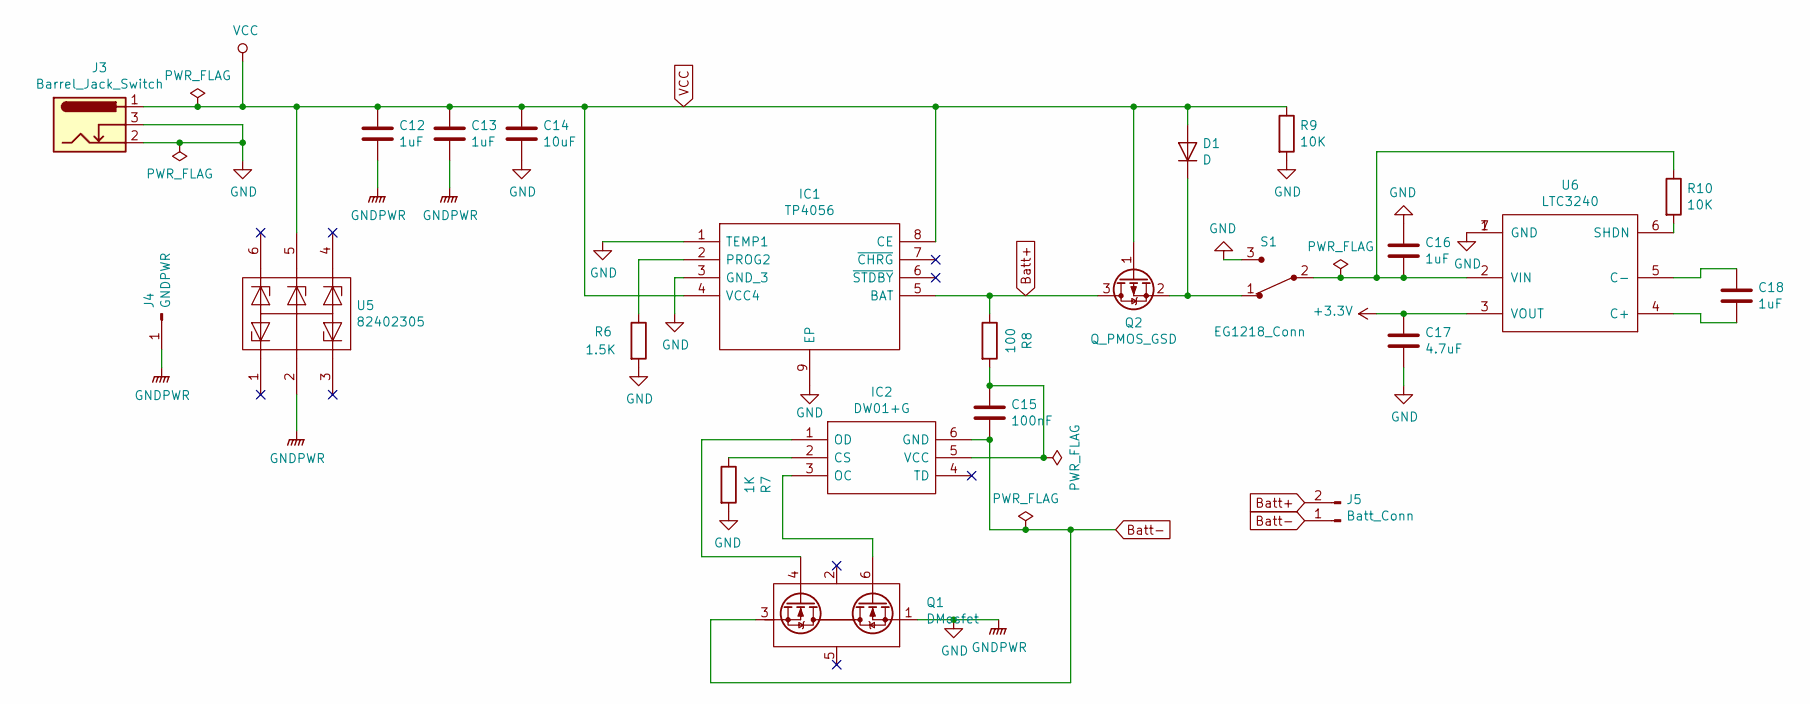
[picture p115: schematic Power.sch, Encoder Power System]

Parts:
C12, C13, C16, C18: 1uF; C_0603_1608Metric_Pad1.05x0.95mm_HandSolder
C14: 10uF; C_0603_1608Metric_Pad1.05x0.95mm_HandSolder
C15: 100nF; C_0603_1608Metric_Pad1.05x0.95mm_HandSolder
C17: 4.7uF; C_0603_1608Metric_Pad1.05x0.95mm_HandSolder
D1: D; D_SMA
IC1: TP4056; Sop(8); Manufacturer_Part_Number TP4056
IC2: DW01+G; Sot-23(6); Manufacturer_Part_Number DW01+G
J3: Barrel_Jack_Switch; BarrelJack_Horizontal
J4: GNDPWR; PinHeader_1x01_P2.54mm_Vertical
J5: Batt_Conn; PinHeader_1x02_P2.54mm_Vertical
Q1: DMosfet; Sot-23(6)
Q2: Q_PMOS_GSD; SOT-23
R6: 1.5K; R_0603_1608Metric_Pad1.05x0.95mm_HandSolder
R7: 1K; R_0603_1608Metric_Pad1.05x0.95mm_HandSolder
R8: 100; R_0603_1608Metric_Pad1.05x0.95mm_HandSolder
R9, R10: 10K; R_0603_1608Metric_Pad1.05x0.95mm_HandSolder
S1: EG1218_Conn; PinHeader_1x03_P2.54mm_Vertical; MPN EG1218; Digi-Key_PN EG1903-ND
U5: 82402305; Sot-23(6)
U6: LTC3240; DFN-6_DC

Connections:
+3V3: C17.1, U6.3 (VOUT); also elsewhere on the board
Batt+: IC1.5 (BAT), J5.2, Q2.3 (D), R8.1; also elsewhere on the board
Batt-: C15.2, IC2.6 (GND), J5.1, Q1.3 (S)
GND: C12.2, C13.2, C14.2, C16.1, C17.2, IC1.1 (TEMP1), IC1.3 (GND_3), IC1.9 (EP), J3.2, J3.3, J4.1, Q1.1 (S), R6.2, R7.2, R9.2, S1.3, U5.2, U6.1 (GND), U6.7 (GND); also elsewhere on the board
unnamed: C15.1, IC2.5 (VCC), R8.2
unnamed: C16.2, R10.1, S1.2, U6.2 (VIN)
unnamed: C18.1, U6.5 (C-)
unnamed: C18.2, U6.4 (C+)
unnamed: D1.1 (K), Q2.2 (S), S1.1
unnamed: IC1.2 (PROG2), R6.1
unnamed: IC2.1 (OD), Q1.4 (G)
unnamed: IC2.2 (CS), R7.1
unnamed: IC2.3 (OC), Q1.6 (G)
unnamed: R10.2, U6.6 (SHDN)
VCC: C12.1, C13.1, C14.1, D1.2 (A), IC1.4 (VCC4), IC1.8 (CE), J3.1, Q2.1 (G), R9.1, U5.5; also elsewhere on the board

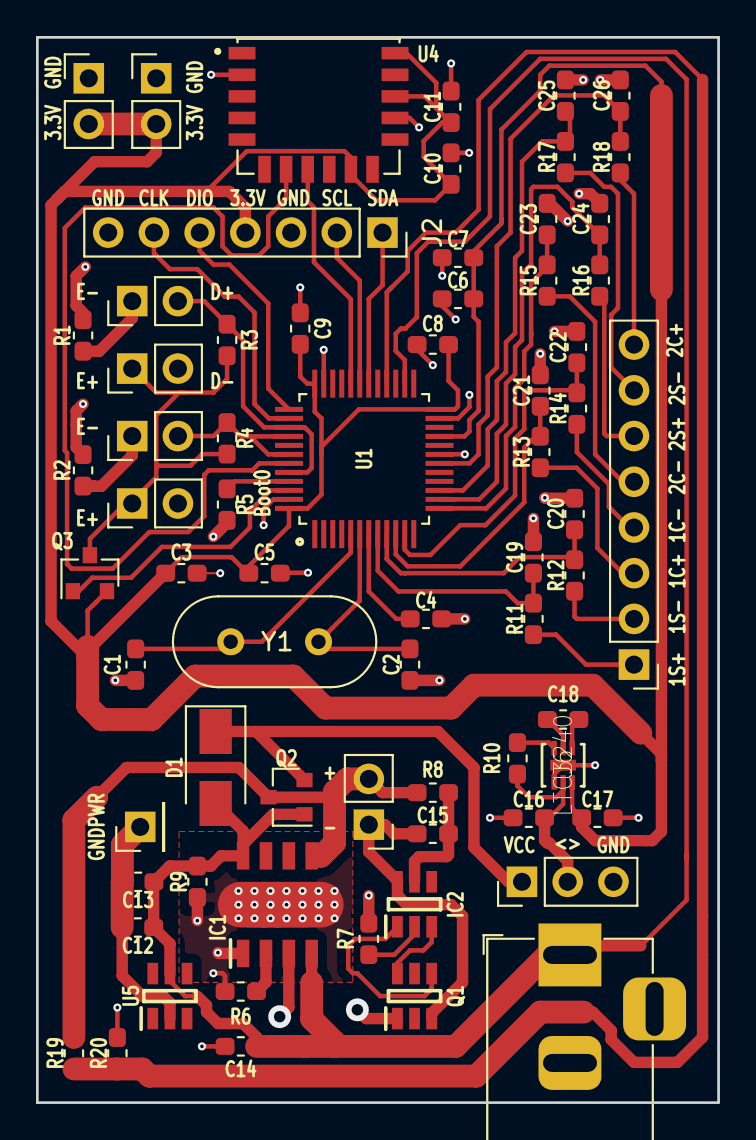
[picture p116: board EncoderBoard2.kicad_pcb from above]

Board: 2 copper layers, 37.8 x 59.2 mm, 66 parts (0 on the bottom side), 48 nets.
