PaulMaxAvalosAguilar/NN54/Mechatronics/Hardware/Electrical/BEncoderBoard/EncoderBoard.kicad_pcb

## KiCad design Mechatronics/Hardware/Electrical/BEncoderBoard/EncoderBoard.kicad_pcb (2020-07-02)

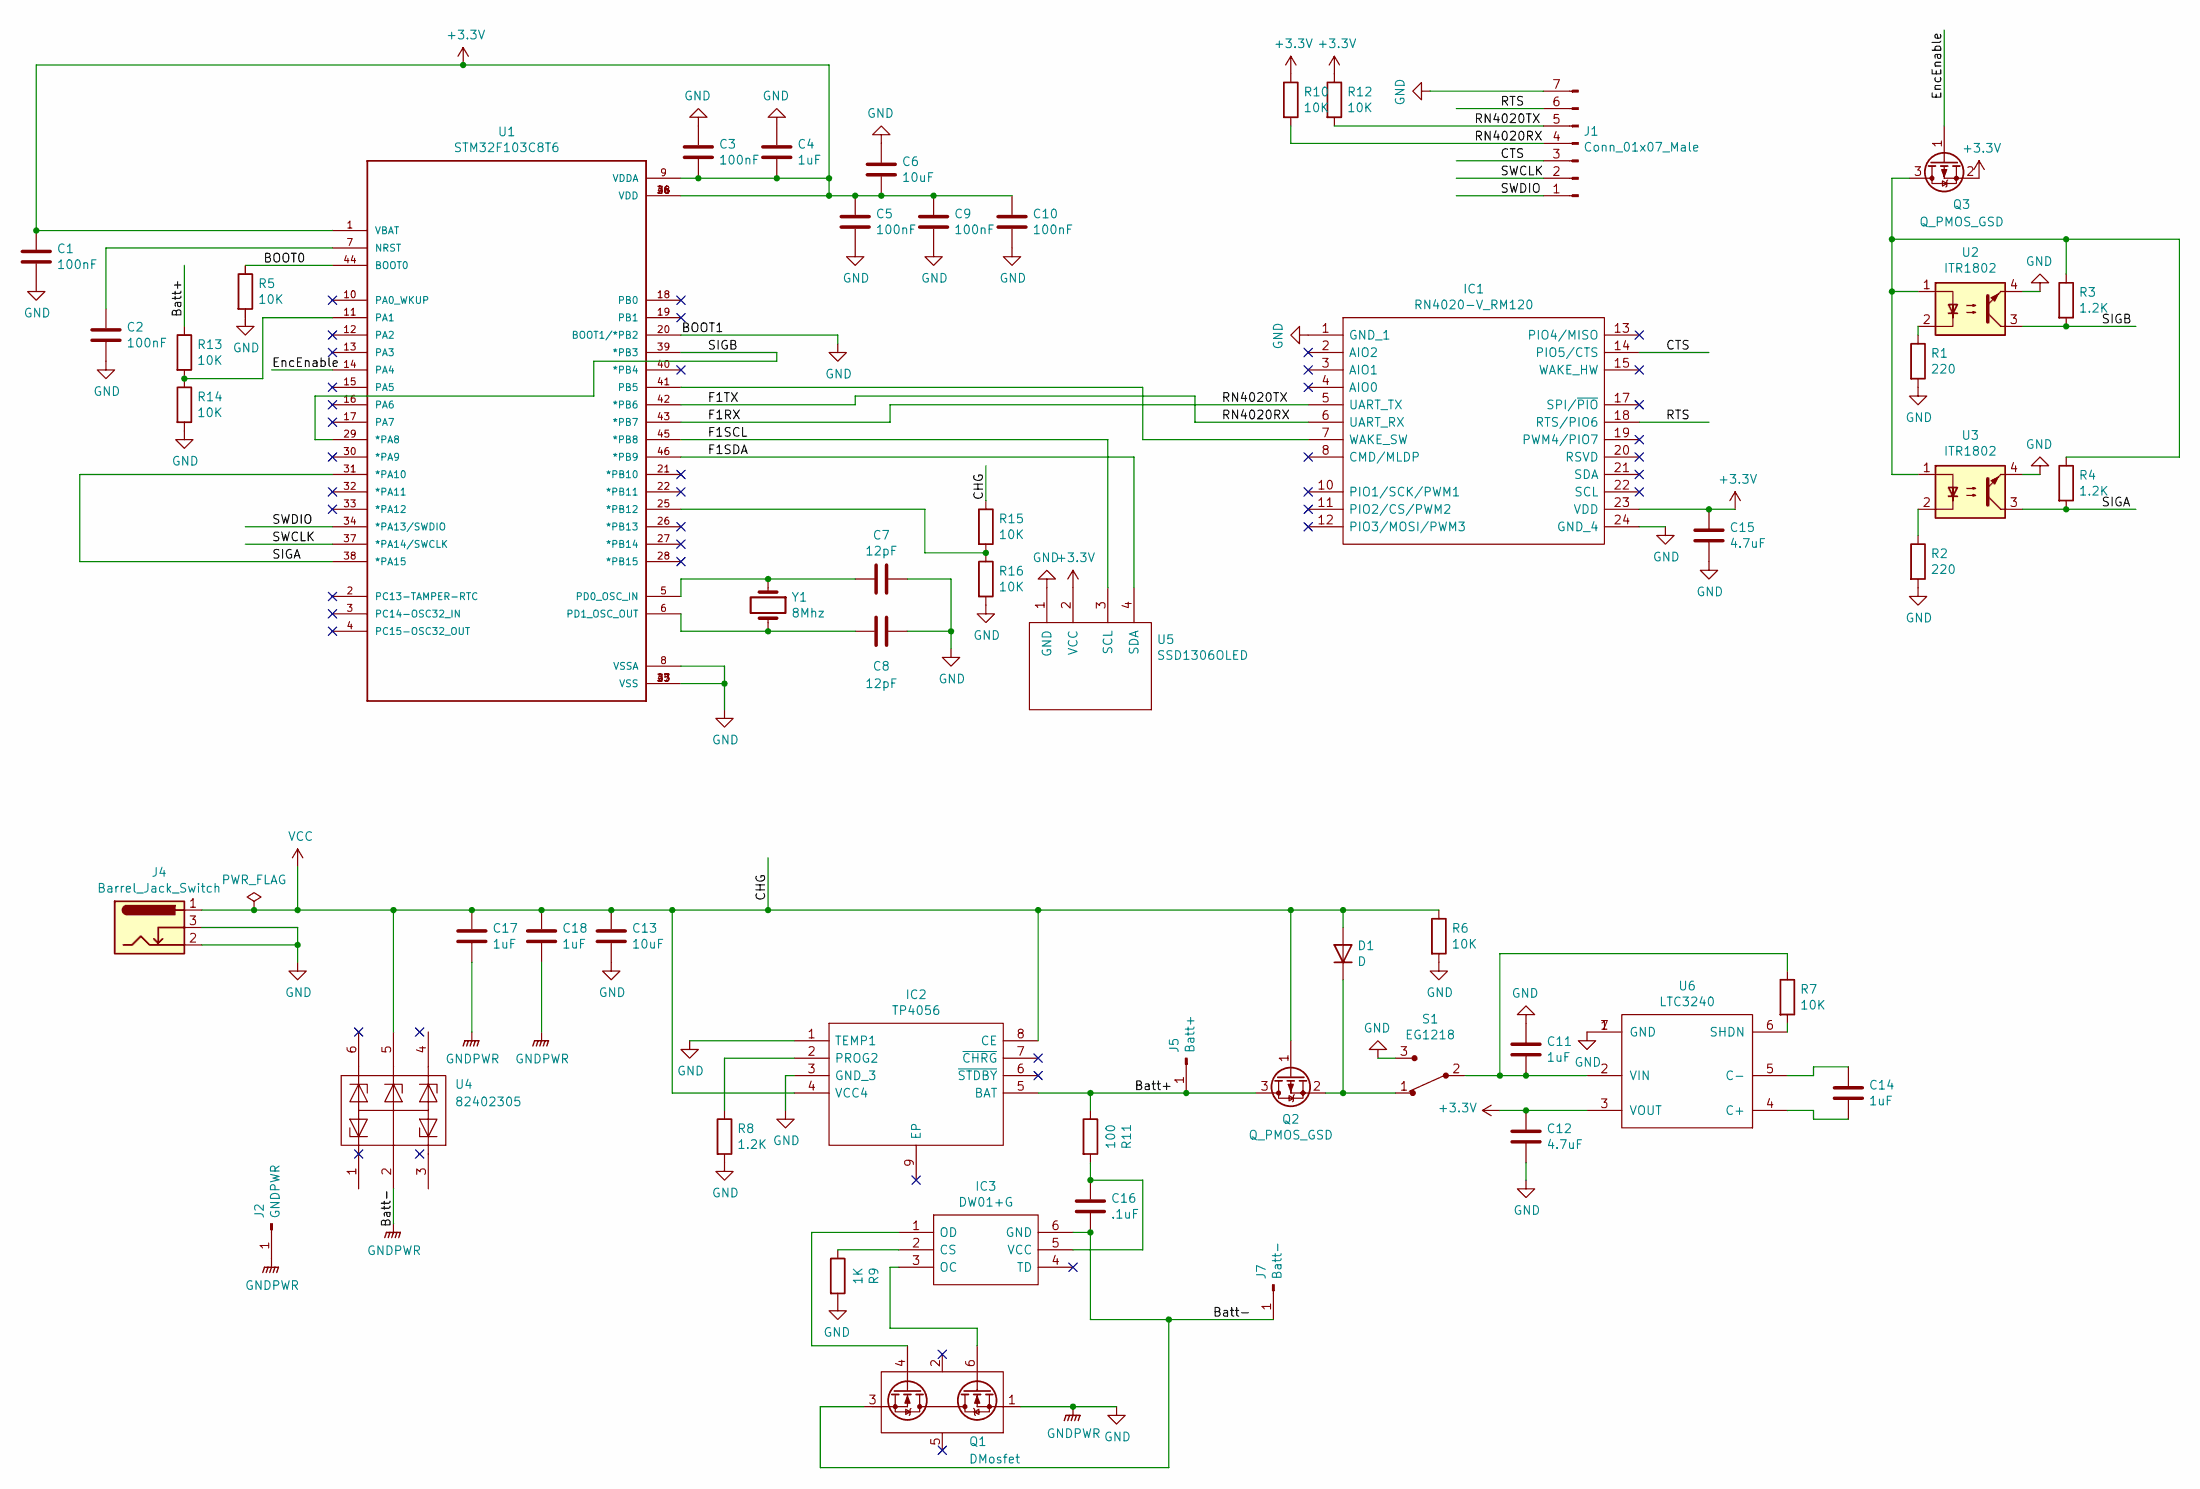
[picture p117: schematic EncoderBoard.sch, Encoder]

Parts:
C1, C2, C3, C5, C9, C10: 100nF; C_0603_1608Metric_Pad1.05x0.95mm_HandSolder
C4, C11, C14, C17, C18: 1uF; C_0603_1608Metric_Pad1.05x0.95mm_HandSolder
C6, C13: 10uF; C_0603_1608Metric_Pad1.05x0.95mm_HandSolder
C7, C8: 12pF; C_0603_1608Metric_Pad1.05x0.95mm_HandSolder
C12, C15: 4.7uF; C_0603_1608Metric_Pad1.05x0.95mm_HandSolder
C16: .1uF; C_0603_1608Metric_Pad1.05x0.95mm_HandSolder
D1: D; D_SMA
IC1: RN4020-V_RM120; Bluetooth_Module_RN4020; Manufacturer_Part_Number RN4020-V/RM120
IC2: TP4056; Sop(8); Manufacturer_Part_Number TP4056
IC3: DW01+G; Sot-23(6); Manufacturer_Part_Number DW01+G
J1: Conn_01x07_Male; PinHeader_1x07_P2.54mm_Vertical
J2: GNDPWR; No3dmodelPinHeader_1x01_P2.54mm_Vertical
J4: Barrel_Jack_Switch; BarrelJack_Horizontal
J5: Batt+; PinHeader_1x01_P2.54mm_Vertical_NO3D
J7: Batt-; PinHeader_1x01_P2.54mm_Vertical_NO3D
Q1: DMosfet; Sot-23(6)
Q2, Q3: Q_PMOS_GSD; SOT-23
R1, R2: 220; R_0603_1608Metric_Pad1.05x0.95mm_HandSolder
R3, R4, R8: 1.2K; R_0603_1608Metric_Pad1.05x0.95mm_HandSolder
R5, R6, R7, R10, R12, R13, R14, R15, R16: 10K; R_0603_1608Metric_Pad1.05x0.95mm_HandSolder
R9: 1K; R_0603_1608Metric_Pad1.05x0.95mm_HandSolder
R11: 100; R_0603_1608Metric_Pad1.05x0.95mm_HandSolder
S1: EG1218; Switch_Slide_11.6x4mm_EG1218; MPN EG1218; Digi-Key_PN EG1903-ND
U1: STM32F103C8T6; LQFP-48_7x7mm_P0.5mm
U2, U3: ITR1802; OptointerrupterConnector
U4: 82402305; Sot-23(6)
U5: SSD1306OLED; PinSocket_1x04_P2.54mm_Vertical
U6: LTC3240; DFN-6_DC
Y1: 8Mhz; Crystal_HC49-U_Vertical

Connections:
+3V3: C1.1, C3.2, C4.2, C5.1, C6.2, C9.1, C10.1, C12.1, C15.1, IC1.23 (VDD), Q3.2 (S), R10.1, R12.1, U1.1 (VBAT), U1.9 (VDDA), U1.24 (VDD), U1.36 (VDD), U1.48 (VDD), U5.2 (VCC), U6.3 (VOUT)
/BOOT0: R5.1, U1.44 (BOOT0)
/Batt+: IC2.5 (BAT), J5.1, Q2.3 (D), R11.1, R13.1
/CTS: IC1.14 (PIO5/CTS), J1.3
/EncEnable: Q3.1 (G), U1.14 (PA4)
/F1RX: IC1.5 (UART_TX), J1.5, R12.2, U1.43 (*PB7)
/F1SCL: U1.45 (*PB8), U5.3 (SCL)
/F1SDA: U1.46 (*PB9), U5.4 (SDA)
/F1TX: IC1.6 (UART_RX), J1.4, R10.2, U1.42 (*PB6)
/RTS: IC1.18 (RTS/PIO6), J1.6
/SIGA: R4.2, U1.31 (*PA10), U1.38 (*PA15), U3.3
/SIGB: R3.2, U1.29 (*PA8), U1.39 (*PB3), U2.3
/SWCLK: J1.2, U1.37 (*PA14/SWCLK)
/SWDIO: J1.1, U1.34 (*PA13/SWDIO)
GND: C1.2, C2.2, C3.1, C4.1, C5.2, C6.1, C7.1, C8.1, C9.2, C10.2, C11.1, C12.2, C13.2, C15.2, C16.2, C17.2, C18.2, IC1.1 (GND_1), IC1.24 (GND_4), IC2.1 (TEMP1), IC2.3 (GND_3), IC3.6 (GND), J1.7, J2.1, J4.2, J4.3, J7.1, Q1.1 (S), Q1.3 (S), R1.2, R2.2, R5.2, R6.2, R8.2, R9.2, R14.2, R16.2, S1.3, U1.8 (VSSA), U1.20 (BOOT1/*PB2), U1.23 (VSS), U1.35 (VSS), U1.47 (VSS), U2.4, U3.4, U4.2, U5.1 (GND), U6.1 (GND), U6.7 (GND)
unnamed: C2.1, U1.7 (NRST)
unnamed: C7.2, U1.5 (PD0_OSC_IN), Y1.1
unnamed: C8.2, U1.6 (PD1_OSC_OUT), Y1.2
unnamed: C11.2, R7.1, S1.2, U6.2 (VIN)
unnamed: C14.1, U6.5 (C-)
unnamed: C14.2, U6.4 (C+)
unnamed: C16.1, IC3.5 (VCC), R11.2
unnamed: D1.1 (K), Q2.2 (S), S1.1
unnamed: IC1.7 (WAKE_SW), U1.41 (PB5)
unnamed: IC2.2 (PROG2), R8.1
unnamed: IC3.1 (OD), Q1.4 (G)
unnamed: IC3.2 (CS), R9.1
unnamed: IC3.3 (OC), Q1.6 (G)
unnamed: Q3.3 (D), R3.1, R4.1, U2.1, U3.1
unnamed: R1.1, U2.2
unnamed: R2.1, U3.2
unnamed: R7.2, U6.6 (SHDN)
unnamed: R13.2, R14.1, U1.11 (PA1)
unnamed: R15.2, R16.1, U1.25 (*PB12)
VCC: C13.1, C17.1, C18.1, D1.2 (A), IC2.4 (VCC4), IC2.8 (CE), J4.1, Q2.1 (G), R6.1, R15.1, U4.5

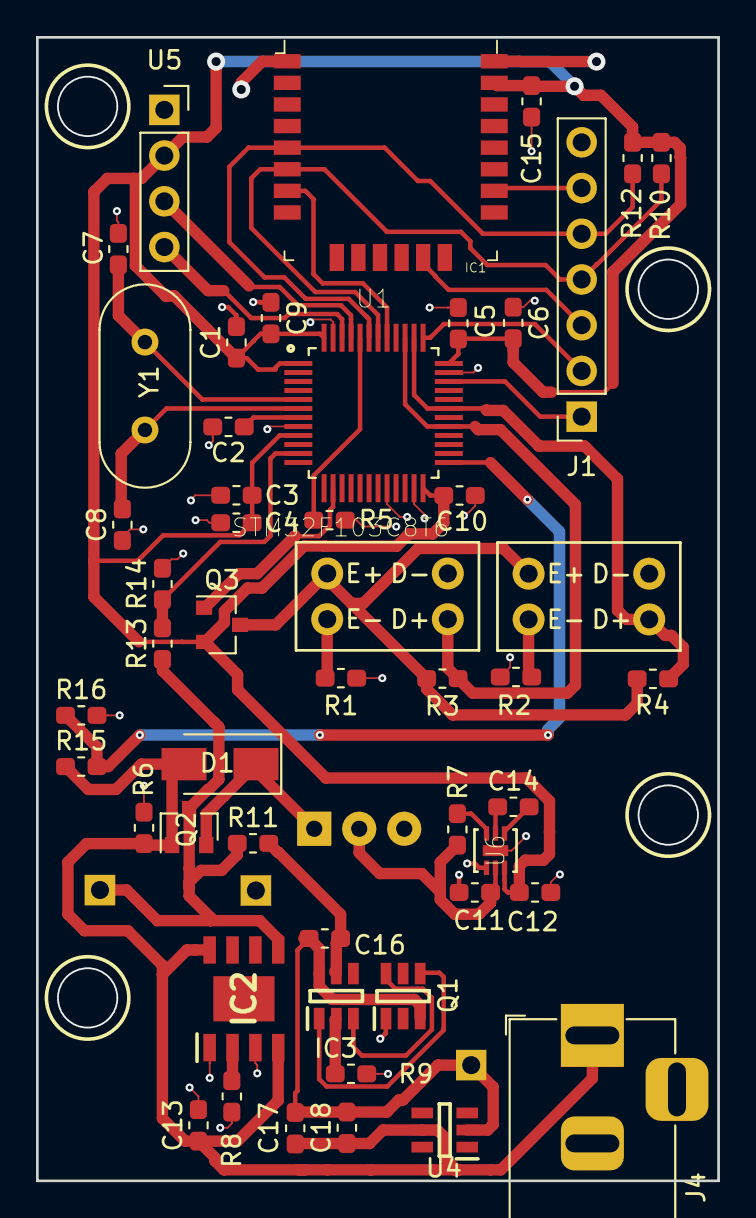
[picture p118: board EncoderBoard.kicad_pcb from above]

Board: 2 copper layers, 37.8 x 63.5 mm, 54 parts (0 on the bottom side), 35 nets.
