PaulMaxAvalosAguilar/NN54/Mechatronics/NONEABISoftware/AvrCode/Src_Modules/MicroC_Application/src/ENCODER/NONCOMUNICATION_PERIPHEREALS/Encoder.h

#ifndef ENCODER_H
#define ENCODER_H

#include <inttypes.h>

extern volatile uint16_t encoderCounter;

void initEncoder(void);
void ext_interruptConfig(void);
void timer1Config(void);
int8_t getPositionValues(uint16_t *target);

#endif
