PaulMaxAvalosAguilar/NN54/Mechatronics/NONEABISoftware/EncoderBoard/Headers/libopencm3/stm32/common/gpio_common_f24.h

/** @addtogroup gpio_defines
 *
 * @author @htmlonly &copy; @endhtmlonly 2011
 * Fergus Noble <fergusnoble@gmail.com>
 * @author @htmlonly &copy; @endhtmlonly 2012
 * Ken Sarkies <ksarkies@internode.on.net>
 *
 */
/*
 * This file is part of the libopencm3 project.
 *
 * Copyright (C) 2011 Fergus Noble <fergusnoble@gmail.com>
 * Copyright (C) 2012 Ken Sarkies <ksarkies@internode.on.net>
 *
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
 * You should have received a copy of the GNU Lesser General Public License
 * along with this library.  If not, see <http://www.gnu.org/licenses/>.
 */

/* THIS FILE SHOULD NOT BE INCLUDED DIRECTLY, BUT ONLY VIA GPIO.H
The order of header inclusion is important. gpio.h includes the device
specific memorymap.h header before including this header file.*/

/** @cond */
#ifdef LIBOPENCM3_GPIO_H
/** @endcond */
#ifndef LIBOPENCM3_GPIO_COMMON_F24_H
#define LIBOPENCM3_GPIO_COMMON_F24_H

/**@{*/

#include <libopencm3/stm32/common/gpio_common_f234.h>

/* GPIO port base addresses (for convenience) */
/** @defgroup gpio_port_id GPIO Port IDs
@ingroup gpio_defines

@{*/
#define GPIOG				GPIO_PORT_G_BASE
#define GPIOH				GPIO_PORT_H_BASE
#define GPIOI				GPIO_PORT_I_BASE
#define GPIOJ				GPIO_PORT_J_BASE
#define GPIOK				GPIO_PORT_K_BASE
/**@}*/

/* --- GPIO registers for STM32F2, STM32F3 and STM32F4 --------------------- */

/* Port mode register (GPIOx_MODER) */
#define GPIOG_MODER			GPIO_MODER(GPIOG)
#define GPIOH_MODER			GPIO_MODER(GPIOH)
#define GPIOI_MODER			GPIO_MODER(GPIOI)
#define GPIOJ_MODER			GPIO_MODER(GPIOJ)
#define GPIOK_MODER			GPIO_MODER(GPIOK)

/* Port output type register (GPIOx_OTYPER) */
#define GPIOG_OTYPER			GPIO_OTYPER(GPIOG)
#define GPIOH_OTYPER			GPIO_OTYPER(GPIOH)
#define GPIOI_OTYPER			GPIO_OTYPER(GPIOI)
#define GPIOJ_OTYPER			GPIO_OTYPER(GPIOJ)
#define GPIOK_OTYPER			GPIO_OTYPER(GPIOK)

/* Port output speed register (GPIOx_OSPEEDR) */
#define GPIOG_OSPEEDR			GPIO_OSPEEDR(GPIOG)
#define GPIOH_OSPEEDR			GPIO_OSPEEDR(GPIOH)
#define GPIOI_OSPEEDR			GPIO_OSPEEDR(GPIOI)
#define GPIOJ_OSPEEDR			GPIO_OSPEEDR(GPIOJ)
#define GPIOK_OSPEEDR			GPIO_OSPEEDR(GPIOK)

/* Port pull-up/pull-down register (GPIOx_PUPDR) */
#define GPIOG_PUPDR			GPIO_PUPDR(GPIOG)
#define GPIOH_PUPDR			GPIO_PUPDR(GPIOH)
#define GPIOI_PUPDR			GPIO_PUPDR(GPIOI)
#define GPIOJ_PUPDR			GPIO_PUPDR(GPIOJ)
#define GPIOK_PUPDR			GPIO_PUPDR(GPIOK)

/* Port input data register (GPIOx_IDR) */
#define GPIOG_IDR			GPIO_IDR(GPIOG)
#define GPIOH_IDR			GPIO_IDR(GPIOH)
#define GPIOI_IDR			GPIO_IDR(GPIOI)
#define GPIOJ_IDR			GPIO_IDR(GPIOJ)
#define GPIOK_IDR			GPIO_IDR(GPIOK)

/* Port output data register (GPIOx_ODR) */
#define GPIOG_ODR			GPIO_ODR(GPIOG)
#define GPIOH_ODR			GPIO_ODR(GPIOH)
#define GPIOI_ODR			GPIO_ODR(GPIOI)
#define GPIOJ_ODR			GPIO_ODR(GPIOJ)
#define GPIOK_ODR			GPIO_ODR(GPIOK)

/* Port bit set/reset register (GPIOx_BSRR) */
#define GPIOG_BSRR			GPIO_BSRR(GPIOG)
#define GPIOH_BSRR			GPIO_BSRR(GPIOH)
#define GPIOI_BSRR			GPIO_BSRR(GPIOI)
#define GPIOJ_BSRR			GPIO_BSRR(GPIOJ)
#define GPIOK_BSRR			GPIO_BSRR(GPIOK)

/* Port configuration lock register (GPIOx_LCKR) */
#define GPIOG_LCKR			GPIO_LCKR(GPIOG)
#define GPIOH_LCKR			GPIO_LCKR(GPIOH)
#define GPIOI_LCKR			GPIO_LCKR(GPIOI)
#define GPIOJ_LCKR			GPIO_LCKR(GPIOJ)
#define GPIOK_LCKR			GPIO_LCKR(GPIOK)

/* Alternate function low register (GPIOx_AFRL) */
#define GPIOG_AFRL			GPIO_AFRL(GPIOG)
#define GPIOH_AFRL			GPIO_AFRL(GPIOH)
#define GPIOI_AFRL			GPIO_AFRL(GPIOI)
#define GPIOJ_AFRL			GPIO_AFRL(GPIOJ)
#define GPIOK_AFRL			GPIO_AFRL(GPIOK)

/* Alternate function high register (GPIOx_AFRH) */
#define GPIOG_AFRH			GPIO_AFRH(GPIOG)
#define GPIOH_AFRH			GPIO_AFRH(GPIOH)
#define GPIOI_AFRH			GPIO_AFRH(GPIOI)
#define GPIOJ_AFRH			GPIO_AFRH(GPIOJ)
#define GPIOK_AFRH			GPIO_AFRH(GPIOK)

/**@}*/
#endif
/** @cond */
#else
#warning "gpio_common_f24.h should not be included explicitly, only via gpio.h"
#endif
/** @endcond */
