PaulMaxAvalosAguilar/NN54/Mechatronics/NONEABISoftware/EncoderBoard/Src_Modules/CortexM3App/src/BLUETOOTH/bluetooth.c

#include "FreeRTOS.h"
#include "semphr.h"
#include <libopencm3/stm32/gpio.h>
#include <libopencm3/cm3/nvic.h>
#include <libopencm3/stm32/rcc.h>
#include <libopencm3/stm32/timer.h>
#include <string.h>
#include <stdlib.h>
#include "bluetooth.h"
#include "CUSTOM/PRINTF/printf.h"
#include "ring.h"
#include "lcd.h"

//PRIVATE SERVICE CHARACTERISTIC UUID (no more than 1 in rn4020)
const char private_service_UUID[] = "11223344556677889900AABBCCDDEEFF";

//128 CHARACTERISTIC UUID
const char characteristic_UUID[] = "010203040506070809000A0B0C0D0FFF";

//UUIDHANDLEmatchesFound BITS (should be in ascending order
//beginning from 0)
#define CHARACTERISTIC_0MATCH 0


//PRIVATE CHARACTERISTICS ALIAS
#define CORRUPTION CHARACTERISTIC_0MATCH

typedef enum{
  CMD,
  CONNECTED,
  CONNECTION_END,
  BONDED,
  ENDLS,
  AOKORERR
}actions;

typedef struct{
  uint8_t handleFound;
  uint16_t handle;
  uint8_t notificationEnabled;
  uint8_t isNotifying;
} characteristicStatus_t;
characteristicStatus_t  characteristicStatus;

char printBuffer[100];

//-------------- BLUETOOTH COMMANDS---------------
//Only pair characters can be send (one byte in hex) with
//writing characteristics functions other will be ignored
void runLockingCOMMAND(uint8_t* notifyChecking, const char * format, ...);
void advertise(void);
void unBond(void);
void stopAdvertising(void);
void sendLS(void);
void cleanPrivateService(void);
void setFactoryReset(uint8_t arg);
void setFeatures(uint32_t arg);
void setSupportedServices(uint32_t arg);
void setPrivateService(const char *arg);
void setPrivateCharacteristic(const char *service,
			      uint8_t properties,
			      uint8_t dataSize,
			      uint8_t securityFlag);
void setName(char *string);//No >  6 bytes when using private serviceo
void turnOffSubscription(void);

//-------------- USART PARSING FUNCTIONS----------
int parseWVLine(const char* line);
int parseWCLine(const char* line);
int parseUUIDLine(const char* line);
void unlockWaitingLineParsing(char *buffer,
			      int* waitingState, int *errorDetection);

//-------------- RN4020 configuration------------
void bluetoothConfig(int configuration);


void writeEncoderData(uint8_t centralCode,
			char traveledDistance[3],
			char meanPropulsiveVelocity[3],
			char peakVelocity[3]){

  runLockingCOMMAND(&characteristicStatus.isNotifying
		    ,"SHW,%04X,"
		    "%02X"//Protocol Message initiator character 
		    "%02X"//Central code for Encoder Data
		    "%04X"//traveledDistance
		    "%04X"//meanPropulsiveVelocity
		    "%04X"//peakVelocity
		    "%02X\n",//Protocol Message terminator character
		    characteristicStatus.handle,
		    PROTOCOL_INITIATOR,
		    centralCode,
		    ((traveledDistance[0]<<8) | traveledDistance[1]),
		    ((meanPropulsiveVelocity[0]<<8) | meanPropulsiveVelocity[1]),
		    ((peakVelocity[0]<<8) | peakVelocity[1]),
		    PROTOCOL_TERMINATOR);
}

void writeEncoderStartValue(uint8_t centralCode){
  runLockingCOMMAND(&characteristicStatus.isNotifying
		    ,"SHW,%04X,"
		    "%02X"//Protocol Message initiator character 
		    "%02X"//Central code for Encoder Start
		    "%02X\n",//Protocol Message terminator character
		    characteristicStatus.handle,
		    PROTOCOL_INITIATOR,
		    centralCode,
		    PROTOCOL_TERMINATOR);
}

void writeBatteryLevel(uint8_t centralCode,
		       char level[3]){
  runLockingCOMMAND(&characteristicStatus.isNotifying
		    ,"SHW,%04X,"
		    "%02X"//Protocol Message initiator character 
		    "%02X"//Central code for Battery Level
		    "%04X"//BatteryLevel
		    "%02X\n",//Protocol Message terminator character
		    characteristicStatus.handle,
		    PROTOCOL_INITIATOR,
		    centralCode,
		    ((level[0]<<8) | level[1]),
		    PROTOCOL_TERMINATOR);

}

void writeEncoderStop(uint8_t centralCode){
  runLockingCOMMAND(&characteristicStatus.isNotifying
		    ,"SHW,%04X,"
		    "%02X"//Protocol Message initiator character 
		    "%02X"//Central code for Encoder Stop
		    "%02X\n",//Protocol Message terminator character
		    characteristicStatus.handle,
		    PROTOCOL_INITIATOR,
		    centralCode,
		    PROTOCOL_TERMINATOR
		    );
}

void writeEncoderChargingStatus(uint8_t centralCode,
				char chargingStatus[3]){
  runLockingCOMMAND(&characteristicStatus.isNotifying
		    ,"SHW,%04X,"
		    "%02X"//Protocol Message initiator character 
		    "%02X"//Central code for Encoder ChargingStatus
		    "%04X"//chargingStatus
		    "%02X\n",//Protocol Message terminator character
		    characteristicStatus.handle,
		    PROTOCOL_INITIATOR,
		    centralCode,
		    ((chargingStatus[0]<<8) | chargingStatus[1]),
		    PROTOCOL_TERMINATOR);
}

void runLockingCOMMAND(uint8_t* notifyChecking, const char * format, ...){

    int notifyCheckingIsNull= 1;
  uint8_t *notifyActive = notifyChecking;
  int previousNotifyActive;
  
  if(notifyChecking != NULL){
    notifyCheckingIsNull = 0;
    previousNotifyActive = *notifyActive;
  }

  //NOTES FOR NOTIFYCHECKING CHANGES DUE TO
  //READING STATE AND ACTUAL STATE OF BLUETOOTH MODULE

  //From 0 -> 1 there won't be a second AOK waiting,
  //if second AOKs come remaining AOKS will be subsecuently cleaned in main loop or
  //in this function
  //if no second AOKs come there is no problem

  //From 1 -> 0 there will be a second AOK waiting,
  //If second AOKs come, if interpreted by unlockWaitingLineParsing waitingState
  //will be broken
  
  //If no second AOKs come, if in second wait and realNotifications is not Active
  //or changes by genericLineParsing while looping waiting state will be broken
  //by second wait 1->0 lock detection section
  
  //Clean Serial
  while(receiveBuffer[receiveBufferPos]){
    getLine();
    genericParsing(parseBuffer);
  }

  //Send Command
  va_list args;
  va_start(args, format);
  vsnprintf(printBuffer,100,format,args);
  va_end(args);
  printStringUART(printBuffer);
  //Send Command

  int waitingMax = 2;
  int errorDetection = 0;
  //waiting loop
  for(int i = 0; i < waitingMax; i ++){
    int waitingState = 1;
    
    while(waitingState){

      if(receiveBuffer[receiveBufferPos]){
	getLine();
	genericParsing(parseBuffer);
	unlockWaitingLineParsing(parseBuffer, &waitingState, &errorDetection);
      }
      
      //second wait 1->0 lock detection section
      if( (i == 1) && (!(*notifyActive))){
	waitingState =0; 
      }
      
    }

    if(notifyCheckingIsNull){
      i = waitingMax;
    }else if(!(previousNotifyActive)){
      i = waitingMax;
    }else if(errorDetection){
      i = waitingMax;
    }

  }
}

void advertise(){
  runLockingCOMMAND(NULL,"A\n");
}

void unBond(){
  runLockingCOMMAND(NULL,"U\n");
}

void stopAdvertising(){
 runLockingCOMMAND(NULL,"Y\n");
}

void sendLS(){
  characteristicStatus.handleFound = 0;
  runLockingCOMMAND(NULL,"LS\n");
}

void cleanPrivateService(){
  runLockingCOMMAND(NULL,"PZ\n");
}

void setFactoryReset(uint8_t arg){
  runLockingCOMMAND(NULL,"SF,%d\n",arg);
}

void setFeatures(uint32_t arg){
  runLockingCOMMAND(NULL,"SR,%08lX\n",arg);
}

void setSupportedServices(uint32_t arg){
  runLockingCOMMAND(NULL,"SS,%08lX\n",arg);
}

void setPrivateService(const char *arg){
  runLockingCOMMAND(NULL,"PS,%s\n",arg);
}

void setPrivateCharacteristic(const char *service,
			      uint8_t properties,
			      uint8_t dataSize,
			      uint8_t securityFlag){
  if(securityFlag != 0){

    runLockingCOMMAND(NULL,"PC,%s,%02X,%02X,%02X\n",
		      service,
		      properties,
		      dataSize,
		      securityFlag);
  
  }else{

    runLockingCOMMAND(NULL,"PC,%s,%02X,%02X\n",
		      service,
		      properties,
		      dataSize);   
  }
}

void setName( char *string){
  runLockingCOMMAND(NULL,"SN,%s\n", string);
}

void turnOffSubscription(void){
  uint16_t subscriptionHandle =
    characteristicStatus.handle + 1;
  runLockingCOMMAND(NULL
		    ,"SHW,%04X,0000\n",
		    subscriptionHandle);
}

int parseWVLine(const char* line){
  if(strncmp(line,"WV,",3) != 0){
    return 0;
  }

  char twoByteBuffer[5];

  //Begin at line 8
  //WV,FFFF,7C01FFFF02027C
  strncpy(twoByteBuffer, line+10,2);
  twoByteBuffer[2] = 0;
  uint8_t code = strtol(twoByteBuffer, NULL, 16);
  code = decodeOneByte(code);

  if(code == forEncoderDevicePCMCode_encoderStart){

    encoderTaskParamTypes_t dataToSend;

    //Get minDistToTravel
    strncpy(twoByteBuffer, line+12,4);
    twoByteBuffer[4] = 0;
    dataToSend.minDistToTravel = strtol(twoByteBuffer,NULL,16);
    dataToSend.minDistToTravel = decodeTwoBytes(dataToSend.minDistToTravel>>8,(uint8_t)dataToSend.minDistToTravel);

    //Get desiredCountDir
    strncpy(twoByteBuffer, line+16,2);
    twoByteBuffer[2] = 0;
    dataToSend.desiredCounterDirection = strtol(twoByteBuffer,NULL,16);
    dataToSend.desiredCounterDirection = decodeOneByte((uint8_t)dataToSend.desiredCounterDirection)-1;

    //Get desiredRepDir
    strncpy(twoByteBuffer, line+18,2);
    twoByteBuffer[2] = 0;
    dataToSend.desiredRepDirection = strtol(twoByteBuffer,NULL,16);
    dataToSend.desiredRepDirection = decodeOneByte((uint8_t)dataToSend.desiredRepDirection)-1;

    //Should go before creating encoderTask------------------------------
    (batteryWaitTaskHandle != NULL)? vTaskSuspend(batteryWaitTaskHandle): "";

    turnOnEncoderSensors();//should go before initializeTimers()
    initializeTimers();//Clock gating, should go before clearing ring buffer
    sendToProtocolMessagesTXRequestQueue(protocolMessagesTXRequestCode_start,0,0,0);
    ring_buffer_clear(&encoder_ring);//Clear ring buffer

    //Should go before creating encoderTask------------------------------
    createTask(encoderTask, "encoderTask",ENCODERTASK_SIZE,
	       &dataToSend, ENCODERTASK_PRIORITY,
	       &encoderTaskHandle);
    
  }else if(code == forEncoderDevicePCMCode_encoderStop){

    deleteTask(&encoderTaskHandle);
    //Should go after deleting encoderTask-------------------------------
    sendToProtocolMessagesTXRequestQueue(protocolMessagesTXRequestCode_Stop,0,0,0);
    stopTimers();
    turnOffEncoderSensors();
    vTaskResume(batteryWaitTaskHandle);
    //Should go after deleting encoderTask-------------------------------
    
  }else if(code == forEncoderDevicePCMCode_encoderBattery){
    (batteryWaitTaskHandle != NULL)? xTaskNotifyGive(batteryWaitTaskHandle) : 0;
  }

  return 1;
}

int parseWCLine(const char* line){

  //Check if received line contains a WC message
  if(strncmp(line, "WC,",3) != 0){
    return 0;
  }

  //Copy handle string part to a buffer
  char handleStr[5];
  strncpy(handleStr, line + 3, 4);
  handleStr[4] = '\0';

  //Convert string to a number
  uint16_t handle = strtol(handleStr, NULL, 16);

  //Compare received handle to stored handle

  //If received handle is equal to stored handle
  if((characteristicStatus.handle + 1)
     == handle){

    //Read value in received line
    const char* dataStringPtr = line + 8;
    if((strncmp(dataStringPtr,"0100",4) == 0) ||
       (strncmp(dataStringPtr,"0200",4) == 0)
       ){
      characteristicStatus.isNotifying=1;
    }else{
      characteristicStatus.isNotifying=0;
    }
  }    


  return 1;
}

int parseUUIDLine(const char* line) {

  //Check if line is a UUID Line
  if (strncmp(line, "  ", 2) != 0) {
    return 0;
    
  }

  //Identify UUID
  const char* startOfUUIDPtr = line + 2;
  const char* firstCommaPtr = strchr(startOfUUIDPtr, ',');
  int UUIDlength = firstCommaPtr - startOfUUIDPtr;
  char UUIDline[50];
  
  strncpy(UUIDline, startOfUUIDPtr, UUIDlength);
  UUIDline[UUIDlength] = '\0';
  
  //Identify HANDLE
  char handleStr[5];
  
  strncpy(handleStr, firstCommaPtr + 1, 4);
  handleStr[4] = 0;
  uint16_t handle = strtol(handleStr, NULL, 16);

  //If handle is not set, set match
  if(characteristicStatus.handleFound == 0 ){
    characteristicStatus.handleFound = 1;
    characteristicStatus.handle = handle;
  }else{
    //Notification or indication handle was received
    //indicate subscription is available for the characteristic
    characteristicStatus.notificationEnabled = 1;
  }
  
  return 1;
}


void unlockWaitingLineParsing(char *buffer,
				     int* waitingState, int *errorDetection){
  //INTERPRET
  if((strstr(buffer, "AOK") != NULL) ||
     (strstr(buffer, "END") != NULL)      
     ){
    *waitingState = 0;
      
  }else if (strstr(buffer,"ERR") != NULL){
    //If an ERR is received no second aok will come therefore we skip
    //otherwise communication is gonna lock waiting for no coming aok
    *errorDetection = 1;
    *waitingState = 0;
  }
}


void  __attribute__((optimize("O0"))) genericParsing(char *buffer){
  
  //INTERPRET
  if(strstr(buffer, "Connection End") != NULL){

    //In case no stop was ever received-----------------------------------
    deleteTask(&encoderTaskHandle);
    stopTimers();//Should go after deleting encoder task
    turnOffEncoderSensors();//Should go after delting encoder task
    //In case no stop was ever received-----------------------------------
    sendToHumanInterfaceDisplayRequestQueue(humanInterfaceDisplayRequestCode_connectionStatus,
					    0);
    deleteTask(&batteryWaitTaskHandle);
    createTask(batteryFreeTask,"batteryFreeTask2",
	       BATTERYFREETASK_SIZE,NULL,BATTERYFREETASK_PRIORITY
	       ,&batteryFreeTaskHandle);


    characteristicStatus.isNotifying = 0;

    if(characteristicStatus.notificationEnabled){
      turnOffSubscription();
    }


    unBond();
    advertise();
  
  }else if(strstr(buffer,"Connected") != NULL){
    sendToHumanInterfaceDisplayRequestQueue(humanInterfaceDisplayRequestCode_connectionStatus,
					    1);

    deleteTask(&batteryFreeTaskHandle);
    createTask(batteryWaitTask,"batteryWaitTask",
	       BATTERYWAITTASK_SIZE,NULL,BATTERYWAITTASK_PRIORITY,
	       &batteryWaitTaskHandle);

  }else if(strstr(buffer, "Bonded") != NULL){
      
  }else if(parseWVLine(buffer)){

  }else if(parseUUIDLine(buffer)){
    
  }else if(parseWCLine(buffer)){
    
  }else if(strstr(buffer, "CMD")!= NULL){
    bluetoothConfig(0);
    sendLS();
    stopAdvertising();
    advertise();	  
  }
}

void  bluetoothConfig(int configuration){

  if(configuration == 1){

    //    setFactoryReset(1);//Should go first
    //    cleanPrivateService();//Should go after Factory reset for services to show
    setFeatures(RN4020_FEATURE_PERIFERAL | RN4020_FEATURE_DO_NOT_SAVE_BONDING
		| RN4020_FEATURE_NO_DIRECT_ADVERTISE
		| RN4020_FEATURE_SERVER_ONLY); //SERVER ONLY REDUCES OVERHEAD
    setSupportedServices(RN4020_SERVICE_USER_DEFINED );

    //SET PRIVATE SERVICE (JUST ONE IN RN4020)
    setPrivateService(private_service_UUID);

    //CONFIGURE ENCODER
    setPrivateCharacteristic(characteristic_UUID,
			     RN4020_PRIVATE_CHARACTERISTIC_PROPERTY_NOTIFY |
			     RN4020_PRIVATE_CHARACTERISTIC_PROPERTY_WRITE,
			     20,
			     RN4020_PRIVATE_CHARACTERISTIC_SECURITY_NONE 
			     );
    
    setName("VBT");//No more than 6 bytes when using private service

     
  }else if(configuration == 2){
    setFactoryReset(2);
  }
}
