PaulMaxAvalosAguilar/NN54/(commit log)

2019-04-21 Added thread safe printf support
2019-04-29 Advances for Sensor Positioning
2019-05-24 Added drawings
    [Encoder.fcstd]
2019-05-28 Finished advances
    [Base.fcstd, BaseImp.fcstd, BaseImp.stl, DiscoAImp.stl, DiscoBImp.stl, DiscoDentadoA.fcstd, DiscoDentadoAImp.fcstd, DiscoDentadoB.fcstd]
2019-05-29 Apparently finished
    [Encoder.fcstd]
2019-05-29 Model corrected
    [Encoder.fcstd]
2019-05-31 Finished Encoder design
    [AnclaParteABTopeextr.stl, BaseSopbalHuecosoptracc.stl, DiscoComplSujFleExtr.stl, Encoder.fcstd, EncoderIDEAL.fcstd, PiezaFlechaCuerpoResorteHueco.stl, SoporteTraccionHuecoAncla .stl, Tapamovilextr.stl]
2019-06-08 Modified name
    [Encoder.fcstd, EncoderIDEAL.fcstd, EncoderNew.FCStd]
2019-06-09 Added Fillets
    [Encoder.fcstd, EncoderNew.FCStd]
2019-06-10 Added changes
    [Encoder.fcstd, EncoderNew.FCStd]
2019-06-12 Final changes
    [Ancla.stl, AnclaParteABTopeextr.stl, Base.stl, BaseSopbalHuecosoptracc.stl, Cuerpo.stl, DiscoComplSujFleExtr.stl, DiscoDentado.stl, Encoder.fcstd]
2019-07-09 Added timer configuration
2019-07-16 Added timer functionality
    [EncoderError.xlsx]
2019-09-01 Added changes to Freecad design
    [EncoderNew.FCStd]
2019-11-03 Added SensorsBoard Gerbers
    [SensorsBoard.kicad_pcb]
2019-11-09 Modified uart(FUNCTIONAL)
2019-11-09 Board Changes
    [SensorsBoard-B_Cu.gbr, SensorsBoard-B_Mask.gbr, SensorsBoard-B_Paste.gbr, SensorsBoard-B_SilkS.gbr, SensorsBoard-Edge_Cuts.gbr, SensorsBoard-F_Cu.gbr, SensorsBoard-F_Mask.gbr, SensorsBoard-F_Paste.gbr]
2019-12-21 Updated changes
    [EncoderNew.FCStd, RearWall.dwg]
2019-12-29 Modified ABISoftware (App)
    [EncoderNew.FCStd]
2020-01-07 Scanning changes
    [Ancla.stl, BareBase.dwg, Base.stl, BoardBase(Bottom).dwg, BoardBase(Middle).dwg, BoardBase(Top).dwg, BoardBase.stl, BolaSujeccion.stl]
2020-01-08 Added low power features
    [EncoderNew.FCStd]
2020-01-11 Added 2d and 3d images
    [EncoderNew.FCStd]
2020-01-13 Mean propulsive algorithm added
    [Ancla.stl, BareBase.dwg, Base.stl, BoardBase(Bottom).dwg, BoardBase(Middle).dwg, BoardBase(Top).dwg, BolaSujección.stl, DiscoDentado.stl]
2020-01-14 Encoder Task Changes (Velocity calculation algorithm
2020-01-16 Encoder parameters code
2020-02-04 Added changes without timer error
    [blescannermodel.cpp, blescannermodel.h, bluetooth.c, connectionhandling.cpp]
2020-02-04 Battery charging status finalized
2020-02-06 Apparently timer problem solved
    [bluetooth.c, connectionhandling.cpp, main.c]
2020-02-07 Added new Support
    [EncoderNew.FCStd, SoporteBateria.dwg]
2020-02-08 Added instructions
    [EncoderNew.FCStd]
2020-02-19 Instructive changed
    [EncoderError.xlsx, EncoderNew.FCStd]
2020-03-02 Mechanical Changes
    [DiscoDentado.stl, EncoderNew.FCStd]
2020-03-02 Final changes to 3d model
    [EncoderNew.FCStd]
2020-03-03 Added debugging capabilities
    [stlink-v2.cfg, stm32f1x.cfg]
2020-03-04 Added debug functionality
    [stlink-v2.cfg, stm32f1x.cfg]
2020-04-15 New Formula
    [Encoder Characteristics.xlsx]
2020-06-21 New Calculations
    [Encoder Characteristics.xlsx]
2020-06-22 Units measurment added
    [Encoder Characteristics.xlsx]
2020-07-02 New Changes
    [EncoderBoard.kicad_pcb, EncoderBoard.sch, EncoderBoard2.sch, LQFP-48_7x7mm_P0.5mm.step, Pin Header 1x1 TH Pitch 2.54mm.stp, PinHeader_1x01_P2.54mm_Vertical.step, PinHeader_1x02_P2.54mm_Vertical.step, PinHeader_1x06_P2.54mm_Vertical.step]
2020-07-06 Change s
    [EncoderBoard2.kicad_pcb, EncoderBoard2.sch, Power.sch]
2020-07-09 Finished PCB
    [EncoderBoard2.kicad_pcb, EncoderBoard2.sch, Power.sch]
2020-07-09 Finished board png
2020-07-11 Schematic change
    [EncoderBoard2.sch]
2020-07-11 Final PCB
    [EncoderBoard2.kicad_pcb, EncoderBoard2.sch, Pin Header 1x7 TH Pitch 2.54mm.stp, PinHeader_1x07_P2.54mm_Vertical.step]
2020-07-14 Magnetic sensors board done
    [BMagSensBoard.kicad_pcb, BMagSensBoard.sch, User Library-so8-3.step]
2020-07-16 Deleted KiBoM & BOM generated
    [EncoderBoard2.csv, EncoderBoard2.kicad_pcb, EncoderBoard2.sch, EncoderBoard2.xlsx]
2020-07-17 Moved directory
    [EncoderBoard2.csv, EncoderBoard2.sch, EncoderBoard2.xlsx, Power.sch]
2020-07-17 Removed csv
    [EncoderBoard2.csv]
2020-07-18 Reuploaded pcb
    [EncoderBoard2.kicad_pcb]
2020-07-18 Added Gerbers
    [EncoderBoard2-B_Cu.gbr, EncoderBoard2-B_Mask.gbr, EncoderBoard2-B_SilkS.gbr, EncoderBoard2-Edge_Cuts.gbr, EncoderBoard2-F_Cu.gbr, EncoderBoard2-F_Mask.gbr, EncoderBoard2-F_SilkS.gbr, EncoderBoard2.drl]
2020-07-18 Added gerber files
    [BMagSensBoard.kicad_pcb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]
2020-07-19 Changed name
    [EncoderBoard2.kicad_pcb, EncoderBoard2.sch, EncoderBoard2.xlsx]
2020-07-19 Changed files
    [BMagSensBoard-B_Cu.gbr, BMagSensBoard-B_Mask.gbr, BMagSensBoard-B_SilkS.gbr, BMagSensBoard-Edge_Cuts.gbr, BMagSensBoard-F_Cu.gbr, BMagSensBoard-F_Mask.gbr, BMagSensBoard-F_SilkS.gbr, BMagSensBoard.drl]
2020-07-21 Changed directory
    [EncoderBoard2.xlsx]
2020-07-22 pin header change
    [EncoderBoard2.kicad_pcb, EncoderBoard2.sch, PinHeader_1x03_P2.54mm_Vertical.step, Power.sch]
2020-07-22 Recreated gerbers
    [EncoderBoard2-B_Cu.gbr, EncoderBoard2-B_Mask.gbr, EncoderBoard2-B_SilkS.gbr, EncoderBoard2-Edge_Cuts.gbr, EncoderBoard2-F_Cu.gbr, EncoderBoard2-F_Mask.gbr, EncoderBoard2-F_SilkS.gbr, EncoderBoard2.drl]
2020-07-24 Changed panelization shape
    [BMagSensBoard-B_Cu.gbr, BMagSensBoard-B_Mask.gbr, BMagSensBoard-B_SilkS.gbr, BMagSensBoard-Edge_Cuts.gbr, BMagSensBoard-F_Cu.gbr, BMagSensBoard-F_Mask.gbr, BMagSensBoard-F_SilkS.gbr, BMagSensBoard.drl]
2020-08-03 Introduced G4 code
    [stlink-v2.cfg, stm32f1x.cfg]
2020-08-08 Corrections applied
    [EncoderBoard2-B_Cu.gbr, EncoderBoard2-B_Mask.gbr, EncoderBoard2-B_SilkS.gbr, EncoderBoard2-Edge_Cuts.gbr, EncoderBoard2-F_Cu.gbr, EncoderBoard2-F_Mask.gbr, EncoderBoard2-F_SilkS.gbr, EncoderBoard2-NPTH.drl]
2020-08-09 Added I2C configuration
2020-08-10 Changes for bluetooth programmer code
    [stlink-v2.cfg, stm32f1x.cfg]
2020-08-12 Added debug capabilities
    [BMagSensBoard.step, BMagSensBoard.stl, stlink-dap.cfg, stlink-v2.cfg, stlink.cfg, stm32f1x.cfg, stm32g4x.cfg]
2020-08-12 Added UART
2020-08-13 Added USART basic configuration
    [Encoder Characteristics.xlsx]
2020-08-16 Upgrades for dma
2020-08-17 Added DMA transmit
2020-08-18 Added DMA receive
2020-08-21 Added I2C functionality
2020-08-22 LCD pre DMA
2020-08-23 Added I2C DMA
2020-08-26 Added encoder mode
2020-08-29 Added timer interrupt functionality
    [Encoder Characteristics.xlsx]
2020-08-31 Added charging detection capabilities
    [EncoderBoard2.kicad_pcb]
2020-09-02 Added low power functionality
    [Encoder Characteristics.xlsx]
2020-09-03 Added lpr correction
    [Encoder Characteristics.xlsx]
2020-09-03 Added corrections to software
    [main.c]
2020-09-08 Added pin testing
2020-09-10 Added ADC code
2020-09-18 Added ADC clean oversampler
2020-10-04 adc code added
2020-10-05 Encoder Parsing capabilities added
2020-10-06 Added encoder protocol
2020-10-07 Added new protocol and uartTXQueue
2020-10-08 Custom functions folder and Timer initialization added
2020-10-09 Added uartTX protocol
2020-10-15 Added encoder task and adc redesign improvements
    [main.c, main.h]
2020-10-15 Added adc suspension
2020-10-18 Added void parameters for encoderTask
2020-10-26 Encoder Task finally finished (thank's God)
    [stlink.cfg, stm32f1x.cfg]
2020-10-27 Removed unnecesary openocd binaries and dll's
    [stlink-dap.cfg, stlink.cfg, stm32g4x.cfg]
2020-11-02 Changed uart directory
2020-11-08 Removed UART double ring architecture
2020-12-18 Charging status implemented, stack problem solved
    [connectionhandling.cpp, main.c, main.h]
2020-12-26 Finished rev 1 device
    [Encoder Characteristics.xlsx]
2021-01-27 PCB changes
    [BAccSensBoard.kicad_pcb, BAccSensBoard.sch, BMagSensBoard.step, Encoder Characteristics.xlsx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]
2021-05-05 Non plus ultra changes
    [BAccSensBoard.kicad_pcb, BAccSensBoard.sch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]
2022-01-18 Mass production changes
    [BareBase.dwg, BoardBase(Bottom).dwg, BoardBase(Middle).dwg, BoardBase(Top).dwg, Encoder Characteristics.xlsx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]
