PaulMaxAvalosAguilar/NN54/(notices)

Notices in the files:
Mechatronics/NONEABISoftware/RN4871_Programmer/Headers/libopencm3/msp432/e4/gpio.h:
This library is free software: you can redistribute it and/or modify
it under the terms of the GNU Lesser General Public License as published by
the Free Software Foundation, either version 3 of the License, or
(at your option) any later version.
Mechatronics/Hardware/Electrical/FootPrints/3DModels/JST/JST_EH_B4B-EH-A_1x04_P2.50mm_Vertical.step:
Copyright (C) 2019, Rene Poeschl
This work is licensed under the [Creative Commons CC-BY-SA 4.0 License](https://creativecommons.org/licenses/by-sa/4.0/legalcode),
with the following exception:
To the extent that the creation of electronic designs that use 'Licensed Material' can be considered to be 'Adapted Material',
You are free to use the library data in your own projects without the obligation to share your project files under this or any other license agreement.
Mechatronics/Hardware/Electrical/FootPrints/3DModels/PinHeaders/PinHeader_1x08_P2.54mm_Vertical.step:
Copyright (C) 2017, kicad StepUp
